alanarzamendi/planetary-gearbox-25-1/Report/Design_Rationale.html

DESIGN NOTEBOOK · TWO-STAGE PLANETARY GEARBOX

# Design rationale of the 25:1 planetary gearbox

The mathematics, standards and decisions behind the design: kinematics, load cases, gear capacity to ISO 6336, materials, bearings, shafts, fits and efficiency. Reasoning only; part dimensions live in the drawings.

Updated: 5 Nov 2026Plan steps covered: 2 to 9 (FEA, DFMA)Reproducible calculation: Calculations/02_design_calculations.py

## 01Kinematics and assembly conditions

Architecture: fixed ring, sun input and carrier output in both stages, three planets per stage. The Willis equation relates the speeds of the three members as seen from the carrier:

\[ \frac{\omega_s-\omega_c}{\omega_r-\omega_c} = -\frac{z_r}{z_s} \quad\xrightarrow{\;\omega_r=0\;}\quad i=\frac{\omega_s}{\omega_c}=1+\frac{z_r}{z_s}=1+\frac{72}{18}=5 \]

\[ i_{tot}=i_1\, i_2 = 5\cdot 5 = 25 \qquad n_2=\frac{3000}{25}=120\ \text{rpm} \]

Planet speed, absolute and relative to the carrier. The relative speed is what the teeth and the planet bearing see:

\[ \omega_p = \omega_c\left(1-\frac{z_r}{z_p}\right)=-\tfrac{5}{3}\,\omega_c \qquad n_{p,rel}=(n_s-n_c)\,\frac{z_s}{z_p} \]

### Geometric conditions (18/27/72, N = 3)

Condition | Equation | Value | Result
Coaxiality | \(z_r = z_s + 2z_p\) | 72 = 18 + 54 | pass
Equal-spacing assembly | \((z_s+z_r)/N \in \mathbb{Z}\) | 90 / 3 = 30 | pass
Adjacency (planets clear each other) | \(2a\sin(\pi/N) > d_{a,p}\) | 58.46 > 43.5 mm | 15 mm clearance
No undercut with x = 0 | \(z_{min}=2/\sin^2\alpha\) | 17.1 < 18 | pass

### Tooth phasing in the CAD assembly

Interference detection on all ten gears was run at the assembled pose and again after turning the input 7.3°, which is not a multiple of any tooth pitch. Every mesh engages. The largest overlap is 0.003 cm³, on the stage 1 ring and planet 1. That is a sliver of about 0.2 mm² across the 15 mm face width, or a few hundredths of a millimetre on the flank. A planet out of phase by half a pitch would overlap by about 0.045 cm³ per tooth. The overlaps come from the nominal profiles, which are modelled with zero backlash. The tooth thinning for backlash set in step 8 must be larger than this, on the stage 1 ring mesh in particular.

Speeds at 3000 rpm | \(n_s\) | \(n_c\) | \(n_s-n_c\) | \(n_{p,rel}\)
Stage 1 | 3000 | 600 | 2400 | 1600
Stage 2 | 600 | 120 | 480 | 320

## 02Torque basis and load cases

The design torque comes from the selected motor, not from an assumed number. Strength checks take \(\eta = 1\): all motor torque reaches every gear, which is the upper bound.

MotorYaskawa SGM7J-08A

Rated torque \(T_N\)2.39 N·m

Peak torque \(T_{max}\)8.36 N·m

Rated / max speed3000 / 6000 rpm

\[ T_{2N}=i\,T_N=25\cdot 2.39=59.8\ \text{N·m} \qquad T_{2B}=i\,T_{max}=25\cdot 8.36=209\ \text{N·m} \]

Case | Input torque | Factors | Cycles | Used for
Fatigue | 2.39 N·m | \(K_A=1.25\) | 10 000 h at 3000 rpm | pitting, bending, L10 life
Static / peak | 8.36 N·m | \(K_A=1.0\) | few cycles (static \(Z_{NT}, Y_{NT}\)) | overload, bearing \(S_0\)

Minimum safety factor | Value | Reason
Tooth bending \(S_{F,min}\) | 1.5 | a broken tooth is catastrophic (R-016)
Contact \(S_{H,min}\) | 1.2 | pitting is progressive and detectable
Bearing static \(S_0\) | 2.0 | starts and stops with shock
Shaft fatigue (simplified method) | 2.0 | margin for a method simpler than DIN 743

D-005 · Torque basis

Sizing uses the SGM7J-08A (2.39 / 8.36 N·m). It replaces the provisional 4 N·m in the requirements sheet and the 120 N·m overload, which had no physical origin. The motor's real peak gives 209 N·m, more demanding than those 120.

D-006 · Application factor

\(K_A = 1.25\): servo motor (uniform driver) with a driven machine of moderate shocks, from the guidance table of ISO 6336-6. The 10 000 h life is taken entirely at rated torque and speed, a harsher profile than a real servo duty cycle.

Confirmed for the 200 V SGM7J-08A: 2.39 N·m rated, 8.36 N·m instantaneous peak, 3000/6000 rpm, 80 mm flange, Ø19 shaft (Yaskawa Σ-7 transition guide and distributor datasheets). The motor's own bearings allow 392 N radial and 147 N axial on its shaft, a limit the coupling must respect (section 12).

## 03Gear geometry

Module \(m = 1.5\) mm, \(\alpha = 20^\circ\), spur teeth without profile shift (\(x=0\)), ISO 53 profile A basic rack (\(h_{aP}=1.0m,\ h_{fP}=1.25m,\ \rho_{fP}=0.38m\)), face width \(b = 15\) mm.

\[ d=m\,z \qquad d_b=d\cos\alpha \qquad d_a=d+2m \qquad d_f=d-2.5m \qquad a=\tfrac{1}{2}(d_s+d_p)=33.75\ \text{mm} \]

Transverse contact ratio (external sun–planet; in the internal mesh the ring tip radius is subtracted):

\[ \varepsilon_\alpha=\frac{\sqrt{r_{a1}^2-r_{b1}^2}+\sqrt{r_{a2}^2-r_{b2}^2}-a\sin\alpha}{\pi m\cos\alpha} \qquad \varepsilon_{\alpha,int}=\frac{\sqrt{r_{a2}^2-r_{b2}^2}-\sqrt{r_{a3}^2-r_{b3}^2}+a\sin\alpha}{\pi m\cos\alpha} \]

Mesh | \(\varepsilon_\alpha\) | Comment
Sun–planet (external) | 1.580 | > 1.4: continuous contact with margin
Planet–ring (internal) | 1.944 | the internal mesh wraps the tooth: more pairs in contact

### Rim thickness

ISO 6336-3 applies no rim penalty when \(s_R/h \ge 1.2\) (\(Y_B = 1\)), with tooth depth \(h = 2.25m = 3.375\) mm.

\[ \text{ring, at a tie-bolt hole: } s_R=\frac{128-6.6-111.75}{2}=4.83\ \text{mm}\ \Rightarrow\ \frac{s_R}{h}=1.43 \qquad \text{planet (}\varnothing18\text{ bore): } s_R=\frac{36.75-18}{2}=9.38\ \text{mm}\ \Rightarrow\ \frac{s_R}{h}=2.78 \]

The ring outside diameter is Ø140 since step 6 (section 17). Between the holes the rim is 14.1 mm; the thinnest section is under a Ø6.6 tie-bolt hole on the Ø128 circle.

## 04Tooth forces

Sun torque is shared by three planets. Tolerances make the sharing uneven, which \(K_\gamma\) accounts for:

\[ F_t=\frac{2000\,T_s}{d_s\,N}\,K_\gamma \qquad K_\gamma=1.16\ \ (\text{3 planets, no floating member; AGMA 6123}) \]

On the planet, the tangential forces from the sun and from the ring act in the same direction and the radial ones cancel, so the planet pin carries:

\[ F_{r,pin}=2F_t \]

Case | \(T_s\) [N·m] | \(F_t\) [N] | \(F_{r,pin}\) [N]
Stage 1, rated | 2.39 | 68 | 137
Stage 2, rated | 11.95 | 342 | 685
Stage 2, peak | 41.8 | 1197 | 2394

## 05Contact stress (ISO 6336-2)

\[ \sigma_H = Z_H Z_E Z_\varepsilon \sqrt{\frac{F_t}{d_1 b}\cdot\frac{u\pm1}{u}}\;\sqrt{K_A K_v K_{H\beta} K_{H\alpha}} \qquad (+\ \text{external},\ -\ \text{internal}) \]

\[ Z_H=\sqrt{\frac{2\cos\alpha}{\cos^2\alpha\,\sin\alpha}}=2.495 \qquad Z_E=189.8\sqrt{\text{MPa}} \qquad Z_\varepsilon=\sqrt{\frac{4-\varepsilon_\alpha}{3}} \]

\[ K_v=1+\left(\frac{K_1}{K_A F_t/b}+K_2\right)\frac{z_1 v}{100}\sqrt{\frac{u^2}{1+u^2}} \qquad K_1=14.9\ (\text{ISO 1328 grade 6}),\ K_2=0.0193 \]

\[ \sigma_{HP}=\frac{\sigma_{H,lim}\,Z_{NT}\,Z_L Z_v Z_R}{S_{H,min}} \]

Factor | Stage 1 | Stage 2 | Source
\(v\) relative to the carrier | 3.39 m/s | 0.68 m/s | \(\pi d_s (n_s-n_c)/60\,000\)
\(K_v\) | 1.086 | 1.017 | method C
\(K_{H\beta}\) | 1.15 | 1.15 | assumed: pins supported in both plates, \(b/d_1=0.56\); rechecked by method C in section 16
\(Z_\varepsilon\) sun–planet / planet–ring | 0.898 / 0.828 | | from \(\varepsilon_\alpha\)
Sun load cycles \(N_L\) | 4.3·10⁹ | 8.6·10⁸ | \(60\,L_h\,(n_s-n_c)\,N\)

Result (fatigue, rated) | \(\sigma_H\) [MPa] | \(S_H\)
Stage 1 · sun–planet | 282 | 4.61 | ≥ 1.2
Stage 1 · planet–ring | 130 | 5.26 | ≥ 1.2
Stage 2 · sun–planet | 610 | 2.18 | critical gear flank
Stage 2 · planet–ring | 281 | 2.42 | ≥ 1.2
Stage 2 · sun–planet, peak (static) | 1021 | 2.28 | ≥ 1.0

The ring is rated with its own material (42CrMo4 quenched and tempered) and its own cycles, \(60\,L_h\,n_c\,N\). Lubrication: grease with ISO VG 220 base oil; ground flanks (\(Z_R \approx 1\)).

## 06Tooth-root stress (ISO 6336-3, method B)

\[ \sigma_F=\frac{F_t}{b\,m}\,Y_F\,Y_S\,Y_\beta\,Y_B\;K_A K_v K_{F\beta} K_{F\alpha} \qquad K_{F\beta}=K_{H\beta}^{\,N_F},\ \ N_F=\frac{(b/h)^2}{1+b/h+(b/h)^2}=0.78 \]

\(Y_F\) is evaluated with the load at the outer point of single-pair contact, on the critical section at the 30° tangent to the root fillet:

\[ Y_F=\frac{6\,\dfrac{h_{Fe}}{m}\cos\alpha_{Fen}}{\left(\dfrac{s_{Fn}}{m}\right)^2\cos\alpha_n} \qquad Y_S=(1.2+0.13L)\,q_s^{\,1/(1.21+2.3/L)},\quad L=\frac{s_{Fn}}{h_{Fe}},\ q_s=\frac{s_{Fn}}{2\rho_F} \]

\[ \sigma_{FP}=\frac{\sigma_{F,lim}\,Y_{ST}\,Y_{NT}\,Y_M}{S_{F,min}} \qquad Y_{ST}=2 \qquad Y_M=0.7\ \text{for the planet} \]

The planet is an idler: each tooth is bent one way when it meshes with the sun and the other way with the ring. Reversed loading cuts fatigue strength to 70 % (\(Y_M = 0.7\)) and doubles the bending cycles.

Gear | \(Y_F\) | \(Y_S\) | \(\sigma_F\) rated S2 [MPa] | \(S_F\) rated S2 | \(S_F\) peak S2
Sun, z = 18 | 1.737 | 1.760 | 66 | 13.5 | 13.5
Planet, z = 27 | 1.554 | 1.858 | 62 | 10.2 | 10.0
Ring, z = −72 (rack, conservative bound) | 0.894 | 2.710 | 52 | 11.0 | 10.7

Bending does not limit the design: module 1.5 has a margin of ten or more. The module is set by space: the planet must hold an Ø18 bearing with a rim of \(s_R/h \ge 1.2\). With \(m = 1\) the planet rim would drop to 3.25 mm (\(s_R/h = 1.44\)) and the sun pitch diameter to 18 mm.

## 07Materials and heat treatment

Limit values to ISO 6336-5, quality MQ. For through-hardened steel the hardness lines apply:

\[ \sigma_{H,lim}=1.313\,HB+373 \qquad \sigma_{F,lim}=0.425\,HB+187 \qquad (HB = 300 \Rightarrow 767\ \text{and}\ 315\ \text{MPa}) \]

Material for the stage 2 sun | \(\sigma_{H,lim}\) | \(\sigma_{F,lim}\) | \(S_H\)
42CrMo4 quenched and tempered, ~300 HB | 767 | 315 | 1.07 | < 1.2, rejected
18CrNiMo7-6 case-hardened, 58–62 HRC | 1500 | 500 | 2.18 | selected

D-007 · Case-hardened suns and planets

18CrNiMo7-6, carburised and hardened to 58–62 HRC, ground after heat treatment. Through-hardened steel gives \(S_H = 1.07\) on the stage 2 sun. The same design is repeated in stage 1, so every external gear shares one material and one process.

D-008 · Through-hardened ring, not nitrided

42CrMo4 quenched and tempered to ~300 HB: \(S_H = 2.42\) in stage 2. The internal contact is concave–convex and its pressure is less than half of the sun's. The teeth are cut after tempering, so there is no heat-treatment distortion; nitriding would add cost for no gain.

D-009 · Planet pin as the raceway

100Cr6 hardened to 60 HRC and ground: a drawn-cup needle bearing has no inner ring, so the pin is the raceway. Its catalogue rating requires at least 58 HRC.

D-019 · Output shaft material

42CrMo4 +QT (EN 10083-3, 16 < d ≤ 40 mm: \(R_m \approx 1000\) MPa, \(R_e \ge 750\) MPa). Same steel family as the ring, tough enough for the keyless clamping hub and the bearing seats.

## 08Planet bearing and planet pin

HK1212 drawn-cup needle roller bearing (12 × 18 × 12 mm). The lowest rating among manufacturers is used: \(C_r = 6.27\) kN and \(C_{0r} = 7.3\) kN. Basic rating life to ISO 281, with the 10/3 exponent for roller bearings:

\[ L_{10}=\left(\frac{C_r}{P}\right)^{10/3}\ [10^6\ \text{rev}] \qquad L_{10h}=\frac{10^6\,L_{10}}{60\,n_{p,rel}} \qquad P=K_A\,F_{r,pin} \qquad S_0=\frac{C_{0r}}{F_{r,pin,max}} \]

Stage | \(P\) [N] | \(n_{p,rel}\) [rpm] | \(L_{10h}\) [h] | \(S_0\) (peak)
1 | 171 | 1600 | 1.7·10⁶ | — | ample
2 | 856 | 320 | 39 800 | 3.05 | ≥ 10 000 h, ≥ 2

### Planet pin, Ø12

Conservative model: simply supported beam between the carrier plates with a point load at mid-span. The span runs between plate mid-planes: the 15 mm gear, a 0.5 mm gap on each side and half of each plate. That gives \(l = 20\) mm in stage 1 (4 mm plates) and \(l = 22\) mm in stage 2 (6 mm plates).

\[ M=\frac{F\,l}{4} \qquad \sigma_b=\frac{32M}{\pi d^3} \qquad \tau=\frac{4}{3}\cdot\frac{F/2}{\pi d^2/4} \qquad \sigma_{vM}=\sqrt{\sigma_b^2+3\tau^2} \qquad \delta=\frac{F\,l^3}{48\,E\,I} \]

\[ F=2394\ \text{N (stage 2 peak)},\ l=22\ \text{mm}:\quad \sigma_{vM}=81\ \text{MPa}\ \Rightarrow\ S=\frac{1650}{81}=20 \qquad \delta=2.5\ \mu\text{m} \]

The pin bends symmetrically, because the planet sits mid-span, so this deflection moves the planet without tilting it. The mesh misalignment comes from the helix tolerance and the pin fit; it is worked out in section 16.

## 09Gearbox torque rating

For each criterion, the rated output torque \(T_{2N}\) that brings it exactly to its minimum is solved for, with \(K_A = 1.25\) and 10 000 h. The lowest value is the gearbox rating.

\[ T_{2N,adm}\big|_{L_{10h}} = T_{2N}\left(\frac{L_{10h}}{10\,000}\right)^{3/10}=59.8\cdot\left(\frac{39\,800}{10\,000}\right)^{0.3}\approx 90\ \text{N·m} \]

The contact bars use the assumed \(K_{H\beta} = 1.15\). With \(K_{H\beta}\) from the misalignment budget instead (section 16: M6 pin fit, flanks without crowning), stage 2 contact allows 113 N·m. That is still above 90, so the bearing still governs.

D-010 · Rating limited by the planet bearing

The gearbox is rated at about 90 N·m for 10 000 h, 1.5 times the motor's rated torque. The teeth would carry twice that; the limit is the bearing that fits inside a 40.5 mm planet. If more life were needed, the right move is a wider bearing (HK1216) or two in parallel, not a larger module.

D-011 · Two identical stages

Stage 1 runs at one fifth of the torque (\(S_H = 4.6\)) and could be narrower, but both stages keep \(m = 1.5\) and \(b = 15\). That gives one design of planet, pin, bearing and ring: half the part numbers, one set of tooling and no mix-ups at assembly.

## 10Output external loads and bearings

Two 32006 X tapered roller bearings (30 × 55 × 17 mm) in O arrangement with a 10 mm spacer. SKF lists \(C_r = 43.9\) kN, \(C_{0r} = 44\) kN, \(e = 0.43\), \(Y = 1.4\), \(Y_0 = 0.8\). The calculation uses \(C_r = 35.8\) kN, the lowest rating found for an interchangeable 32006 X, so any supplier's bearing meets the life. In an O arrangement each pressure centre sits outside the roller centre by:

\[ a_p=\frac{(d+D)\,e}{6}=\frac{85\cdot0.43}{6}=6.09\ \text{mm} \qquad L=27+2a_p=39.2\ \text{mm} \qquad x=20+23.5-a_p=37.4\ \text{mm} \]

\(L\): effective spread between pressure centres (midplanes 27 mm apart). \(x\): overhang from the load point, at mid-length of the 40 mm shaft extension, to the front pressure centre. The 23.5 mm from the shaft shoulder to the front bearing midplane comes from the CAD layout: KM6 locknut and washer (8 mm), Ø28 seal land (7 mm), half the bearing (8.5 mm). Diameters only step down toward the free end, so both cones slide on from the output side.

\[ R_A=F_{2r}\,\frac{L+x}{L} \qquad R_B=F_{2r}\,\frac{x}{L} \qquad F_{i}=\frac{0.5\,F_r}{Y} \]

\[ P=\begin{cases}F_r & F_a/F_r\le e\\ 0.4F_r+Y F_a & F_a/F_r> e\end{cases} \qquad L_{10h}=\left(\frac{C_r}{K_A P}\right)^{10/3}\frac{10^6}{60\,n_2} \qquad P_0=\max(F_r,\ 0.5F_r+Y_0F_a) \]

Each bearing's axial load comes from its induced force plus the external one, checked with \(F_{2a}\) acting in both directions. Allowable radial load per criterion, with \(F_{2a} = 0.5\,F_{2r}\):

Criterion | \(F_{2r,max}\) [kN]
Bearing life \(L_{10h} \ge 10\,000\) h at 120 rpm | 3.86 | governs
Shaft fatigue \(S \ge 2.0\) | 7.18
Bearing static \(S_0 \ge 2\) | 11.3
Shaft static \(S \ge 1.5\) at \(T_{2B}\) | 33.4

Check at the rated loads | Value
Front / rear reaction \(R_A,\ R_B\) | 5.86 / 2.86 kN
Lowest \(L_{10h}\) (rear bearing, axial load toward it) | 23 100 h
Lowest \(S_0\) | 7.5
Tilting moment \(M_{2k}=F_{2r}\,(x+L/2)\) | 171 N·m

D-014 · Rated output loads

\(F_{2r} = 3.0\) kN radial at mid-length of the shaft extension and \(F_{2a} = 1.5\) kN axial. That is 22 % below the governing limit of 3.86 kN, and gives 23 000 h, more than twice the life requirement, at \(K_A = 1.25\). The 2:1 radial-to-axial ratio follows common servo-gearbox catalogue practice. These loads cover a belt pulley, a pinion or a directly mounted arm.

D-015 · Tapered roller bearings in O arrangement

The O arrangement moves the pressure centres outward, adding 12 mm of effective spread and therefore tilting stiffness under overhung loads. It carries axial load in both directions, and a shaft locknut sets a light preload that removes running clearance, which matters for servo positioning. A pair of deep-groove ball bearings was rejected: lower tilting stiffness and no adjustable preload.

## 11Output shaft

Two sections are checked: the shoulder of the Ø25 extension (fillet r = 1) and the Ø30 bearing seat at the front pressure centre. Fatigue uses rotating bending, fully reversed, against a steady mean torque, combined by Goodman. The static check uses the peak torque.

\[ \sigma_N=0.5\,R_m\,K_d\,K_s=0.5\cdot1000\cdot0.85\cdot0.90=382.5\ \text{MPa} \]

\[ \sigma_a=\beta_b\,\frac{32M}{\pi d^3} \qquad \tau_m=\beta_t\,\frac{16\,K_A T_{2N}}{\pi d^3} \qquad \sigma_{m,eq}=\sqrt{\sigma_m^2+3\tau_m^2} \qquad S=\frac{1}{\sigma_a/\sigma_N+\sigma_{m,eq}/R_m} \]

\[ S_{st}=\frac{R_e}{\sqrt{\sigma^2+3\tau^2}},\qquad \tau=\frac{16\,T_{2B}}{\pi d^3} \]

Section | \(M\) [N·m] | \(\beta_b / \beta_t\) | \(\sigma_a\) [MPa] | \(\tau_m\) [MPa] | \(S\) fatigue | \(S\) static
Ø25 shoulder | 60.0 | 1.8 / 1.4 | 70.4 | 34.1 | 4.11 | 5.99
Ø30 bearing seat | 112.2 | 1.6 / 1.3 | 67.7 | 18.3 | 4.79 | 9.20

D-016 · Keyless output shaft, Ø25 h6

A parallel key has side clearance, which shows up as backlash in a servo axis, and its keyway is a notch with \(\beta \approx 2\)–2.3. At peak torque a DIN 6885 key 8 × 7 × 32 would also see a hub pressure of \(p = 2T/(d\,(h-t_1)\,l_{eff}) = 2\cdot209\,000/(25\cdot3\cdot24) = 232\) MPa, too high for an unknown customer hub. A clamping hub or shrink disc transmits the torque by friction, without backlash.

## 12Input side

Input shaft Ø12, integral with the stage 1 sun. The sun root diameter is 1.94 times the shaft diameter, so the sun body is never weakened by the shaft.

\[ \tau_{max}=\frac{16\,T_{max}}{\pi d^3}=\frac{16\cdot8360}{\pi\cdot12^3}=24.6\ \text{MPa} \quad\Rightarrow\quad S=\frac{R_e}{\sqrt3\,\tau}=17.6 \]

Three planets at 120° cancel each other's mesh forces on the sun, \(\sum \vec F = 0\) in the ideal case. The input bearings therefore carry only the coupling's restoring force and the shaft's weight, generously taken as 200 N per bearing:

\[ L_{10h}=\left(\frac{C_r}{K_A F_r}\right)^{3}\frac{10^6}{60\,n_1}=\left(\frac{7280}{250}\right)^3\frac{10^6}{60\cdot3000}=137\,000\ \text{h} \qquad v_{seal}=\frac{\pi\,d\,n_{max}}{60\,000}=3.77\ \text{m/s} \]

D-017 · Input bearings and coupling

Two 6201-2Z deep-groove ball bearings, chosen by shaft size, since load does not size them. Shields rather than contact seals keep friction low at 6000 rpm; a separate lip seal closes the gearbox, at a surface speed well within the usual limit for elastomer seals. The motor connects through a metal bellows coupling, torsionally stiff and free of backlash, rated at \(T_{KN} \ge 1.5\,T_{max} = 12.5\) N·m, with hub bores Ø19 (motor, confirmed) and Ø12 (gearbox).

The coupling also protects the motor: the force it puts on the motor shaft must stay below the motor's allowable radial load. With the 200 N design assumption the margin is \(392/200 = 1.96\), and a bellows coupling's lateral stiffness keeps the real force far lower for the misalignment a machined adapter flange allows.

## 13Fits (ISO 286)

Rule: the ring that rotates relative to the load gets interference, so it cannot creep. The ring under a stationary load gets a transition fit, so the floating bearing can slide axially. Bearing ring tolerances follow ISO 492, normal class. Clearance is positive and interference negative, in µm.

Joint | Nominal | Fit | Range [µm] | Reason
32006 X cone on output shaft | Ø30 | k6 | −25 … −2 | rotating inner-ring load
32006 X cup in housing | Ø55 | J7 | −12 … +31 | stationary outer-ring load
HK1212 cup in planet bore | Ø18 | N6 | press | steel housing; the drawn cup takes its round shape from the bore
Planet pin as raceway | Ø12 | h6 | running | gives normal running clearance with the N6 bore
Planet pin in bridge plate | Ø12 | R7 / h6 | −34 … −5 | press fit: holds the pin axially, pin does not turn
Planet pin in bolted plate | Ø12 | M6 / h6 | −15 … +7 | the pin is the dowel of the bolted plate; small play keeps it parallel
6201 on input shaft | Ø12 | j6 | −16 … +3 | rotating inner ring, light load
6201 in input housing | Ø32 | J7 | −11 … +25 | stationary outer ring, one bearing floats
Output shaft extension | Ø25 | h6 | — | standard for clamping hubs and shrink discs

A drawn cup has a thin pressed shell and no inner ring, so its running clearance depends on the bore and the pin rather than on the bearing. The manufacturer's recommendation for a steel housing is bore N6 (R6 in aluminium) and shaft h6, with the pin as raceway at ≥ 58 HRC, Ra ≈ 0.2 µm and roundness within IT3. The planet rim (9.4 mm) is thicker than the 6 mm below which thin-housing corrections apply.

Housing fits assume a steel or cast-iron housing. If the housing is aluminium (step 6), its bores grow more than the steel bearing rings as the gearbox warms up, by:

\[ \Delta d = d\,(\alpha_{Al}-\alpha_{St})\,\Delta T = 55\cdot(23-11.5)\cdot10^{-6}\cdot60 = 0.038\ \text{mm} \]

D-018 · Fits follow the load direction

Interference on every rotating-load ring and transition on stationary ones, as listed. If an aluminium housing is chosen, the housing fits move one class tighter (J7 → M7) to keep the outer rings seated at 80 °C.

## 14Interstage connection

The stage 1 carrier drives the stage 2 sun. The sun is a separate shaft-gear with an integral spline stub, pressed into a hub on the stage 1 rear carrier plate. The torque it carries is the stage 1 output:

\[ T_{s2}=i_1\,T_{in}: \qquad 5\cdot2.39=11.95\ \text{N·m (rated)} \qquad 5\cdot8.36=41.8\ \text{N·m (peak)} \]

Flank pressure of an involute spline (DIN 5480 W 16 × 1 × 14, engaged length \(L = 8\) mm, load-sharing factor \(\varphi = 0.75\), bearing depth \(h_w \approx 0.9m\)):

\[ p=\frac{2T}{d\,h_w\,L\,z\,\varphi} \qquad p_{rated}=28\ \text{MPa}\ \left(S=\tfrac{100}{28}=3.5\right) \qquad p_{peak}=79\ \text{MPa}\ \left(S=\tfrac{200}{79}=2.5\right) \]

\[ \tau_{peak}=\frac{16\,T}{\pi d_f^3}=\frac{16\cdot41\,800}{\pi\cdot13.8^3}=81\ \text{MPa} \quad\Rightarrow\quad S=\frac{R_e}{\sqrt3\,\tau}=\frac{800}{\sqrt3\cdot81}=5.7 \]

D-020 · Splined interstage, not one integral part

A single part (carrier plate plus sun) would save one joint. But its sun teeth would sit next to a Ø96 flange that blocks the grinding wheel, and the whole carrier would have to be carburised with the sun. As two parts, the sun is ground as a plain shaft-gear and case-hardened on its own, the carrier stays in 42CrMo4 +QT, and each stage can be assembled and run separately. An interference spline fit removes the spline's backlash. A Ø20 shoulder, below the sun root diameter of 23.25 mm, gives the axial stop and the grinding run-out. The intermediate member floats radially on six planets, which also helps load sharing.

## 15Carrier cages

Each carrier is a cage: one plate carries three bridges between the planets, and the opposite plate is screwed to them (3 × M5). The far plate passes half of every pin force back to the output plate through the bridges. They are modelled as guided beams between the plates, with a 16 mm gap and a 10 × 18 mm section:

\[ V=\frac{T_c/2}{r\,N} \qquad M=\frac{V\,l}{2} \qquad \sigma=\frac{M}{h\,t^2/6} \qquad \text{stage 2 peak: } V=1032\ \text{N},\ \sigma=27.5\ \text{MPa} \]

The bridges must clear the spinning planets. A bridge centred mid-way between two planets, at the planet-centre radius, has its nearest planet centre at \(u=a\cos(\pi/N)-a\) radially and \(w=a\sin(\pi/N)\) tangentially:

\[ c=\sqrt{\left(|u|-\tfrac{h}{2}\right)^2+\left(|w|-\tfrac{t}{2}\right)^2}-\frac{d_{a,p}}{2}=\sqrt{7.9^2+24.2^2}-21.75=3.7\ \text{mm} \]

Radially the bridge spans 24.75 to 42.75 mm, outside the sun tip (15 mm) and inside the ring tip (52.5 mm).

D-021 · Bolted cages, low-head screws on stage 2

The stage 2 rear plate sits 1 mm from the stage 1 carrier, which turns five times faster. Its screws are low-head DIN 7984 M5 in Ø10 × 3.5 counterbores inside the 6 mm plate, so nothing protrudes. The plate bore grows from Ø16 to Ø30 to pass the Ø26 spline hub with 2 mm radial clearance.

D-022 · Output shaft integral with the stage 2 carrier

The output plate and the output shaft are one 42CrMo4 +QT part. This removes a torque joint at the highest torque in the gearbox (209 N·m peak), along with its run-out. It also lets the bearing seats be ground in the same set-up as the pin bores.

## 16Planet thrust washers, pin retention and face-load factor

Each planet runs with a gap \(g = 0.5\) mm to each carrier plate. A floating washer of thickness \(t\) in each gap leaves an axial end float of:

\[ s=2\,(g-t)=2\,(0.5-0.4)=0.2\ \text{mm} \]

That is inside the usual 0.1–0.3 mm for planets. The drawn cup is 12 mm wide in a 15 mm planet, so it sits 1.5 mm below each face. The washer therefore bears on the planet face outside the cup and its 0.5 mm bore chamfer, on \(r = 9.5 \ldots 12\) mm:

\[ A=\pi\left(r_o^2-r_i^2\right)=\pi\left(12^2-9.5^2\right)=169\ \text{mm}^2 \qquad F_a=0.1\,F_t \qquad p=\frac{F_a}{A} \qquad v=\omega_{p,rel}\,\frac{r_i+r_o}{2} \]

Peak case (8.36 N·m, 6000 rpm) | \(F_a\) [N] | \(p\) [MPa] | \(v\) [m/s] | \(pv\) [MPa·m/s]
Stage 1 | 24 | 0.14 | 3.6 | 0.51
Stage 2 | 120 | 0.71 | 0.72 | 0.51

Both stages have the same \(pv\). Thrust scales with torque and sliding speed with the relative planet speed, and torque × speed is the power each stage passes. Clearance from the washer edge to the sun tip circle: \(a-r_o-r_{a,s}=33.75-12-15=6.75\) mm.

### Pin press fit (R7/h6 in the bridge plate)

Lamé equations for a solid pin in a ring. For the ring, the thinnest ligament (pin bore to the Ø96 plate edge, 8.25 mm) is taken as a ring of \(D_{eff} = 28.5\) mm, so \(Q = d/D_{eff} = 0.42\). The interference is reduced by surface smoothing, \(0.8\,(R_{z,pin}+R_{z,bore}) = 0.8\,(1+4) = 4\ \mu\)m:

\[ p=\frac{\delta-4\ \mu\text{m}}{d\left[\dfrac{1}{E}\left(\dfrac{1+Q^2}{1-Q^2}+\nu\right)+\dfrac{1-\nu}{E}\right]} \qquad F_{out}=\mu\,p\,\pi\,d\,L \qquad \sigma_{vM,hub}=p\sqrt{k^2+k+1},\ k=\frac{1+Q^2}{1-Q^2} \]

Interference | \(\delta\) [µm] | \(p\) [MPa] | \(F_{out}\) stage 1 / 2 [N] | \(\sigma_{vM,hub}\) [MPa]
minimum | 5 | 7 | 109 / 163 | 15
mean | 19.5 | 112 | 1 680 / 2 520 | 236
maximum | 34 | 216 | 3 260 / 4 880 | 457 \(\ (S=750/457=1.64)\)

With \(\mu = 0.1\) and \(L\) = plate thickness. The pin carries no axial load: planet thrust goes through the washer into the plate face, not into the pin. So even the minimum-interference push-out force only has to hold the pin against vibration.

### Face-load factor from the misalignment budget (ISO 6336-1, method C)

Helix slope tolerance for grade 6 (ISO 1328-1, class 5 base value × √2 per grade), with \(d = 40.5\) and \(b = 15\):

\[ f_{H\beta}=\sqrt2\left(0.07\sqrt d+0.45\sqrt b+3\right)=7.3\ \mu\text{m} \]

The pin is clamped in the bridge plate. At the bolted plate it can shift by half the maximum fit play \(c\), which tilts it across the face width \(b\) over the span \(l\):

\[ f_{pin}=\frac{c_{max}}{2}\cdot\frac{b}{l} \qquad F_{\beta x}=B\sqrt{f_{H\beta}^2+f_{pin}^2} \qquad F_{\beta y}=0.85\,F_{\beta x} \qquad c_{\gamma\beta}=0.85\,c_\gamma=17\ \tfrac{\text{N}}{\text{mm·µm}} \]

\[ K_{H\beta}=1+\frac{c_{\gamma\beta}F_{\beta y}}{2\,F_m/b}\ \ (\le 2) \qquad\text{otherwise}\qquad K_{H\beta}=\sqrt{\frac{2\,c_{\gamma\beta}F_{\beta y}}{F_m/b}} \qquad F_m=F_t K_A K_v \]

The shaft-bending term \(f_{sh}\) is taken as zero: the planet sits at mid-span and the sun floats. \(B = 1\) applies without flank modification and \(B = 0.5\) with helix crowning (ISO 6336-1, table 8). Stage 2 at the rated case, \(F_m/b = 29\) N/mm:

Bolted-plate fit | \(c_{max}\) [µm] | \(f_{pin}\) [µm] | Flanks | \(K_{H\beta}\) | \(S_{H,min}\)
M6 / h6 | 7 | 2.4 | not crowned | 2.77 | 1.41 | ≥ 1.2
M6 / h6 | 7 | 2.4 | helix crowning | 1.96 | 1.67 | selected
K7 / h6 | 17 | 5.8 | not crowned | 3.05 | 1.34 | rejected
K7 / h6 | 17 | 5.8 | helix crowning | 2.16 | 1.59

At these light loads the line load is small next to the mesh stiffness times the misalignment, so \(K_{H\beta}\) lands on its upper branch. There \(\sigma_H \propto T^{1/4}\) instead of \(T^{1/2}\): the factor is large, but the contact stress grows slowly. Stage 1 (\(F_m/b = 6.2\) N/mm) gives \(K_{H\beta} = 6.0\) and still has \(S_H = 2.0\). The lowest root safety in stage 2 is \(S_F = 5.1\).

D-023 · Floating hardened-steel thrust washers, 0.4 mm

Two washers per planet, Ø12.2 × Ø24 × 0.4 mm, in 1.8159 (51CrV4) hardened and tempered to 45–50 HRC. Without them the case-hardened planet face (about 60 HRC) would wear the 42CrMo4 +QT plate (about 30 HRC). The 0.4 mm thickness fits the existing 0.5 mm gaps with 0.2 mm end float, so no plate, bridge or shaft moves. A polymer washer could not be made that thin and still last, and with \(pv \approx 0.5\) MPa·m/s, greased steel is enough. The Ø24 outside diameter bears on the planet face outside the needle cup and stays 6.75 mm clear of the sun.

D-024 · Pins pressed into the bridge plate, M6 in the bolted plate

Assembly order:

1. Bolt the cage together.
2. Finish both pin bores in one set-up, so they are coaxial.
3. Slide the planets and washers in radially between the bridges.
4. Press each pin through the bolted plate and the needle bearing into the bridge plate.

R7 in the bridge plate holds the pin axially and stops it turning. M6 in the bolted plate makes the three pins the dowels of that plate, and its 7 µm maximum play keeps the pin tilt at 2.4 µm across the face. The cage can still be taken apart by pressing the pins out. K7 would assemble more easily, but its 17 µm play costs about 0.07 in \(S_H\).

D-025 · Helix crowning on the planets

The method C check replaces the assumed \(K_{H\beta} = 1.15\). Without crowning the stage 2 sun flank still passes with \(S_H = 1.41 \ge 1.2\). A light helix crowning on the planets, sized in step 8 against \(F_{\beta x}\), brings it to 1.67. It is cheap on a ground gear, and it also covers the tilt from housing and carrier tolerances that this budget leaves out.

## 17Housing, ring retention and mounting

The Ø140 limit (R-014) leaves 6.75 mm per side around a Ø126.5 ring. A housing sleeve around the rings would have no room for screws to join its sections. The rings therefore become the housing wall themselves, grown to Ø140. The stack is input housing | ring 1 | spacer | ring 2 | output housing, clamped by eight tie bolts through the ring rims and located by two dowels on the same Ø128 circle.

Every stationary part reacts torque in the same sense: the motor stator \(T_{in}\), ring 1 \((i-1)\,T_{in}\) and ring 2 \((i-1)\,i\,T_{in}\). The torque crossing each joint therefore grows toward the mounting:

\[ T_{J1}=T_{in} \qquad T_{J2,3}=i\,T_{in} \qquad T_{J4}=i^2\,T_{in}=T_{2B}=209\ \text{N·m (peak)} \]

### Tie bolts (VDI 2230)

8 × ISO 4762 M6 × 70 – 8.8, tightened to \(M_A = 10.1\) N·m (\(\mu_G = 0.12\), 90 % of \(R_{p0.2}\)), thread engaged 10.5 mm in the output flange. The clamped length is \(l_K = 59.5\) mm. Preload after the tightening scatter \(\alpha_A = 1.6\) and embedding \(f_Z\) (3 µm thread, 3 µm head, 2 µm at each of the 4 interfaces):

\[ F_Z=\frac{f_Z}{\delta_S+\delta_P}=\frac{14\ \mu\text{m}}{(13.3+0.46)\cdot10^{-6}\ \text{mm/N}}=1.02\ \text{kN} \qquad F_{V,min}=\frac{F_{M}}{\alpha_A}-F_Z=\frac{10.4}{1.6}-1.02=5.48\ \text{kN} \]

\(\delta_S\): bolt compliance (head, shank, free thread, engaged thread). \(\delta_P\): the clamped rim, taken as one eighth of the annulus between r = 56 and 70 mm, because over a 59.5 mm grip the pressure cone fills the rim. The load factor \(\Phi = \delta_P/(\delta_S+\delta_P) = 0.03\) is negligible, since no axial service load passes through this stack.

\[ T_{slip}=\mu_T\,n\,F_{V,min}\,\frac{d_{PCD}}{2}=0.15\cdot8\cdot5.48\cdot64=421\ \text{N·m} \qquad p=\frac{F_M}{\tfrac{\pi}{4}(d_w^2-d_h^2)}=\frac{10\,400}{34.9}=298\ \text{MPa} \]

Check | Value | Limit | \(S\)
Slip, ring 2 | output housing, at \(T_{2B}\) | 209 N·m | 421 N·m | 2.01 \(\ge 1.8\)
Slip, ring 1 | spacer | ring 2 | 41.8 N·m | 421 N·m | 10.1
Head pressure on EN-GJS-500-7 | 298 MPa | \(p_G = 750\) MPa | 2.5
Ring rim under a hole, \(s_R/h\) | 1.43 | 1.2 (\(Y_B = 1\)) | —

\(S \ge 1.8\) is the VDI 2230 value for transverse loads that reverse, which a servo axis does on every move. The dowels only locate the sections; the torque is carried by friction. The joint faces are sealed with an anaerobic flange sealant, which does not lower the friction.

### Bearing arrangement in the housings

Output: the two 32006 X cups sit on either side of a 10 mm housing collar (bore Ø48, inside the cup abutment range). The cones are clamped by the KM6 nut against the Ø36 shaft shoulder through a 10 mm inner spacer. The bearing setting, light preload or zero clearance, is the difference between the ground spacer and the collar widths, so tightening the nut fixes it rather than adjusts it. Input: the two 6201 are cross-located against a central housing collar (Ø27), and each takes one axial direction. This replaces the "one bearing floats" of D-017; with 20 mm between the bearings and the same material for shaft and housing, thermal expansion is negligible.

Output stack along the shaft, from the carrier:

- Ø36 shoulder.
- 32006 X rear, z −44 … −61.
- Cone spacer Ø30/Ø35 × 10.
- 32006 X front, z −71 … −88.
- MB 6 lock washer, DIN 5406, 1 mm. Its inner tab runs in a 6 mm shaft groove.
- KM 6 nut, Ø45 × 7, ending at z −96.
- A 1 mm running gap.
- The 28 × 42 × 7 seal on the Ø28 land, at z −97 … −104.

The seal cover is 9 mm thick, so the turning nut cannot touch it. The nut, washer and cone spacer turn with the output shaft, so they are mated to the carrier. The cups and the seal are stationary.

Input stack, from the sun:

- Ø15 shoulder.
- 6201-2Z, z 15 … 25.
- Ø27 housing collar.
- 6201-2Z, z 35 … 45.
- DIN 471 circlip, 12 × 1.
- The 12 × 32 × 7 seal at z 47 … 54.
- The bellows coupling, Ø50 envelope, z 55 … 123. Its gearbox hub covers z 55 … 75; its motor hub covers z 85 … 123 and takes the full 40 mm of the Ø19 shaft.

The two clamp screws line up with the Ø12 access holes at z 65 and 103. With all purchased parts modelled, the gearbox weighs 10.1 kg without the motor.

Fasteners in the model:

- Tie bolts: 8 × ISO 4762 M6 × 70 – 8.8, heads on the input flange at z = 25, engaging 10.5 mm in the output flange.
- Dowels: 2 × ISO 8734 Ø6 m6 × 60, through the whole stack from z 16 to −44. The holes are line-reamed with the stack clamped, so one pin locates all five sections.
- Seal cover: 4 × ISO 4762 M4 × 16, engaging 7 mm.
- Carrier cages: 3 × M5 per stage.

An interference check of all 67 non-gear parts finds only the threads engaged in their tap-drill holes, with the expected volumes, and nothing else.

### Carrier cage screws

One M5 – 8.8 per bridge clamps the bolted plate to the bridge: ISO 4762 M5 × 12 in stage 1, and DIN 7984 M5 × 10 sunk in the Ø10 counterbores in stage 2 (D-021), each engaging 7.5–8 mm in 42CrMo4. The bridge shear \(V\) from section 15 has to cross that joint:

\[ F_{V,min}=0.9\,\frac{F_M}{\alpha_A}=0.9\cdot\frac{6.9}{1.6}=3.88\ \text{kN} \qquad F_{R}=\mu_T\,F_{V,min}=0.58\ \text{kN} \]

Bridge shear | rated × \(K_A\) [N] | \(S\) friction | peak [N] | \(S\) friction
Stage 1 | 74 | 7.9 | 206 | 2.8
Stage 2 | 369 | 1.58 | 1 032 | 0.56

D-029 · Cage screws clamp, the planet pins locate

Friction alone holds the stage 2 cage in continuous operation (\(S = 1.58\)) but not at peak acceleration torque. There the bolted plate can shift by at most the 7 µm play of the M6 pin fit, and then the three pins carry the shear as dowels: 9 MPa in one pin even if it took the whole bridge force. This is the role D-024 already gave the M6 fit, so no extra dowels are needed. The screws are tightened to 5.9 N·m and secured with medium-strength thread locker. They see no service tension, because the planet loads close through the pins and bridges.

### Mounting

The gearbox mounts by the flange face at z = −46 mm, with 4 × M8 – 10.9 tapped through the flange. The Ø80 h7 bearing neck is the centring spigot, and it carries the radial load \(F_{2r}\) by form fit, so the bolts carry only torque and tilting moment:

\[ M=F_{2r}\,l=3.0\cdot77=231\ \text{N·m} \qquad F_{A,max}=\frac{2M}{n\,r}+\frac{F_{2a}}{n}=2.18\ \text{kN} \qquad F_t=\frac{T_{2B}}{n\,r}=0.82\ \text{kN} \]

\[ S_{slip}=\frac{\mu_T\,(F_{V,min}-F_{A,max})}{F_t}=\frac{0.15\,(15.75-2.18)}{0.82}=2.49 \qquad \sigma_{b,neck}=\frac{M}{W_b}=5.9\ \text{MPa} \]

The rated external loads (D-014) are combined with the peak torque, which is conservative. \(F_{V,min} = 0.9\,F_M/\alpha_A\) allows 10 % embedding in the customer's plate. The thread engages 1.44 d in the cast iron.

### Overall length (R-015)

Mounting face to motor face, z −46 to +125, gives \(L = 171\) mm. The input chain sets it: input shaft to z = 75, a bellows coupling from z 55 to 123, and an SGM7J-08 shaft 40 mm long that has to sit fully in the motor hub. The output shaft extension and the motor are excluded.

### Heat balance at the rated point

\[ \Delta T=\frac{P_{loss}}{\alpha\,A}=\frac{750\,(1-0.96)+10}{15\cdot0.096}=28\ \text{K} \qquad \text{pessimistic, }0.95\text{ per stage: } \frac{73}{1.44}=51\ \text{K} \]

\(A\) is the outer surface of the housing, rings and motor adapter. \(\alpha = 15\) W/(m²·K) is natural convection plus radiation from a painted surface, and the 10 W covers the input seal, the bearings and grease churning. At 25 °C ambient the housing stays at 53–76 °C, inside the 80 °C behind D-018 and the usual grease limit. Conduction into the machine is ignored, and so is heat from the motor flange; the two partly cancel.

D-026 · Ring gears as housing sections

The rings grow from Ø126.5 to Ø140 and take 8 × Ø6.6 tie-bolt holes and 2 × Ø6 dowel holes on Ø128. This gives the most material inside R-014, and the 42CrMo4 +QT rings become the stiffest part of the wall. The alternative, a sleeve around Ø126.5 rings, was rejected. With only a 6.75 mm wall, the input housing could not be screwed to it. Holding the rings by press fit alone would need an s6-class interference, and that shrinks the ring teeth by up to about 0.05 mm on diameter, which eats into backlash. The exposed ring OD gets black oxide.

D-027 · Housings in EN-GJS-500-7

Input and output housings in ductile iron. Its expansion (11.5 µm/(m·K)) matches the steel rings and bearings, so the dowels and the J7 bearing fits of D-018 stay valid hot. It damps gear noise better than steel and casts close to shape. Aluminium was rejected. It would save about 2 kg, but between the Ø128 dowels it would move 0.044 mm radially against the steel rings for a 60 K rise, and every housing fit would have to move to M7. The spacer and the seal cover are turned from C45. Masses from CAD: input housing 2.58 kg, output housing 1.74 kg, the two rings 0.69 kg each, spacer 0.49 kg and cover 0.24 kg. That is 6.4 kg of structure in a 9.2 kg gearbox as modelled, before the purchased parts.

D-028 · Flange at the ring stack; R-015 revised to 175 mm

The mounting flange sits on the output housing next to ring 2, where the wall is thickest, and the bearing neck forms the spigot. Moving the flange to the output end would add 50 mm. The 160 mm in R-015 was provisional and dated from before the coupling and motor shaft were known; it is revised to 175 mm, mounting face to motor face. The way to shorten the gearbox would be a hollow input shaft that clamps the motor shaft directly, the usual catalogue design. It is not adopted, because D-017 keeps the bellows coupling to protect the motor bearings.

## 18Backlash, gear inspection and tolerancing

### Backlash budget per mesh

ISO 1328-1 grade 6 single pitch deviation, the class 5 base value × √2:

\[ f_{pt}=\sqrt2\left(0.3\,(m+0.4\sqrt d)+4\right): \quad 7.2\ (\text{sun}),\ 7.4\ (\text{planet}),\ 8.1\ (\text{ring})\ \mu\text{m} \qquad f_{H\beta}=7.3\ \mu\text{m} \]

The tooth-thickness allowances must cover four things: a lubricant film, the effect of the gear deviations \(J_n\), the planet-centre position tolerance (Ø0.016, so \(f_a = 8\) µm radially) and a 10 K temperature difference between the gears and the carrier. All of these parts are steel.

\[ J_n=\sqrt{f_{pt,1}^2+f_{pt,2}^2+2\,(f_{H\beta}\sin\alpha)^2} \qquad j_{n,req}=j_{lube}+J_n+2f_a\sin\alpha+2a\,\alpha_{th}\Delta T\sin\alpha \]

\[ j_{n,min}=-(E_{sns,1}+E_{sns,2})\cos\alpha-J_n-2f_a\sin\alpha-\Delta j_{th} \qquad j_{n,max}=-(E_{sni,1}+E_{sni,2})\cos\alpha+2f_a\sin\alpha \]

Mesh | \(J_n\) [µm] | \(j_{n,req}\) [µm] | provided [µm] | \(j_n\) running min…max [µm]
Sun–planet | 10.9 | 29.0 | 32.9 | 13.9 … 75.9
Planet–ring | 11.5 | 29.6 | 32.9 | 13.3 … 75.9

With the input and the ring held, a carrier can turn until both meshes of a planet close. The planet translates by the mean of the two transverse backlashes, so:

\[ \Delta\varphi_c=\frac{j_{t,sp}+j_{t,pr}}{2a} \qquad \varphi_{out}=\Delta\varphi_{c2}+\frac{\Delta\varphi_{c1}}{i_2} \qquad j_t=\frac{j_n}{\cos\alpha} \]

Output backlash | min [arcmin] | max [arcmin]
Worst case, every allowance at its limit | 1.8 | 9.9
Statistical (uniform allowances, ±3σ) | 4.6 | 8.9

D-030 · Backlash class ≤ 10 arcmin, set by tooth thinning

Allowances in µm (upper / lower): sun −15 / −35, planets −20 / −40, rings −15 / −35. Profile shift stays at x = 0 (D-011). Backlash is set by thinning the teeth, which leaves the 18/27/72 centre distance and its assembly conditions untouched. The ≤ 10 arcmin class matches standard-backlash servo gearboxes. A reduced-backlash version (≤ 5 arcmin) would use grade 5 and the lower half of each band. The CAD models keep nominal, zero-backlash profiles, so the 0.003 cm³ flank overlaps of section 01 are expected. The drawings carry the allowances.

### Inspection dimensions (x = 0)

Span over \(k\) teeth for the external gears, and dimension over or between Ø2.5 balls, nominal and at the upper / lower allowance:

\[ W_k=m\cos\alpha\left[\pi(k-0.5)+z\,\mathrm{inv}\,\alpha\right] \qquad \mathrm{inv}\,\alpha_M=\frac{s}{d}+\mathrm{inv}\,\alpha\pm\frac{D_M}{d_b}-\frac{\pi}{z}\ (\text{ext.}) \]

Gear | \(k\) | \(W_k\) [mm] | \(M\) over/between balls Ø2.5 [mm]
Sun, z 18 | 2 | 7.020 → 7.006 / 6.988 | 30.262 → 30.227 / 30.180
Planet, z 27 | 3 | 11.638 → 11.619 / 11.600 | 43.713 → 43.664 / 43.615
Ring, z 72 (between balls) | — | — | 104.637 → 104.681 / 104.740

### Helix crowning (D-025 sized)

\[ F_{\beta x,0}=\sqrt{f_{H\beta}^2+f_{pin}^2}=7.7\ \mu\text{m} \qquad C_\beta\ge\frac{F_{\beta x,0}}{4}=1.9\ \mu\text{m} \qquad \frac{b_{contact}}{b}=\sqrt{\frac{F_m/b}{c_{\gamma\beta}\,C_\beta}} \]

\(C_\beta = 5 \pm 2\) µm, parabolic, on both flanks of the planets. That is enough slope at the face ends to keep the contact central under the full misalignment. The loaded width is 58 % of the face at the rated load (mesh deflection 1.7 µm) and 97 % at peak torque. Method C with \(B = 0.5\) (section 16) already includes this, giving \(S_H = 1.67\).

### Tolerance stacks

Stack | Specification | Result
Planet end float | bridge 16 ± 0.02, planet width 15 h8, washers 0.4 ± 0.02 | 0.14 … 0.29 mm
Input bearing axial play (cross-located) | shaft 30 +0.10/0, collar 10 −0.05/−0.10, 6201 width 0/−0.12 | 0.05 … 0.44 mm
Output bearing setting | cups measured on the collar, cone spacer ground to suit | 0 … 10 µm preload
Ring 2 to stage 2 planets, axial | housing collar 0.03, ring 0.02, carrier 0.05, bearing setting 0.05, planet float 0.15 | ≤ 0.30 (RSS 0.17) → \(b_{eff}\ge 14.7\) mm

### Datum scheme

Part | Datums | Key tolerances
Output carrier (PG25-305) | A: Ø30 k6 bearing seat; B: rear shoulder | runout Ø25 h6 0.010 A, Ø28 0.020 A; ⊥ B 0.008 A; pin bores ⌖ Ø0.012 A B, ∥ 0.005 A; plate face ⊥ 0.010 A
Output housing | A: common axis of the Ø55 J7 seats; B: mounting face | B ⊥ 0.010 A; spigot Ø80 h7 ◎ 0.020 A; dowel holes ⌖ Ø0.020 A B
Rings | A: joint face; B: dowel hole pattern | tooth runout to grade 6 relative to A B; faces ∥ 0.010
Input housing | A: Ø32 seats; B: joint face | motor spigot Ø70 H7 ◎ 0.030 A; motor face ⊥ 0.030 A
Planets, suns, pins | bore or bearing seats | faces ⊥ 0.010; pin Ø12 h6 cylindricity 0.003, Ra 0.2, ≥ 58 HRC

D-031 · Every gear and bearing is located from the bearing axis

Each part's primary datum is the bearing axis that locates it in service: the output bearing seats for the carrier and the output housing, the joint face plus the line-reamed dowels for the rings. The pin bores, the ring teeth and the mounting spigot are then all held to the same axis that the gears turn on. That keeps the planet-centre error \(f_a\) and the ring eccentricity within the 8 µm used in the backlash budget.

## 19Finite-element validation

Three linear-static studies in SOLIDWORKS Simulation check the hand calculations at the parts where the load path is least obvious. Each uses a high-quality (second-order) tetrahedral mesh and material data from the part's library entry. The studies are kept in Simulation/, either in a dedicated assembly or on a copy of the part, so the production parts carry no studies. Each region below is reported two ways. The 99th-percentile nodal stress is the nominal value and is the one compared with the hand calculation. The nodal peak is the local maximum, which includes corners and the edges of fixtures and loads.

Study | Load case | Restraints | Mesh
A · Stage 2 carrier cage: output plate with integral shaft, rear plate, 3 pins; contacts bonded | 209 N·m peak output torque, applied as a torque on the three pin surfaces | Ø25 output journal fixed | 2 mm · 247 k nodes
B · Output housing, EN-GJS-500-7 | F2r 3 kN + F2a 1.5 kN as bearing reactions (radial 5864 / 2864 N, axial 2094 / 3594 N on the cup shoulders); 209 N·m reaction torque on the ring face; tie-bolt preload 8 × 10.4 kN (FM,max = αA FM,min) on the tapped holes, reacted on the joint face | 4 M8 mounting holes fixed, mounting face on rollers | 2.5 mm · 200 k nodes
C · Stage 2 ring rim, defeatured: teeth removed, root Ø111.75 to Ø140, all holes kept | Three meshes, each with Ft = 167.2 N·m · Kγ / (3 r) = 1197 N and Fr = Ft tan α = 436 N, on ±2.5° windows of the root circle; one mesh lies directly over a tie-bolt hole (worst position) | 8 bolt and 2 dowel holes fixed | 1 mm · 812 k nodes

Region | Hand calc σvM [MPa] | FEA nominal [MPa] | FEA peak [MPa] | Sy at peak
Carrier bridge, bending (sec. 15) | 27.5 | 24.8 | 40.9 (sharp bridge root) | 18
Output shaft, Ø30 seat, torsion (sec. 11) | √3 · 39.4 = 68 | 86 (MB6 slot) | 122 (slot corner) | 6.2
Output shaft, Ø25 shoulder (sec. 11) | √3 · 68.1 = 118 | 137 | 154 (step beside the fixture) | 4.9
Carrier plates at the pin bores | — | 36 | 62 (bore edge) | 12
Housing neck, Ø80 tube (sec. 17) | √(5.9² + 3 · 2.68²) = 7.6 | 12.7 | 36.8 (flange–neck corner) | 8.7
Housing flange, away from holes | — | 20 | 39 | 8.2
Housing tie-bolt thread walls | √3 · FM/(π d3 l) = √3 · 57.6 = 100 | 142 | 216 (hole exit at the restrained face) | 1.5
Ring rim behind the teeth | — | 21 | 44 (edge of a load window) | 17
Ring at the tie-bolt hole under a mesh (4.8 mm ligament, sec. 17) | — | 8.8 | 21 | 35

Yield: 42CrMo4 750 MPa, 100Cr6 1650 MPa, EN-GJS-500-7 320 MPa. Where a hand calculation exists for the same nominal section, FEA agrees with it within the expected effect of local geometry: the bridges are within 10 %, and the shaft seat is 26 % higher because of the lock-washer slot. Every peak stays below yield at peak torque.

The planet pins are not compared. Study A spreads the pin load along the whole pin, including the lengths inside the plate bores, which understates pin bending (31 MPa against 81 MPa by hand). The hand calculation in section 08, with the load on the 12 mm needle track, stays the design value.

### Stiffness

\[ \varphi_c=\frac{u_t}{r}=\frac{0.080}{33.75}=2.4\ \text{mrad}=8.2\ \text{arcmin at }209\ \text{N·m} \;\Rightarrow\; k_{c2}\approx 88\ \text{N·m/mrad}\ (25\ \text{N·m/arcmin}) \]

This is the stage 2 carrier from the output journal to the pins, with bonded joints and the gear meshes left out, so it is an upper bound on its share of the drive's torsional compliance. The output-housing bearing seats deflect at most 7 µm (front) and 3 µm (rear) under F2r = 3 kN. That is small next to the bearing setting (0 to 10 µm preload, section 18).

D-032 · FEA checks the design; the hand calculations stay its basis

The acceptance criterion is Sy ≥ 1.5 on the nodal peak at peak load, ignoring singular points at the edges of fixtures and loads. All three studies pass with no geometry change. The lowest value, 1.5, is local: it is at the exit of a tie-bolt tapped hole under the upper-bound preload, where the thread load is modelled as a uniform traction on a smooth hole that meets the restrained face. That joint is governed by the VDI 2230 thread-engagement check (10.5 mm in GJS, section 17). The nominal wall stress there gives Sy = 2.3. The other peaks sit at internal corners that the CAD leaves sharp (MB6 slot, bridge roots, flange–neck corner), so the real filleted parts will be lower.

## 20Design for manufacture and assembly

### Materials and process routes

Family | Material and condition | Route | Basis
Suns and planets | 18CrNiMo7-6, case-carburised 58–62 HRC | turn → hob → carburise → grind seats and bores → profile-grind (planets crowned \(C_\beta = 5\) µm) | D-007, D-025
Ring gears | 42CrMo4 +QT 280–320 HB | forged ring → turn → shape the teeth after tempering → drill → ream dowels with the stack | D-008, D-026
Planet pins | 100Cr6 through-hardened 60 HRC | bar → harden → centreless grind h6 → superfinish Ra 0.2 | D-009
Carriers, output shaft | 42CrMo4 +QT, \(R_e \ge 750\) MPa | bar → turn → mill the bridges → jig-bore the pins → grind the seats in one set-up | D-019, D-022, D-031
Housings | EN-GJS-500-7, as cast | sand cast → machine the seats and spigot in one set-up → paint | D-027
Thrust washers | 51CrV4, 45–50 HRC | fine-blank from hardened strip → lap | D-023
Spacers, cover | C45 normalised | turn → grind the faces (cone spacer to the measured setting) | sec. 18

The gearbox has 73 parts: 37 made (18 part numbers, 9.18 kg) and 36 purchased (1.15 kg, coupling included), 10.3 kg in all. The two GJS castings make up 4.3 kg of that.

### Manual assembly analysis (Boothroyd–Dewhurst)

A part must exist on its own only if it moves relative to the parts already assembled, must be of a different material, or must be separate for assembly or service. The design efficiency compares the actual assembly time with an ideal 3 s for each necessary part:

\[ E_d=\frac{3\,N_{min}}{\sum N_i\,(t_{h,i}+t_{i,i})} \]

Design | Parts | \(N_{min}\) | Assembly time [s] | \(E_d\)
Prototype, as drawn | 73 | 34 | 607 | 16.8 %
Series variant (C1, C2, C3, C7) | 51 | 32 | 480 | 20.0 %

Fasteners, bearings and seals hold the efficiency down; a value around 20 % is typical for a bolted, serviceable gearbox. Seven candidate changes were evaluated:

Id | Change | Parts | Verdict
C1 | One-piece carrier cages. The planets go in radially between the bridges: the 16 mm gap is wider than the 15 mm face, and the ~48 mm opening is wider than the 43.5 mm tip diameter. The pin bores are line-bored through both walls. | −8 | series
C2 | Gas-nitrided cage thrust faces instead of 12 washers | −12 | series, after a wear test
C3 | Interstage spacer made integral with ring 1. It removes one joint: \(f_Z\) 14 → 12 µm. | −1 | accepted
C4 | Seal cover made integral with the housing | −5 | rejected: the Ø45 KM 6 nut cannot be reached through the Ø42 seal bore
C5 | Ring 2 made integral with the output housing | −1 | rejected: D-026 / D-027
C6 | 6 tie bolts instead of 8 | −2 | rejected: \(S_{slip}\) 2.01 → 1.51 < 1.8
C7 | Self-locking KMK 6 nut instead of KM 6 + MB 6 | −1 | accepted

D-033 · The prototype stays as drawn; the DFMA changes go to the series variant

C1, C2, C3 and C7 cut the part count by 30 % (73 → 51) and the manual assembly time by 21 % (607 → 480 s). Of these, C1 and C2 change the heat treatment and the machining strategy, and C2 needs a wear test. The prototype therefore keeps the bolted cages and floating washers (D-021, D-023), which are easier to make and inspect as single parts. The changes are recorded for a series release. Workbook: Report/PG25_DFMA_Materials_Processes.xlsx, generated by Calculations/03_dfma_materials.py.

## 21Efficiency

Mesh friction losses with Ohlendorf's loss factor, \(\mu = 0.05\), and the approach/recess split assumed equal:

\[ H_v=\frac{\pi(u\pm1)}{z_1\,u}\left(1-\varepsilon_\alpha+\varepsilon_1^2+\varepsilon_2^2\right) \qquad \eta_z = 1-\mu H_v \]

With the carrier held (basic efficiency \(\eta_0 = \eta_{sp}\,\eta_{pr}\), basic ratio \(i_0 = -z_r/z_s = -4\)) and the ring fixed in operation:

\[ \eta_{stage}=\frac{1-i_0\,\eta_0}{1-i_0}=\frac{1+4\,(0.9903\cdot0.9966)}{5}=0.9895 \]

\[ \eta_{tot}\approx(0.9895\cdot0.99)^2=0.96 \qquad T_{2N}\,\eta_{tot}=57.3\ \text{N·m} \qquad P_{loss}\approx 0.04\cdot 750=30\ \text{W} \]

The 0.99 per stage covers bearings and seals. No-load grease churning at 3000 rpm is not modelled, so the requirements sheet's estimate of 0.95 per stage stays as the pessimistic bound for the thermal check.

## 22Standards and tolerancing system

D-012 · GD&T to ISO GPS

ISO 1101 (geometrical tolerances), ISO 5459 (datums) and ISO 8015 (independency principle). This matches the rest of the project, which is already ISO: metric module ISO 54, fits ISO 286, gear accuracy ISO 1328 and screws ISO 4762. It is not mixed with ASME Y14.5.

D-013 · Gear accuracy ISO 1328 grade 6

The grade that matches ground flanks in a servo gearbox; it sets \(K_1 = 14.9\) in \(K_v\). Backlash and profile shift will be set with the tolerance analysis in step 8.

## 23Assumptions and limits of the calculation

- Sections 05, 06 and 09 use an assumed \(K_{H\beta} = 1.15\). Section 16 replaces it with ISO 6336-1 method C. For these lightly loaded, uncrowned flanks that gives \(K_{H\beta} = 2.77\) and a lowest \(S_H\) of 1.41 instead of 2.18. The 1.15 holds only together with the helix crowning set in D-025. Mesh stiffness \(c_\gamma = 20\) N/(mm·µm) is the ISO typical value for solid steel gears.
- Planet thrust is taken as 10 % of the tangential force. Straight spur teeth make none in theory, so this covers misalignment and friction.
- \(K_\gamma = 1.16\) comes from AGMA 6123, because ISO 6336 gives no tabulated value.
- Ring bending is bounded with a rack; a real internal tooth has a thicker root.
- Bearing ratings are the lowest found across manufacturers, so any supplier qualifies: HK1212 \(C_r = 6.27\) kN (INA lists 6.5), 32006 X \(C_r = 35.8\) kN (SKF lists 43.9, with the same \(e, Y, Y_0\)), 6201 \(C_r = 7.28\) kN.
- Shaft fatigue uses estimated notch factors \(\beta\) and a Goodman line, not a full DIN 743 calculation; the 2.0 minimum covers that.
- The 200 N input bearing load is an assumption for the coupling's restoring force.
- FEA (section 19) is linear-elastic. The carrier joints are bonded and the ring is modelled without teeth. The SOLIDWORKS library gives EN-GJS-500-7 an elastic modulus of 120 GPa, against 169 GPa in EN 1563, so the housing deflections are overstated by about 40 %; the stresses in its statically determinate load path are not affected.
- Housing joints: VDI 2230 table values for M6 / M8 preload (\(\mu_G = 0.12\)), \(\alpha_A = 1.6\), \(\mu_T = 0.15\) for dry machined steel and cast-iron faces, and \(p_G = 750\) MPa for EN-GJS-500-7. The SolidWorks library lists \(E = 120\) GPa for this grade; the calculation uses 169 GPa (EN 1563).
- Catalogue parts are modelled as envelopes with the catalogue boundary dimensions: 32006 X 30 × 55 × 17 with a 13 mm cup, KM 6 Ø45 × 7 with 4 slots 5 × 2, and MB 6 Ø30 / Ø49 × 1. The 32006 X housing abutment (Da 47–49 mm) comes from a distributor listing of an equivalent bearing. The MB 6 groove bottom (M = 27.5 mm, groove 6 mm wide) must be checked against the supplier's drawing.
- Motor interface, confirmed in the Yaskawa Sigma-7 200 V catalogue (SGM7J-08A): shaft S = Ø19 h6 × LR 40, spigot LB = Ø70 h7 × LE 3, flange LC 80 × LG 8, 4 × Ø7 on LA = Ø90, LL 97 mm, 2.2 kg without brake. With the 8 mm extra of a batteryless encoder or a holding brake, only the motor's own length changes; the interface does not.
- The spline is modelled in CAD by its major diameter; the DIN 5480 callout goes on the drawing. 100Cr6 is not in the SolidWorks library, so the pins use a project material, 1.3505 (100Cr6) hardened 60 HRC: \(E = 210\) GPa, \(\nu = 0.30\), \(\rho = 7810\) kg/m³, \(R_{p0.2} = 1650\) MPa (the value used in the pin check), \(R_m = 2200\) MPa. Thermal properties are typical handbook values for bearing steel.

Next: remaining part drawings (step 8), FEA and validation (step 9). Sources: ISO 6336-1/2/3/5/6, ISO 281, ISO 286, ISO 492, ISO 53, ISO 1328, EN 10083-3, EN 1563, VDI 2230, AGMA 6123; Yaskawa SGM7J catalogue; HK1212, 32006 X and 6201 datasheets from INA, SKF, NTN, FAG and Koyo.
