alanarzamendi/planetary-gearbox-25-1/Renders/PG25_SW_exploded_front.png

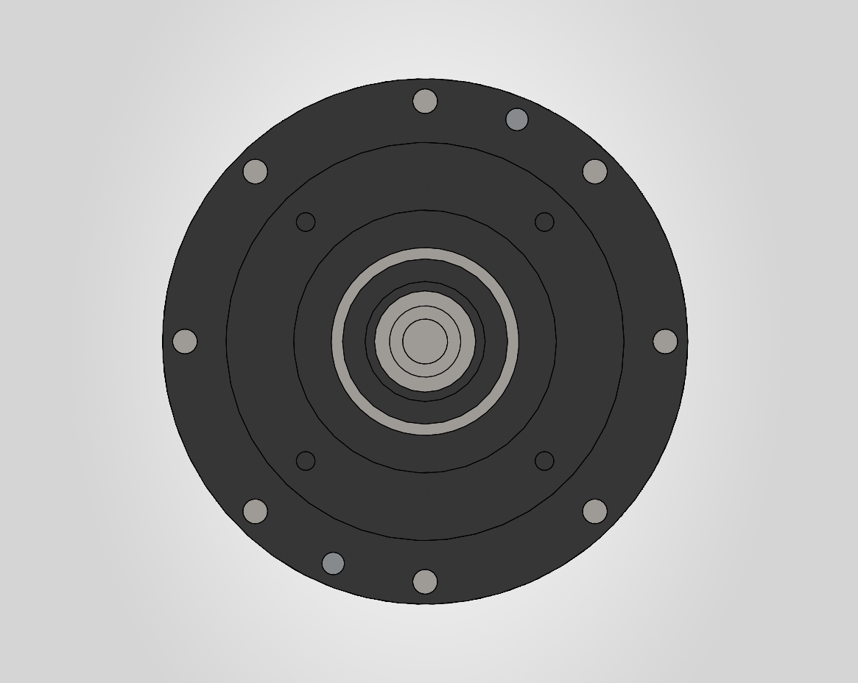
Renders/PG25_SW_exploded_front.png
