alanarzamendi/planetary-gearbox-25-1/Renders/PG25_SW_exploded_isometric.png

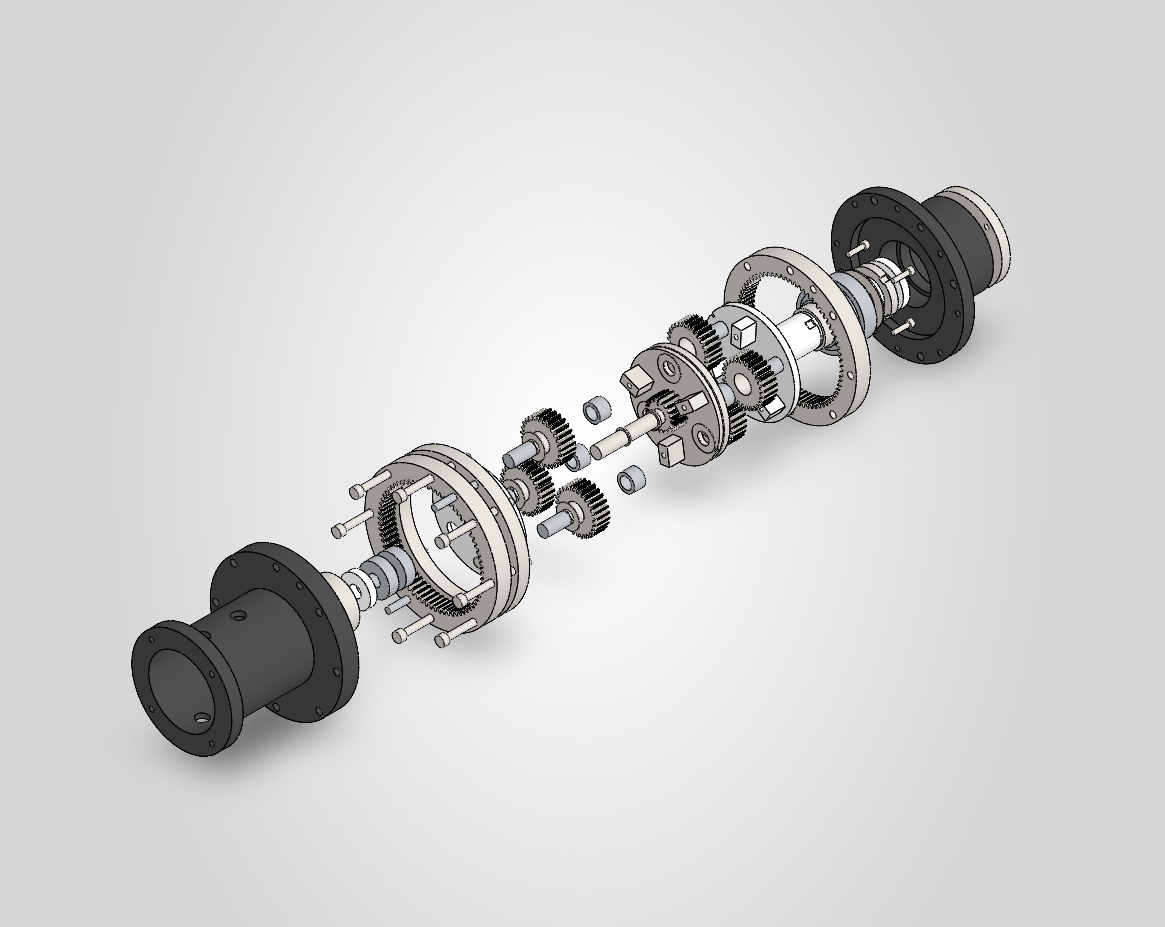
Renders/PG25_SW_exploded_isometric.png
