alanarzamendi/planetary-gearbox-25-1/Simulation/FEA_Output_Housing_vonMises_iso.png

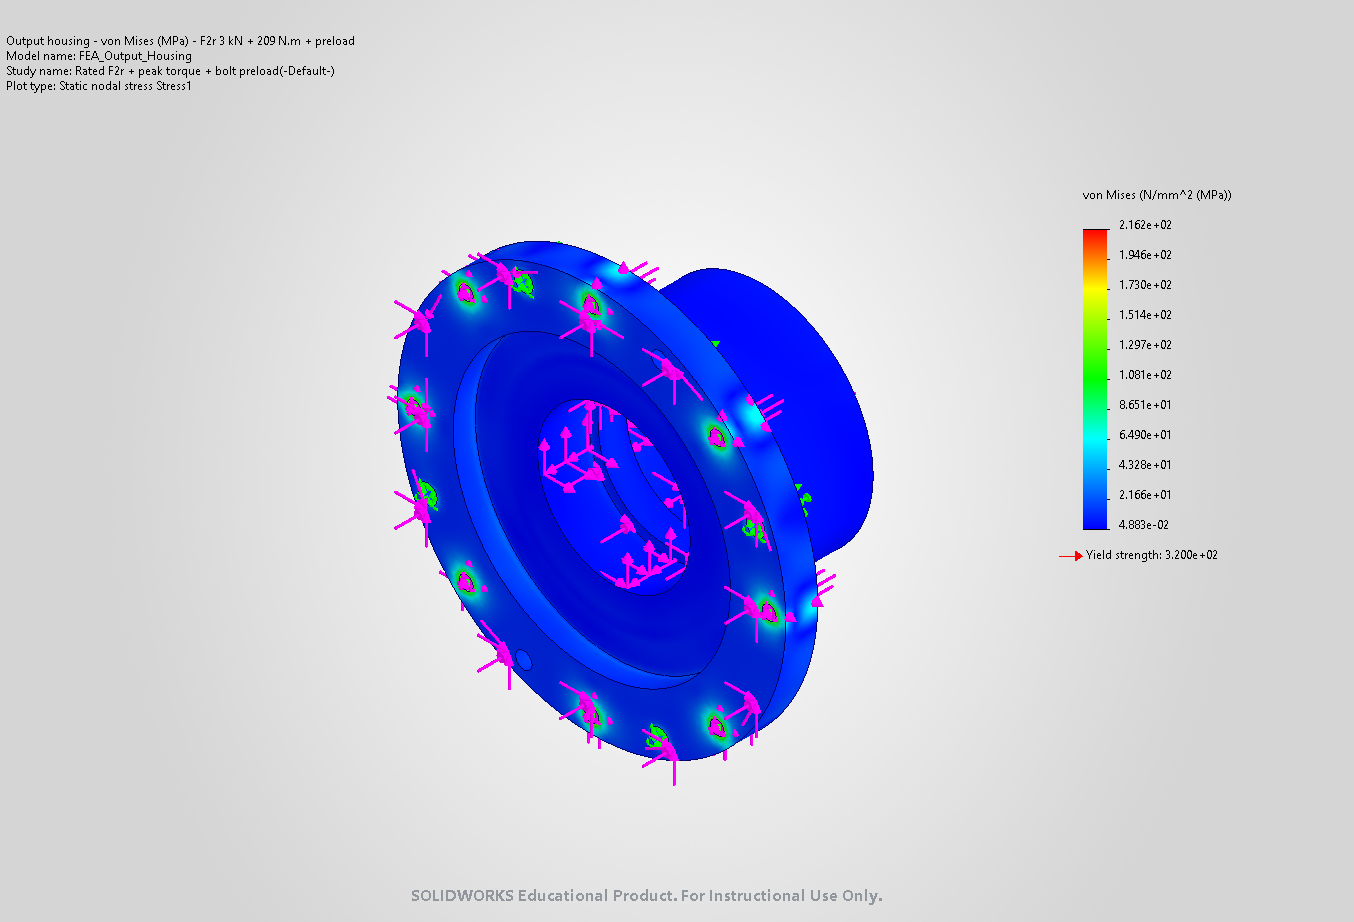
Simulation/FEA_Output_Housing_vonMises_iso.png
