alanarzamendi/planetary-gearbox-25-1/Simulation/FEA_Stage2_Carrier_vonMises_trimetric.png

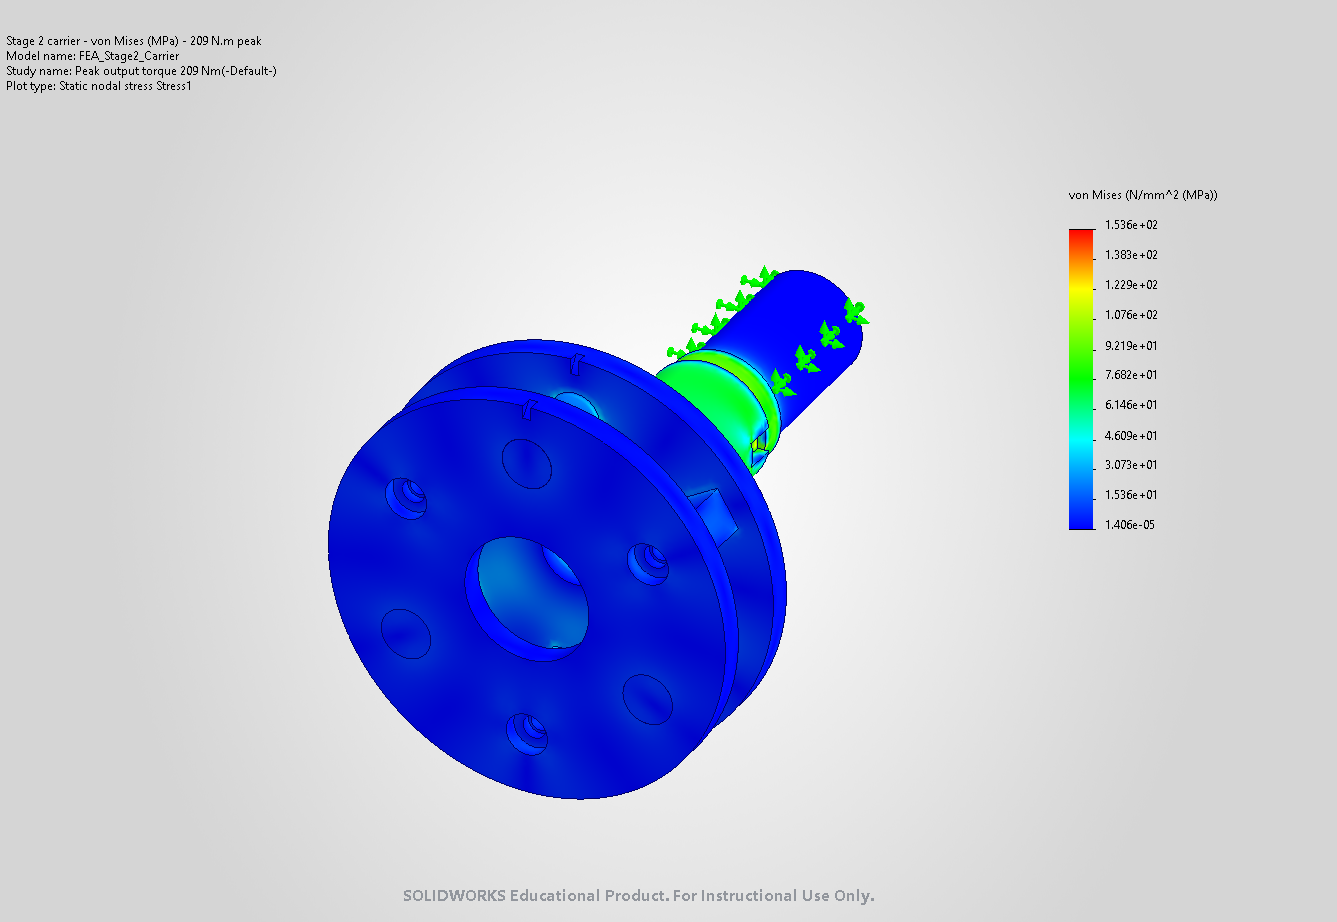
Simulation/FEA_Stage2_Carrier_vonMises_trimetric.png
