alanarzamendi/planetary-gearbox-25-1/Simulation/FEA_Stage2_Ring_Rim_vonMises.png

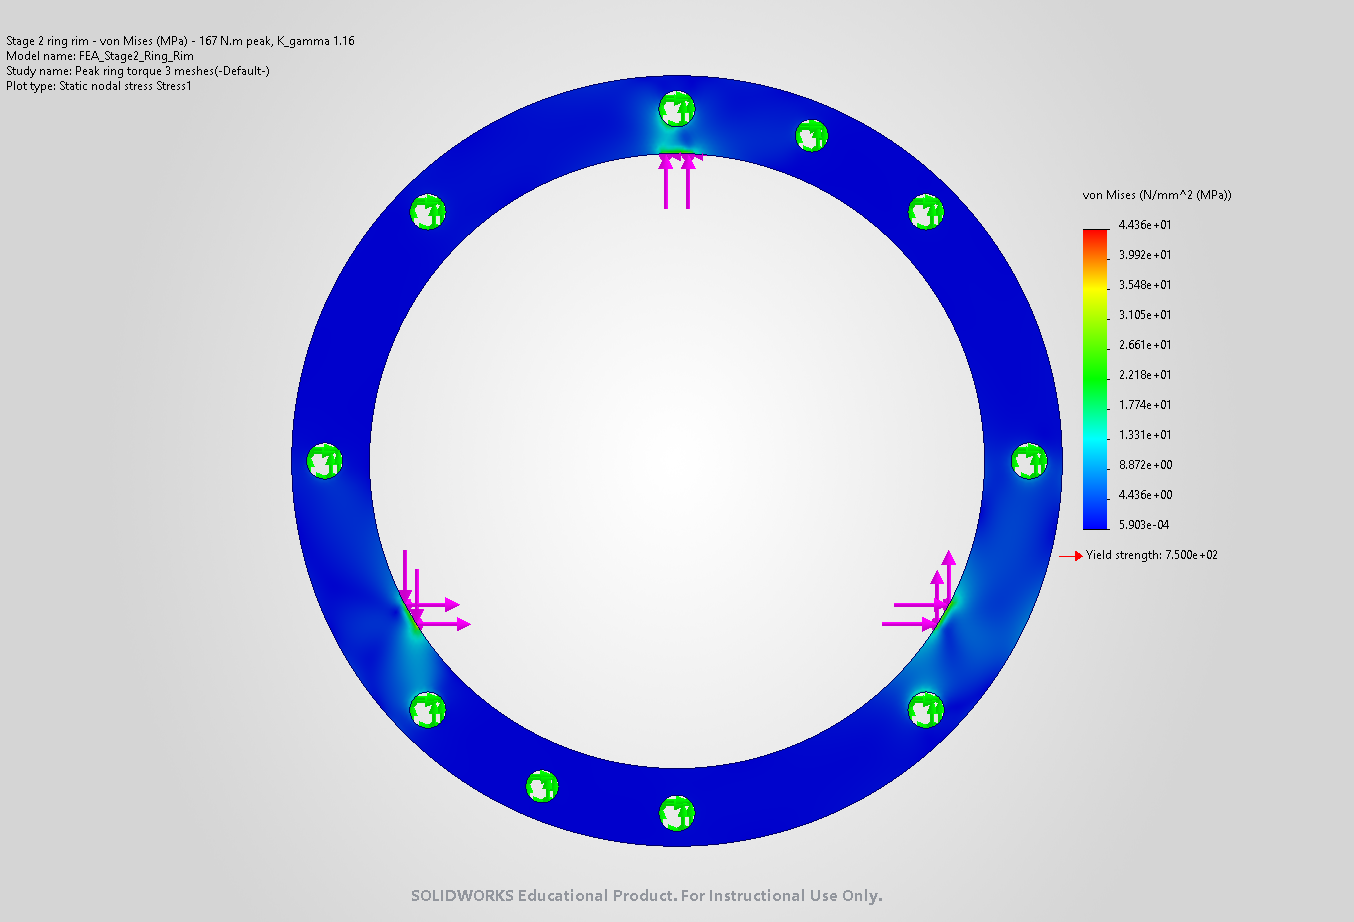
Simulation/FEA_Stage2_Ring_Rim_vonMises.png
