alanarzamendi/planetary-gearbox-25-1/Report/PG25_DFMA_Materials_Processes.xlsx

Sheet: Read me
PG25 - 25:1 two-stage planetary gearbox: DFMA analysis and materials & processes matrix
Step 9 of COMPLETION_PLAN.md. Generated by Calculations/03_dfma_materials.py (re-run the script to rebuild).
Sheets
Materials & Processes - every made part (material, heat treatment, semi-finished form, process route, critical features, why, alternative) and every purchased part, with masses.
B-D times - Boothroyd-Dewhurst manual handling and insertion times used by the DFMA sheets (looked up by code).
DFMA Current - manual assembly analysis of the design as modelled and drawn (73 parts).
DFMA Variant - the same sequence with the accepted DFMA changes for series production.
Comparison - part count, assembly time, theoretical minimum part count and design efficiency of both, plus every candidate change with its verdict.
Legend
Blue text = input (quantity, code, criteria answer, CAD mass). Black text = formula. Green text = link to another sheet. Yellow fill = key result.
Edit only blue cells. The DFMA sheets look up handling and insertion times from the codes in 'B-D times'.
Method
Boothroyd-Dewhurst DFA: for each part, three questions decide whether it must exist as a separate part:
(1) does it move relative to the parts already assembled? (2) must it be of a different material, or isolated? (3) must it be separate for assembly or service?
A part that answers 'no' to all three is a candidate for elimination or combination. N_min = sum of the parts that must exist.
Design efficiency E = 3 s x N_min / total manual assembly time (3 s = ideal time per part).
Sources and assumptions
Handling and insertion times: Boothroyd, Dewhurst & Knight, Product Design for Manufacture and Assembly, 3rd ed., CRC Press 2011, manual handling and insertion charts (rounded values).
Times marked 'assumed' in 'B-D times' (heavy part, press fits, torque-wrench screws, bearing setting, sealant) are estimates for this product; they are not from the charts.
Quantities and masses: SOLIDWORKS top assembly Planetary_Gearbox_2_stage.SLDASM, read through the API on 2026-11-05 (master layout excluded).
Materials, heat treatments and decisions D-xxx: Report/Design_Rationale.html.

Sheet: Materials & Processes
Materials and processes matrix - made parts
Part no. | Part | Qty | Material | Condition / heat treatment | Semi-finished form | Process route | Finish and critical features | Why this material and process | Alternative considered | Mass each [kg] | Mass total [kg]
PG25-101 | Input shaft with sun 1, z18 | 1 | 18CrNiMo7-6 (1.6587) | Case-carburised 58-62 HRC, CHD 0.3-0.5 mm, core ~1100 MPa | Bar Ø32 | Turn → hob teeth → carburise, harden, temper → grind bearing seats and journal → profile-grind teeth | Seats j6, coupling journal h6, radial run-out to the seats; teeth ISO 1328 grade 6 | D-007: through-hardened steel gives S_H 1.07; one material for all external gears | 20MnCr5 (cheaper, lower core strength); separate sun on a spline (rejected: extra joint at the input) | 0.126 | 0.126
PG25-301 | Sun 2 with DIN 5480 stub, z18 | 1 | 18CrNiMo7-6 (1.6587) | Case-carburised 58-62 HRC | Bar Ø28 | Turn → hob teeth, hob or shape the W16x1x14 spline → carburise → grind teeth and shoulder face | Shoulder face ⟂ to the axis; spline 8f; teeth grade 6 | D-007, D-020 (spline, not integral) | Integral with the stage 1 carrier (rejected, D-020: heat treatment and assembly) | 0.086 | 0.086
PG25-202 / 303 | Planet gear z27, crowned | 6 | 18CrNiMo7-6 (1.6587) | Case-carburised 58-62 HRC | Bar Ø48 or forged blank | Turn → hob → carburise → grind bore and faces → profile-grind with Cβ = 5 µm crowning | Bore Ø18 N6 for HK1212; faces ⟂ 0.010; crowning 5 ± 2 µm (D-025) | D-007; crowning per D-025 | Shaving before heat treatment (cheaper, grade 7-8: rejected for D-013 grade 6) | 0.119 | 0.713
PG25-201 / 302 | Ring gear z72, housing section | 2 | 42CrMo4 (1.7225) | +QT 280-320 HB, teeth cut after tempering | Ring forging or thick tube | Turn → shape internal teeth → finish-shape/grind → drill 8 x Ø6.6 → ream dowels with the stack → black oxide | Joint faces ∥ 0.010, Ra 0.8; tooth run-out to datum A and the dowels; Mdi 104.681/104.740 | D-008: S_H 2.42 without nitriding; D-026: ring is a housing section | Nitrided 31CrMoV9 (rejected, D-008: cost, no gain); GJS housing with an inserted ring (rejected, D-026) | 0.691 | 1.381
PG25-203 / 304 | Planet pin d12 | 6 | 100Cr6 (1.3505) | Through-hardened 60 HRC (min 58) | Ground bar Ø12.5 | Saw → turn chamfers → harden and temper → centreless grind → superfinish | Ø12 h6, cylindricity 0.003, Ra 0.2 (needle raceway) | D-009: the pin is the needle raceway | Standard hardened shaft from a bearing maker (cost option; fit must stay h6) | 0.021 | 0.127
PG25-204 | Carrier plate 1, input side | 1 | 42CrMo4 (1.7225) | +QT | Plate / bar Ø100 | Turn → drill and jig-bore pin bores → counterbore screw holes | Pin bores ⌖ Ø0.012 to A B | D-019 family; D-021 bolted cage | One-piece cage (DFMA C1) | 0.207 | 0.207
PG25-205 | Carrier plate 1, bridges + spline hub | 1 | 42CrMo4 (1.7225) | +QT | Bar Ø100 | Turn → mill bridges → broach or shape the internal spline → drill/tap M5 → jig-bore pin bores | Pin bores R7 press fit (D-024); spline 9H | D-021, D-024 | One-piece cage (DFMA C1) | 0.283 | 0.283
PG25-305 | Output carrier with integral shaft | 1 | 42CrMo4 (1.7225) | +QT, Re >= 750 MPa (16 < d <= 40 mm) | Bar Ø100 | Turn → mill bridges and MB6 slot → thread M30x1.5 → jig-bore pin bores → grind bearing seats and output journal in one set-up | Ø30 k6 seats (datum A), Ø25 h6 run-out 0.010, shoulder ⟂ 0.008, pin bores ⌖ Ø0.012 | D-019, D-022: no torque joint at 209 N.m | Bolted shaft + plate (rejected, D-022) | 0.875 | 0.875
PG25-306 | Carrier plate 2, input side | 1 | 42CrMo4 (1.7225) | +QT | Plate / bar Ø100 | Turn → jig-bore pin bores → counterbore for DIN 7984 heads | Pin bores M6; counterbores Ø10 x 3.5 | D-021, D-024 | One-piece cage (DFMA C1) | 0.282 | 0.282
PG25-206 | Planet thrust washer 12.2x24x0.4 | 12 | 51CrV4 (1.8159) | Hardened and tempered 45-50 HRC | Hardened strip 0.4 mm | Fine-blank → deburr → lap | Thickness 0.4 ± 0.02 | D-023: floating hard washer against soft carrier faces | CuSn8 bronze or PTFE-faced (lower wear resistance); eliminate with nitrided cage (DFMA C2) | 0.001 | 0.012
PG25-401 | Cone spacer | 1 | C45 (1.0503) | Normalised | Tube / bar Ø40 | Turn → grind faces to the measured setting (selective fit) | Width ground to suit, faces ∥ 0.003 | Sets the TRB preload (sec. 18) | Spring preload (rejected: lower stiffness) | 0.020 | 0.020
PG25-501 | Output housing | 1 | EN-GJS-500-7 (0.7050) | As cast, ferritic-pearlitic | Sand casting | Cast → rough-turn → finish-turn Ø55 J7 seats and Ø80 h7 spigot in one set-up → drill/tap M8, M6 → ream dowels with the stack → paint | Seats J7 (datum A), mounting face ⟂ 0.010 A, spigot ◎ 0.020 A | D-027: damping, castability, machinability, cost | Steel weldment (no damping); 6082-T6 aluminium (rejected: expansion vs. bearing preload) | 1.737 | 1.737
PG25-503 | Input housing / motor adapter | 1 | EN-GJS-500-7 (0.7050) | As cast | Sand casting | Cast → turn Ø32 J7 seats and Ø70 H7 motor spigot → drill/tap → paint | Motor spigot ◎ 0.030 A, motor face ⟂ 0.030 A | D-027 | Aluminium 6082-T6 (lighter, acceptable: low loads on 6201 bearings); option for a lighter variant | 2.581 | 2.581
PG25-502 | Interstage spacer ring | 1 | C45 (1.0503) | Normalised | Thick tube | Turn → grind both faces → ream dowels with the stack | Faces ∥ 0.010, Ra 0.8 | Spaces the two ring gears (D-026) | Merge with ring 1 (DFMA C3) | 0.488 | 0.488
PG25-504 | Output seal cover | 1 | C45 (1.0503) | Normalised | Bar Ø100 | Turn → drill 4 x M4 clearance | Seal bore Ø42 H8 | Seal seat and nut access | Integral with the housing (DFMA C4, rejected) | 0.266 | 0.266
 | Made parts total | 37 |  |  |  |  |  |  |  |  | 9.184
Purchased parts
Item | Description | Qty | Material | Standard / rating | Supplier class |  |  |  |  | Mass each [kg] | Mass total [kg]
32006 X | Tapered roller bearing | 2 | 100Cr6 | ISO 355; C_r 35.8 kN (lowest catalogue) | Bearing maker |  |  |  |  | 0.193 | 0.386
HK1212 | Drawn-cup needle bearing | 6 | 100Cr6 | ISO 3245; C_r 6.27 kN | Bearing maker |  |  |  |  | 0.013 | 0.079
6201-2Z | Deep-groove ball bearing | 2 | 100Cr6 | ISO 15; C_r 7.28 kN | Bearing maker |  |  |  |  | 0.054 | 0.108
KM 6 / MB 6 | Lock nut and lock washer | 2 | C45 / S235JR | DIN 981 / DIN 5406 | Bearing maker |  |  |  |  | 0.028 | 0.055
DIN 3760 A | Radial shaft seals 12x32x7 and 28x42x7 | 2 | NBR | DIN 3760 | Seal maker |  |  |  |  | 0.006 | 0.012
DIN 471 | Retaining ring 12x1 | 1 | 51CrV4 | DIN 471 | Standard parts |  |  |  |  | 0.001 | 0.001
ISO 4762 M6x70 | Tie bolts 8.8 | 8 | Steel 8.8 | ISO 4762, 10.1 N.m | Standard parts |  |  |  |  | 0.019 | 0.153
ISO 4762 M5x12 | Cage screws stage 1, 8.8 | 3 | Steel 8.8 | ISO 4762 | Standard parts |  |  |  |  | 0.004 | 0.012
DIN 7984 M5x10 | Low-head cage screws stage 2, 8.8 | 3 | Steel 8.8 | DIN 7984 | Standard parts |  |  |  |  | 0.003 | 0.009
ISO 4762 M4x16 | Seal-cover screws, 8.8 | 4 | Steel 8.8 | ISO 4762 | Standard parts |  |  |  |  | 0.003 | 0.011
ISO 8734 6x60 | Dowel pins, hardened | 2 | 100Cr6 | ISO 8734 m6 | Standard parts |  |  |  |  | 0.013 | 0.026
Bellows coupling | Metal bellows coupling D50x68, 12/19 H7 | 1 | EN-AW 2024 / stainless bellows | T_KN >= 12.5 N.m | Coupling maker |  |  |  |  | 0.300 | 0.300
 | Purchased parts total | 36 |  |  |  |  |  |  |  |  | 1.153
 | Gearbox total (coupling included) | 73 |  |  |  |  |  |  |  |  | 10.34
 | of which EN-GJS castings |  |  |  |  |  |  |  |  |  | 4.318
Masses: SOLIDWORKS mass properties from the part material densities (bellows coupling: catalogue estimate).

Sheet: B-D times
Code | Time [s] | Description | Source
00 | 1.13 | Handling: alpha+beta < 360 deg, size > 15 mm, thickness > 2 mm | B-D chart
01 | 1.43 | Handling: alpha+beta < 360 deg, size 6-15 mm | B-D chart
02 | 1.88 | Handling: alpha+beta < 360 deg, size < 6 mm | B-D chart
03 | 1.69 | Handling: alpha+beta < 360 deg, thickness <= 2 mm, size > 6 mm (thin washer) | B-D chart
10 | 1.50 | Handling: 360 <= alpha+beta < 540 deg, size > 15 mm | B-D chart
11 | 1.80 | Handling: 360 <= alpha+beta < 540 deg, size 6-15 mm | B-D chart
30 | 1.95 | Handling: alpha+beta = 720 deg, size > 15 mm | B-D chart
H2 | 2.50 | Handling: heavy part (> 2 kg), two hands | assumed
-- | 0.00 | No handling (separate operation) | -
i00 | 1.50 | Insertion: added, not secured, easy to align | B-D chart
i01 | 2.50 | Insertion: not secured, alignment needed | B-D chart
i03 | 3.50 | Insertion: not secured, alignment and resistance | B-D chart
iP | 6.50 | Insertion: press fit with arbor press, aligned | assumed
iP2 | 9.00 | Insertion: tapered bearing, cone pressed on shaft and cup pressed into housing | assumed
iS | 6.00 | Insertion: screw, tightened immediately | B-D chart (38)
iST | 8.00 | Insertion: screw or nut tightened to a specified torque (torque wrench / hook spanner) | assumed
iC | 6.00 | Insertion: retaining ring with pliers | assumed
iM | 5.00 | Insertion: ring gear fitted over three planets, teeth phased by turning the input | assumed
sTab | 4.00 | Separate operation: bend a lock-washer tab into the nut slot | assumed
sSeal | 8.00 | Separate operation: apply anaerobic sealant to one joint face | assumed
sSet | 90.00 | Separate operation: measure bearing stand-off, grind the cone spacer, re-assemble (selective fit) | assumed

Sheet: DFMA Current
DFMA - current design (prototype, as modelled and drawn)
# | Group | Item / operation | Part no. / standard | Qty N | Row type | Handling code | t_h per item [s] | Insertion code | t_i per item [s] | Operation time [s] | Q1 moves? | Q2 different material? | Q3 separate for assembly / service? | N_min | Note
1 | Input subassembly | Input shaft with sun 1 (base part) | PG25-101 | 1 | Part | 10 | 1.50 | i00 | 1.50 | 3.0 | Y |  |  | 1 | Rotates.
2 | Input subassembly | Deep-groove ball bearing 6201-2Z | 6201-2Z | 2 | Part | 00 | 1.13 | iP | 6.50 | 15.3 | Y |  |  | 2 | Rolling elements move.
3 | Input subassembly | Retaining ring DIN 471 12x1 | DIN 471 | 1 | Part | 02 | 1.88 | iC | 6.00 | 7.9 | N | N | N | 0 | Fastener.
4 | Input subassembly | Input housing / motor adapter | PG25-503 | 1 | Part | H2 | 2.50 | iP | 6.50 | 9.0 | N | Y | Y | 1 | Motor interface; varies with the motor frame.
5 | Input subassembly | Radial shaft seal 12x32x7 | DIN 3760 | 1 | Part | 01 | 1.43 | iP | 6.50 | 7.9 | N | Y |  | 1 | NBR.
6 | Input subassembly | Bellows coupling, clamped | TKN 12.5 | 1 | Part | 10 | 1.50 | iST | 8.00 | 9.5 | Y | Y |  | 1 | Accommodates motor misalignment.
7 | Stage 1 cage | Carrier plate 1, bridges + spline hub (base) | PG25-205 | 1 | Part | 10 | 1.50 | i00 | 1.50 | 3.0 | Y |  |  | 1 | Rotates.
8 | Stage 1 cage | Planet thrust washer | PG25-206 | 6 | Part | 03 | 1.69 | i01 | 2.50 | 25.1 | N | Y | N | 0 | Candidate: hard thrust faces on the cage instead (C2).
9 | Stage 1 cage | Drawn-cup needle bearing HK1212 into planet | HK1212 | 3 | Part | 00 | 1.13 | iP | 6.50 | 22.9 | Y |  |  | 3 | Rolling elements move.
10 | Stage 1 cage | Planet gear z27 | PG25-202 | 3 | Part | 00 | 1.13 | i01 | 2.50 | 10.9 | Y |  |  | 3 | Rotates.
11 | Stage 1 cage | Planet pin d12 | PG25-203 | 3 | Part | 01 | 1.43 | iP | 6.50 | 23.8 | N | Y |  | 3 | 100Cr6 60 HRC raceway (D-009).
12 | Stage 1 cage | Carrier plate 1, input side | PG25-204 | 1 | Part | 10 | 1.50 | i03 | 3.50 | 5.0 | N | N | Y | 1 | Closes the cage after the planets; candidate one-piece cage (C1).
13 | Stage 1 cage | Cage screw ISO 4762 M5x12 | ISO 4762 | 3 | Part | 11 | 1.80 | iS | 6.00 | 23.4 | N | N | N | 0 | Fastener.
14 | Stage 1 cage | Sun 2 into the spline hub | PG25-301 | 1 | Part | 01 | 1.43 | i01 | 2.50 | 3.9 | Y |  |  | 1 | Rotates relative to stage 2 carrier.
15 | Stage 2 cage | Output carrier, plate + bridges + shaft (base) | PG25-305 | 1 | Part | 10 | 1.50 | i00 | 1.50 | 3.0 | Y |  |  | 1 | Rotates.
16 | Stage 2 cage | Planet thrust washer | PG25-206 | 6 | Part | 03 | 1.69 | i01 | 2.50 | 25.1 | N | Y | N | 0 | Candidate (C2).
17 | Stage 2 cage | Drawn-cup needle bearing HK1212 into planet | HK1212 | 3 | Part | 00 | 1.13 | iP | 6.50 | 22.9 | Y |  |  | 3
18 | Stage 2 cage | Planet gear z27 | PG25-303 | 3 | Part | 00 | 1.13 | i01 | 2.50 | 10.9 | Y |  |  | 3
19 | Stage 2 cage | Planet pin d12 | PG25-304 | 3 | Part | 01 | 1.43 | iP | 6.50 | 23.8 | N | Y |  | 3
20 | Stage 2 cage | Carrier plate 2, input side | PG25-306 | 1 | Part | 10 | 1.50 | i03 | 3.50 | 5.0 | N | N | Y | 1 | Candidate one-piece cage (C1).
21 | Stage 2 cage | Low-head screw DIN 7984 M5x10 | DIN 7984 | 3 | Part | 11 | 1.80 | iS | 6.00 | 23.4 | N | N | N | 0 | Fastener.
22 | Output | Tapered roller bearing 32006 X (cone + cup) | 32006 X | 2 | Part | 00 | 1.13 | iP2 | 9.00 | 20.3 | Y |  |  | 2
23 | Output | Output housing | PG25-501 | 1 | Part | 30 | 1.95 | i03 | 3.50 | 5.5 | N | N | N | 0 | Theoretical candidate: merge with ring 2 (C5, rejected).
24 | Output | Cone spacer, ground to setting | PG25-401 | 1 | Part | 01 | 1.43 | i00 | 1.50 | 2.9 | N | N | N | 0 | Sets preload; no part-count alternative without a spring preload.
25 | Output | Lock washer MB 6 | DIN 5406 | 1 | Part | 03 | 1.69 | i01 | 2.50 | 4.2 | N | N | N | 0 | Candidate: self-locking nut (C7).
26 | Output | Lock nut KM 6, tightened | KM 6 | 1 | Part | 01 | 1.43 | iST | 8.00 | 9.4 | N | N | N | 0 | Fastener.
27 | Output | Bend lock-washer tab | - | 1 | Operation | -- | 0.00 | sTab | 4.00 | 4.0 |  |  |  | 0 | Separate operation.
28 | Output | Bearing setting: measure, grind spacer, re-assemble | - | 1 | Operation | -- | 0.00 | sSet | 90.00 | 90.0 |  |  |  | 0 | Separate operation (selective fit, sec. 18).
29 | Output | Radial shaft seal 28x42x7 | DIN 3760 | 1 | Part | 01 | 1.43 | iP | 6.50 | 7.9 | N | Y |  | 1 | NBR.
30 | Output | Output seal cover | PG25-504 | 1 | Part | 10 | 1.50 | i01 | 2.50 | 4.0 | N | N | Y | 0 | Needed for KM 6 access (C4 rejected); theoretical 0.
31 | Output | Screw ISO 4762 M4x16 | ISO 4762 | 4 | Part | 11 | 1.80 | iS | 6.00 | 31.2 | N | N | N | 0 | Fastener.
32 | Housing stack | Ring gear 1 over stage 1 planets | PG25-201 | 1 | Part | 10 | 1.50 | iM | 5.00 | 6.5 | N | Y | Y | 1 | Toothed housing section (D-026).
33 | Housing stack | Interstage spacer ring | PG25-502 | 1 | Part | 10 | 1.50 | i01 | 2.50 | 4.0 | N | N | N | 0 | Candidate: merge with ring 1 (C3).
34 | Housing stack | Ring gear 2 over stage 2 planets | PG25-302 | 1 | Part | 10 | 1.50 | iM | 5.00 | 6.5 | N | Y | Y | 1
35 | Housing stack | Anaerobic sealant on joint faces | - | 4 | Operation | -- | 0.00 | sSeal | 8.00 | 32.0 |  |  |  | 0 | Separate operation, one per joint.
36 | Housing stack | Dowel pin ISO 8734 6x60 | ISO 8734 | 2 | Part | 01 | 1.43 | iP | 6.50 | 15.9 | N | N | N | 0 | Locator.
37 | Housing stack | Tie bolt ISO 4762 M6x70, 10.1 N.m | ISO 4762 | 8 | Part | 11 | 1.80 | iST | 8.00 | 78.4 | N | N | N | 0 | Fastener (C6: 6 bolts rejected).
 |  | Total parts |  | 73
 |  | Part line items (rows with qty > 0) |  | 34
 |  | Separate operations (count) |  | 6
 |  | Total manual assembly time [s] |  | 607.4
 |  | Theoretical minimum part count N_min |  | 34
 |  | Design efficiency E = 3 N_min / time |  | 16.8%
 |  | Candidates for elimination (parts - N_min) |  | 39

Sheet: DFMA Variant
DFMA - variant with the accepted changes C1, C2, C3, C7 (series production)
# | Group | Item / operation | Part no. / standard | Qty N | Row type | Handling code | t_h per item [s] | Insertion code | t_i per item [s] | Operation time [s] | Q1 moves? | Q2 different material? | Q3 separate for assembly / service? | N_min | Note
1 | Input subassembly | Input shaft with sun 1 (base part) | PG25-101 | 1 | Part | 10 | 1.50 | i00 | 1.50 | 3.0 | Y |  |  | 1 | Rotates.
2 | Input subassembly | Deep-groove ball bearing 6201-2Z | 6201-2Z | 2 | Part | 00 | 1.13 | iP | 6.50 | 15.3 | Y |  |  | 2 | Rolling elements move.
3 | Input subassembly | Retaining ring DIN 471 12x1 | DIN 471 | 1 | Part | 02 | 1.88 | iC | 6.00 | 7.9 | N | N | N | 0 | Fastener.
4 | Input subassembly | Input housing / motor adapter | PG25-503 | 1 | Part | H2 | 2.50 | iP | 6.50 | 9.0 | N | Y | Y | 1 | Motor interface; varies with the motor frame.
5 | Input subassembly | Radial shaft seal 12x32x7 | DIN 3760 | 1 | Part | 01 | 1.43 | iP | 6.50 | 7.9 | N | Y |  | 1 | NBR.
6 | Input subassembly | Bellows coupling, clamped | TKN 12.5 | 1 | Part | 10 | 1.50 | iST | 8.00 | 9.5 | Y | Y |  | 1 | Accommodates motor misalignment.
7 | Stage 1 cage | One-piece cage 1, windows milled, spline hub (base) | PG25-205 | 1 | Part | 10 | 1.50 | i00 | 1.50 | 3.0 | Y |  |  | 1 | C1: pin bores line-bored through both walls in one set-up.
8 | Stage 1 cage | Planet thrust washer | PG25-206 | 0 | Part | 03 | 1.69 | i01 | 2.50 | 0.0 | N | Y | N | 0 | Eliminated (C2): gas-nitrided cage thrust faces.
9 | Stage 1 cage | Drawn-cup needle bearing HK1212 into planet | HK1212 | 3 | Part | 00 | 1.13 | iP | 6.50 | 22.9 | Y |  |  | 3 | Rolling elements move.
10 | Stage 1 cage | Planet gear z27 | PG25-202 | 3 | Part | 00 | 1.13 | i01 | 2.50 | 10.9 | Y |  |  | 3 | Rotates.
11 | Stage 1 cage | Planet pin d12 | PG25-203 | 3 | Part | 01 | 1.43 | iP | 6.50 | 23.8 | N | Y |  | 3 | 100Cr6 60 HRC raceway (D-009).
12 | Stage 1 cage | Carrier plate 1, input side | PG25-204 | 0 | Part | 10 | 1.50 | i03 | 3.50 | 0.0 | N | N | Y | 0 | Eliminated (C1): one-piece cage, planets inserted radially between the bridges.
13 | Stage 1 cage | Cage screw ISO 4762 M5x12 | ISO 4762 | 0 | Part | 11 | 1.80 | iS | 6.00 | 0.0 | N | N | N | 0 | Eliminated with the bolted plate (C1).
14 | Stage 1 cage | Sun 2 into the spline hub | PG25-301 | 1 | Part | 01 | 1.43 | i01 | 2.50 | 3.9 | Y |  |  | 1 | Rotates relative to stage 2 carrier.
15 | Stage 2 cage | One-piece output cage with integral shaft (base) | PG25-305 | 1 | Part | 10 | 1.50 | i00 | 1.50 | 3.0 | Y |  |  | 1 | C1.
16 | Stage 2 cage | Planet thrust washer | PG25-206 | 0 | Part | 03 | 1.69 | i01 | 2.50 | 0.0 | N | Y | N | 0 | Eliminated (C2): gas-nitrided cage thrust faces.
17 | Stage 2 cage | Drawn-cup needle bearing HK1212 into planet | HK1212 | 3 | Part | 00 | 1.13 | iP | 6.50 | 22.9 | Y |  |  | 3
18 | Stage 2 cage | Planet gear z27 | PG25-303 | 3 | Part | 00 | 1.13 | i01 | 2.50 | 10.9 | Y |  |  | 3
19 | Stage 2 cage | Planet pin d12 | PG25-304 | 3 | Part | 01 | 1.43 | iP | 6.50 | 23.8 | N | Y |  | 3
20 | Stage 2 cage | Carrier plate 2, input side | PG25-306 | 0 | Part | 10 | 1.50 | i03 | 3.50 | 0.0 | N | N | Y | 0 | Eliminated (C1): one-piece cage, planets inserted radially between the bridges.
21 | Stage 2 cage | Low-head screw DIN 7984 M5x10 | DIN 7984 | 0 | Part | 11 | 1.80 | iS | 6.00 | 0.0 | N | N | N | 0 | Eliminated with the bolted plate (C1).
22 | Output | Tapered roller bearing 32006 X (cone + cup) | 32006 X | 2 | Part | 00 | 1.13 | iP2 | 9.00 | 20.3 | Y |  |  | 2
23 | Output | Output housing | PG25-501 | 1 | Part | 30 | 1.95 | i03 | 3.50 | 5.5 | N | N | N | 0 | Theoretical candidate: merge with ring 2 (C5, rejected).
24 | Output | Cone spacer, ground to setting | PG25-401 | 1 | Part | 01 | 1.43 | i00 | 1.50 | 2.9 | N | N | N | 0 | Sets preload; no part-count alternative without a spring preload.
25 | Output | Lock washer MB 6 | DIN 5406 | 0 | Part | 03 | 1.69 | i01 | 2.50 | 0.0 | N | N | N | 0 | Eliminated (C7): self-locking nut.
26 | Output | Self-locking nut KMK 6, tightened | KMK 6 | 1 | Part | 01 | 1.43 | iST | 8.00 | 9.4 | N | N | N | 0 | C7: integral locking screw.
27 | Output | Bend lock-washer tab | - | 0 | Operation | -- | 0.00 | sTab | 4.00 | 0.0 |  |  |  | 0 | Eliminated with the lock washer (C7).
28 | Output | Bearing setting: measure, grind spacer, re-assemble | - | 1 | Operation | -- | 0.00 | sSet | 90.00 | 90.0 |  |  |  | 0 | Separate operation (selective fit, sec. 18).
29 | Output | Radial shaft seal 28x42x7 | DIN 3760 | 1 | Part | 01 | 1.43 | iP | 6.50 | 7.9 | N | Y |  | 1 | NBR.
30 | Output | Output seal cover | PG25-504 | 1 | Part | 10 | 1.50 | i01 | 2.50 | 4.0 | N | N | Y | 0 | Needed for KM 6 access (C4 rejected); theoretical 0.
31 | Output | Screw ISO 4762 M4x16 | ISO 4762 | 4 | Part | 11 | 1.80 | iS | 6.00 | 31.2 | N | N | N | 0 | Fastener.
32 | Housing stack | Ring gear 1 with integral spacer, over stage 1 planets | PG25-201 | 1 | Part | 10 | 1.50 | iM | 5.00 | 6.5 | N | Y | Y | 1 | Toothed housing section (D-026).
33 | Housing stack | Interstage spacer ring | PG25-502 | 0 | Part | 10 | 1.50 | i01 | 2.50 | 0.0 | N | N | N | 0 | Eliminated (C3): ring 1 lengthened by 12 mm.
34 | Housing stack | Ring gear 2 over stage 2 planets | PG25-302 | 1 | Part | 10 | 1.50 | iM | 5.00 | 6.5 | N | Y | Y | 1
35 | Housing stack | Anaerobic sealant on joint faces | - | 3 | Operation | -- | 0.00 | sSeal | 8.00 | 24.0 |  |  |  | 0 | One joint fewer (C3).
36 | Housing stack | Dowel pin ISO 8734 6x60 | ISO 8734 | 2 | Part | 01 | 1.43 | iP | 6.50 | 15.9 | N | N | N | 0 | Locator.
37 | Housing stack | Tie bolt ISO 4762 M6x70, 10.1 N.m | ISO 4762 | 8 | Part | 11 | 1.80 | iST | 8.00 | 78.4 | N | N | N | 0 | Fastener (C6: 6 bolts rejected).
 |  | Total parts |  | 51
 |  | Part line items (rows with qty > 0) |  | 26
 |  | Separate operations (count) |  | 4
 |  | Total manual assembly time [s] |  | 480.1
 |  | Theoretical minimum part count N_min |  | 32
 |  | Design efficiency E = 3 N_min / time |  | 20.0%
 |  | Candidates for elimination (parts - N_min) |  | 19

Sheet: Comparison
Current design vs DFMA variant
Metric | Current | Variant | Change | Change [%]
Total parts | 73 | 51 | -22 | -30.1%
Part line items | 34 | 26 | -8 | -23.5%
Separate operations | 6 | 4 | -2 | -33.3%
Manual assembly time [s] | 607.4 | 480.1 | -127.3 | -21.0%
Theoretical minimum N_min | 34 | 32 | -2 | -5.9%
Design efficiency | 16.8% | 20.0% | 3.2% | 19.1%
Candidate changes evaluated
Id | Change | Parts saved | Verdict | Reason / consequence
C1 | One-piece carrier cages, both stages (merge PG25-204/205 and PG25-305/306) | 8 | Accepted for series | Removes 2 plates and 6 screws. Planets go in radially between the bridges (gap 16 mm > 15 mm face; ~48 mm opening > 43.5 mm tip diameter). The pin bores are line-bored through both walls in one set-up, which helps the Ø0.012 position tolerance. The prototype keeps bolted cages (D-021) because they are quicker to machine and inspect as single parts.
C2 | Delete the 12 thrust washers; gas-nitride the cage thrust faces (~600 HV, 0.3 mm) | 12 | Accepted for series, test first | Planet thrust is small (10 % of F_t, sec. 16) but the 42CrMo4 QT faces need nitriding to resist wear. End float then comes from the 16 ± 0.02 cage gap and the 15 h8 planet. Validate by a wear test before release.
C3 | Merge the interstage spacer ring into ring 1 (ring 1 + 12 mm) | 1 | Accepted | One part and one sealed joint fewer. The tie-bolt embedding f_Z drops from 14 to 12 µm (sec. 17). Ring 1 needs a run-out groove for the shaping cutter.
C4 | Merge the output seal cover into the output housing | 5 | Rejected | The KM 6 nut (45 mm) must be tightened through the cover opening, and the seal bore (42 mm) is too small to pass a hook spanner.
C5 | Merge ring 2 with the output housing (steel housing with internal teeth) | 1 | Rejected | Conflicts with D-026/D-027: a heavier steel housing, internal teeth shaped next to the bearing bore, and the GJS damping lost.
C6 | Reduce the tie bolts from 8 to 6 | 2 | Rejected | Slip safety at the ring 2 | output housing joint falls from 2.01 to 1.51, below the 1.8 minimum (VDI 2230, sec. 17).
C7 | Replace KM 6 + MB 6 with a self-locking KMK 6 nut | 1 | Accepted | One part and the tab-bending operation fewer; the nut is re-usable for bearing re-setting.
 | Parts saved by the accepted changes | 22
 | Check: current parts - variant parts | 22
