alanarzamendi/planetary-gearbox-25-1/Calculations/01_Preliminary_Requirements_Planetary_Gearbox.xlsx

Sheet: Requirements
Two-Stage Planetary Gearbox — Preliminary Requirements
Project purpose: define the engineering inputs before creating the SolidWorks master layout. Yellow cells are editable inputs; green cells are calculated or linked.
ID | Category | Requirement | Value | Unit | Status | Rationale / Notes
R-001 | Architecture | Gearbox type | Two-stage planetary |  | Fixed | Selected to balance portfolio depth and six-week scope.
R-002 | Architecture | Ring gear condition | Fixed |  | Fixed | Sun input and carrier output in both stages.
R-003 | Architecture | Input member | Stage 1 sun gear |  | Fixed | High-speed, low-torque input.
R-004 | Architecture | Output member | Stage 2 carrier |  | Fixed | Low-speed, high-torque output.
R-005 | Architecture | Number of stages | 2 | stages | Fixed | Two reductions in series.
R-006 | Architecture | Planets per stage | 3 | planets | Provisional | Three planets simplify spacing and assembly.
R-007 | Performance | Target total ratio | 25 | :1 | Provisional | Initial target; verified on Gear Design sheet.
R-008 | Gear geometry | Pressure angle | 20 | deg | Provisional | Common standard involute pressure angle.
R-009 | Gear geometry | Metric module | 1.5 | mm | Provisional | Must be verified by strength calculations.
R-010 | Performance | Input speed | 3000 | rpm | Provisional | Representative servo motor speed.
R-011 | Performance | Input torque | 4 | N·m | Provisional | Representative starting point; replace with selected motor data.
R-012 | Performance | Efficiency per stage | 0.95 |  | Provisional | Initial estimate for early calculations.
R-013 | Reliability | Design life | 10000 | h | TBD | Required for bearing selection.
R-014 | Packaging | Maximum outside diameter | 140 | mm | Provisional | Desktop-scale industrial portfolio target.
R-015 | Packaging | Maximum overall length | 175 | mm | Revised (step 6) | Mounting face to motor face; output shaft and motor excluded. Layout gives 171 mm (D-028).
R-016 | Strength | Minimum design safety factor | 1.5 |  | Provisional | May increase after duty cycle and material selection.
R-017 | Documentation | GD&T system | ASME Y14.5 or ISO GPS |  | TBD | Choose one system and apply it consistently.
Project summary
Metric | Value | Source
Target ratio |  | Gear Design
Input speed |  | Requirements
Calculated output speed |  | Performance
Calculated output torque |  | Performance

Sheet: Gear Design
Planetary Gear Set — Ratio and Geometry
KPI | Value | Unit | Status
Total ratio |  | :1
Stage 1 geometry
Stage 1 planet spacing
Stage 2 geometry
Stage 2 planet spacing
Stage 1 — Input stage |  |  |  | Stage 2 — Output stage
Parameter | Value | Unit |  | Parameter | Value | Unit
Sun teeth, Zs | 18 | teeth |  | Sun teeth, Zs | 18 | teeth
Planet teeth, Zp | 27 | teeth |  | Planet teeth, Zp | 27 | teeth
Module, m | 1.5 | mm |  | Module, m | 1.5 | mm
Ring teeth, Zr | 72 | teeth |  | Ring teeth, Zr | 72 | teeth
Number of planets | 3 |  |  | Number of planets | 3
Pressure angle | 20 | deg |  | Pressure angle | 20 | deg
Sun pitch diameter |  | mm |  | Sun pitch diameter |  | mm
Planet pitch diameter |  | mm |  | Planet pitch diameter |  | mm
Ring pitch diameter |  | mm |  | Ring pitch diameter |  | mm
Stage ratio |  | :1 |  | Stage ratio |  | :1
Planet-center radius |  | mm |  | Planet-center radius |  | mm
Planet-center PCD |  | mm |  | Planet-center PCD |  | mm
Design checks: ring gear relation Zr = Zs + 2·Zp, and equal-spacing condition MOD(Zs + Zr, number of planets) = 0.
Ratio summary
Item | Calculated value
Stage 1 ratio
Stage 2 ratio
Total ratio
Ratio error vs. target

Sheet: Performance
Preliminary Speed, Torque, Efficiency and Power
Input / Assumption | Value | Unit | Design check | Result
Input speed |  | rpm | Total ratio matches target
Input torque |  | N·m | Output torque ≥ 80 N·m
Stage 1 efficiency |  |  | Output speed within 100–150 rpm
Stage 2 efficiency |  |  | Estimated power consistency
Design life |  | h
Calculated result | Value | Unit
Stage 1 ratio |  | :1
Stage 1 output speed |  | rpm
Stage 1 output torque |  | N·m
Final output speed |  | rpm
Final output torque |  | N·m
Total efficiency
Input mechanical power |  | W
Output mechanical power |  | W

Sheet: Master Layout
SolidWorks Master Layout — Global Variables
SolidWorks variable | Value | Unit | Source / Formula | Status
"Z_Sun" |  | teeth | Gear Design!B12 | Calculated
"Z_Planet" |  | teeth | Gear Design!B13 | Calculated
"Z_Ring" |  | teeth | Gear Design!B15 | Calculated
"Number_of_Planets" |  |  | Gear Design!B16 | Calculated
"Pressure_Angle" |  | deg | Gear Design!B17 | Provisional
"Module" |  | mm | Gear Design!B14 | Provisional
"Sun_PD" |  | mm | Module × Z_Sun | Calculated
"Planet_PD" |  | mm | Module × Z_Planet | Calculated
"Ring_PD" |  | mm | Module × Z_Ring | Calculated
"Planet_Center_Radius" |  | mm | (Sun_PD + Planet_PD) / 2 | Calculated
"Planet_Center_PCD" |  | mm | 2 × Planet_Center_Radius | Calculated
"Stage_1_Ratio" |  | :1 | 1 + Z_Ring / Z_Sun | Calculated
"Stage_2_Ratio" |  | :1 | 1 + Z_Ring / Z_Sun | Calculated
"Total_Ratio" |  | :1 | Stage_1_Ratio × Stage_2_Ratio | Calculated
"Stage_1_Face_Width" |  | mm | To be determined by gear strength | TBD
"Stage_2_Face_Width" |  | mm | To be determined by gear strength | TBD
"Interstage_Clearance" |  | mm | To be determined during packaging | TBD
"Input_Bearing_Zone" |  | mm | After bearing selection | TBD
"Output_Bearing_Zone" |  | mm | After bearing selection | TBD
Important: the master layout is a non-manufactured skeleton part. Do not model gear teeth, bearings, shafts, or housing until the design inputs are accepted.

Sheet: Standards & Components
Candidate Standards and Component Design Basis
Component / Topic | Design basis | Candidate reference | Custom or standard | Action | Notes
Gear module | Preferred metric modules | ISO 54 | Standard-based | Use module from preferred series | Edition/year to be confirmed before final report.
Gear strength | Tooth bending and contact capacity | ISO 6336 or AGMA rating method | Calculation-based | Select one method | Use simplified checks first, then refine.
Gear accuracy | Flank tolerance/quality grade | ISO 1328 | Standard-based | Select quality grade | Depends on speed, backlash and manufacturing process.
Fits | Hole/shaft tolerance system | ISO 286 | Standard-based | Define bearing, shaft and insert fits | Do not choose fits by intuition.
Bearings | Catalog dimensions and life | ISO boundary dimensions + manufacturer catalog | Purchased standard | Select after loads are known | Never invent bearing dimensions.
Socket head screws | Metric fastener geometry | ISO 4762 | Purchased standard | Select size and length | Insert one file multiple times.
Parallel keys | Key and keyway proportions | DIN 6885 / applicable ISO | Purchased or standard-based | Select from shaft diameter | Verify exact standard used by supplier.
Retaining rings | Ring and groove dimensions | DIN/ISO + supplier catalog | Purchased standard | Select after shaft/housing diameters | Grooves must match catalog data.
Oil seals | Shaft and housing interface | Supplier catalog / applicable ISO | Purchased standard | Select after shaft speed and diameter | Surface finish and hardness matter.
O-rings | Seal cross-section and groove | ISO 3601 / supplier handbook | Purchased standard | Calculate groove geometry | Static or dynamic duty must be specified.
GD&T | Datum system and geometric tolerancing | ASME Y14.5 or ISO GPS | Documentation standard | Choose one system | Do not mix rule systems on the same drawing set.
Carriers | Torque, planet-pin locations, stiffness and manufacturability | Engineering calculations | Custom | Design after gear forces | Shape is flexible; interfaces are constrained.
Shafts | Combined torque/bending, bearings, keys and seals | Engineering calculations | Custom | Size after loads | Bearing and seal seats follow purchased components.
Housing and covers | Alignment, stiffness, bearing/ring seats and assembly | Engineering calculations + DFMA | Custom | Design after internals | External styling is flexible; critical bores are not.

Sheet: Decision Log
Engineering Decision Log
Date | Decision ID | Decision | Alternatives considered | Rationale | Status | Next validation
2026-07-10 | D-001 | Use a two-stage planetary architecture | Five-stage downloaded model; single-stage reducer | Two stages provide adequate complexity and a manageable six-week scope. | Accepted | Confirm performance requirements.
2026-07-10 | D-002 | Fixed ring, sun input, carrier output for both stages | Other planetary member combinations | Common reduction arrangement with clear torque progression. | Accepted | Verify total ratio and loads.
2026-07-10 | D-003 | Initial 18/27/72 tooth set with three planets | Other tooth combinations | Produces 5:1 per stage, satisfies geometry and equal-spacing checks. | Provisional | Strength and interference checks.
2026-07-10 | D-004 | Use ISO metric module system | Diametral pitch / ANSI-only geometry | Better fit for metric SolidWorks project and standard metric hardware. | Accepted | Select final module after strength calculation.
