alanarzamendi/planetary-gearbox-25-1/Assemblies/04_Output_Subassembly.SLDASM

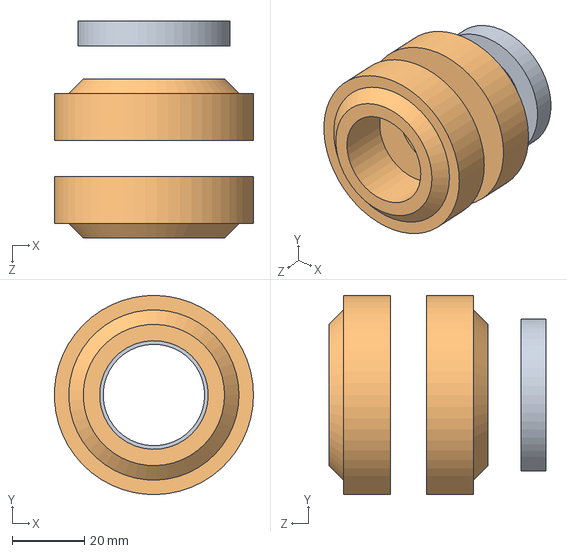
[picture p11: CAD file, 2026-11-06]
Assemblies/04_Output_Subassembly.SLDASM
55.0 x 55.0 x 60.0 mm
TRB_32006X x 2
Radial_Seal_28x42x7
