alanarzamendi/planetary-gearbox-25-1/Simulation/FEA_Stage2_Carrier.SLDASM

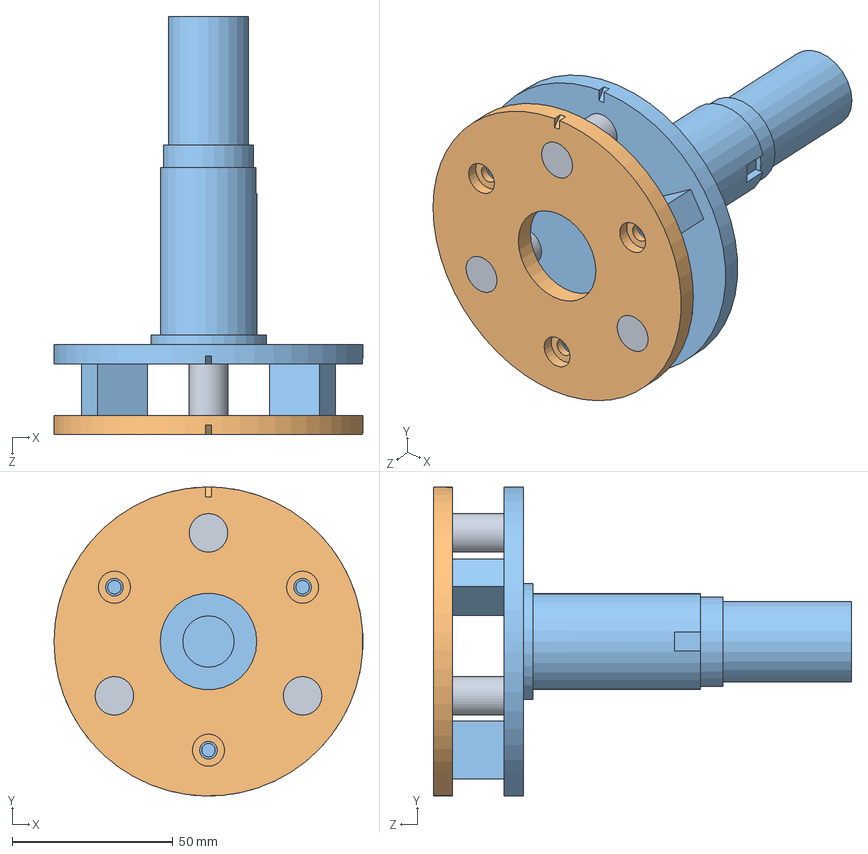
[picture p12: CAD file, 2026-11-06]
Simulation/FEA_Stage2_Carrier.SLDASM
96.0 x 96.0 x 130.0 mm
Stage_2_Carrier_Front_Plate
Stage_2_Carrier_Rear_Plate
Stage_2_Planet_Shaft x 3
