alanarzamendi/planetary-gearbox-25-1/Assemblies/01_Input_Subassembly.SLDASM

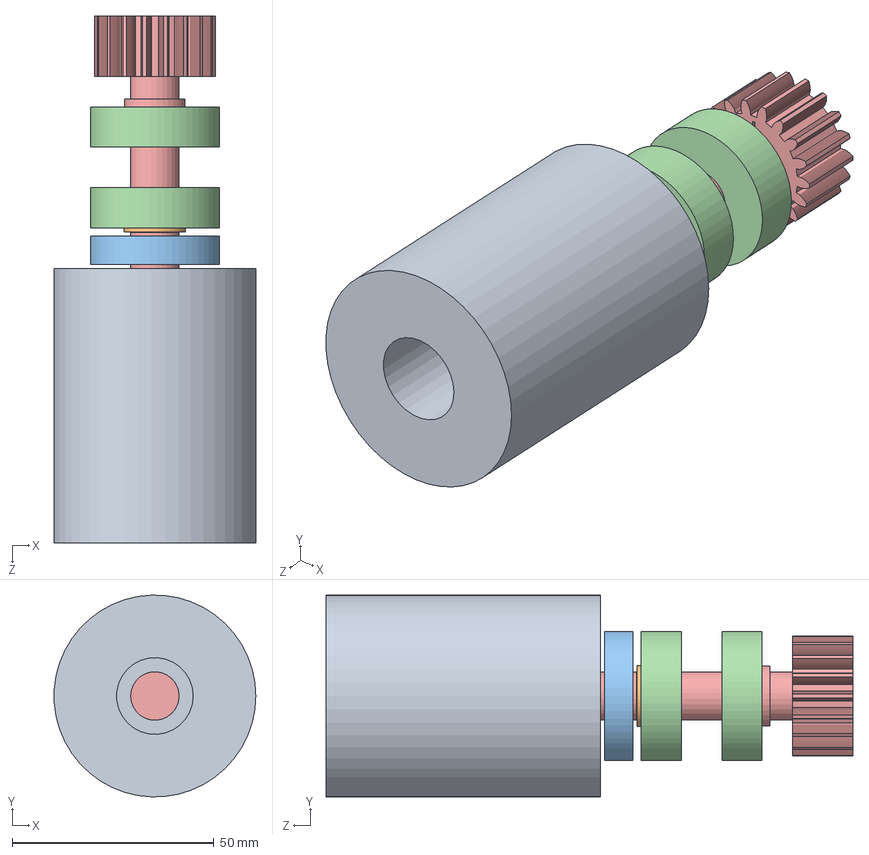
[picture p13: CAD file, 2026-11-06]
Assemblies/01_Input_Subassembly.SLDASM
49.9 x 50.0 x 130.5 mm
Input_Shaft_Sun_Gear
DGBB_6201_2Z x 2
Radial_Seal_12x32x7
Circlip_DIN471_12x1
Bellows_Coupling_D50x68
