alanarzamendi/planetary-gearbox-25-1/Simulation/FEA_Stage2_Ring_Rim.SLDPRT

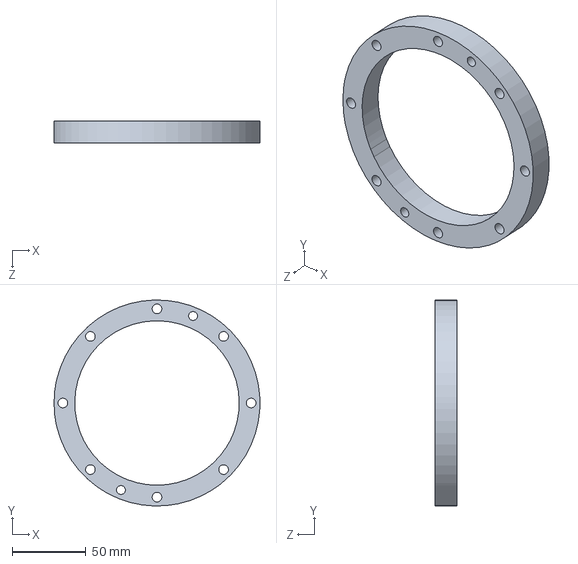
[picture p14: CAD file, 2026-11-06]
Simulation/FEA_Stage2_Ring_Rim.SLDPRT
140.0 x 139.9 x 15.0 mm
