alanarzamendi/planetary-gearbox-25-1/Assemblies/Parts/Stage_2_Ring_Gear.SLDPRT

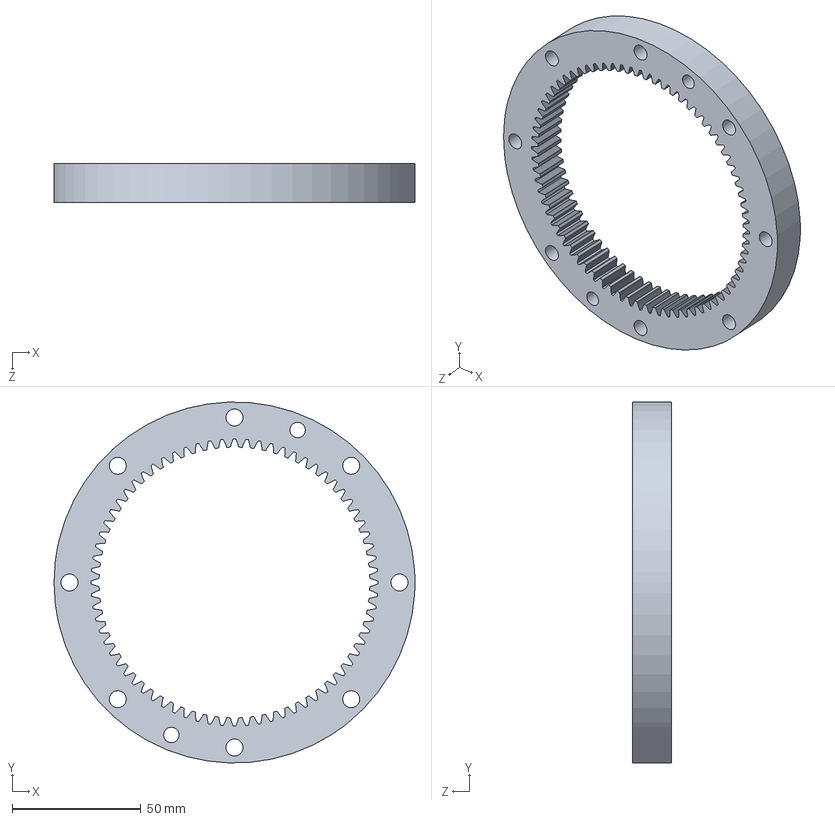
[picture p15: CAD file, 2026-11-06]
Assemblies/Parts/Stage_2_Ring_Gear.SLDPRT
140.0 x 139.9 x 15.0 mm
