alanarzamendi/planetary-gearbox-25-1/Simulation/FEA_Output_Housing.SLDPRT

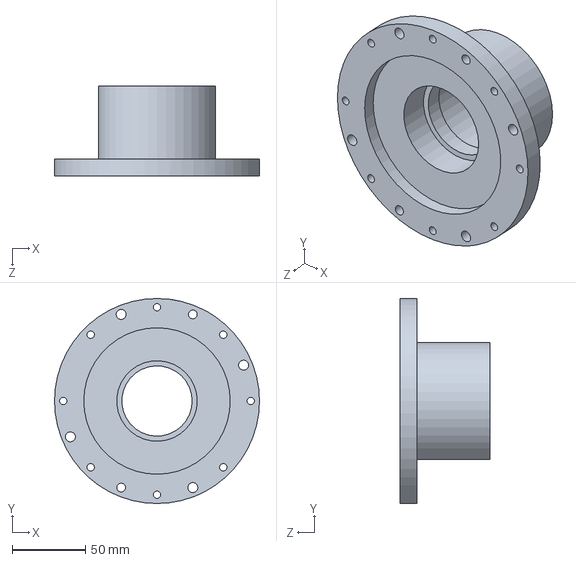
[picture p16: CAD file, 2026-11-06]
Simulation/FEA_Output_Housing.SLDPRT
140.0 x 140.0 x 61.5 mm
