alanarzamendi/planetary-gearbox-25-1/Assemblies/Parts/Bellows_Coupling_D50x68.SLDPRT

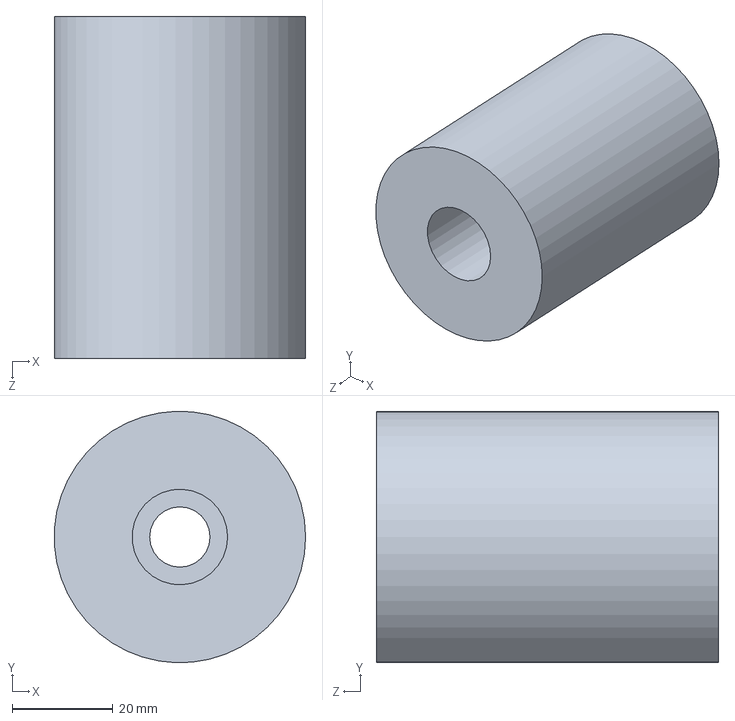
[picture p17: CAD file, 2026-11-06]
Assemblies/Parts/Bellows_Coupling_D50x68.SLDPRT
49.9 x 50.0 x 68.0 mm
