alanarzamendi/planetary-gearbox-25-1/Assemblies/Parts/Stage_1_Carrier_Front_Plate.SLDPRT

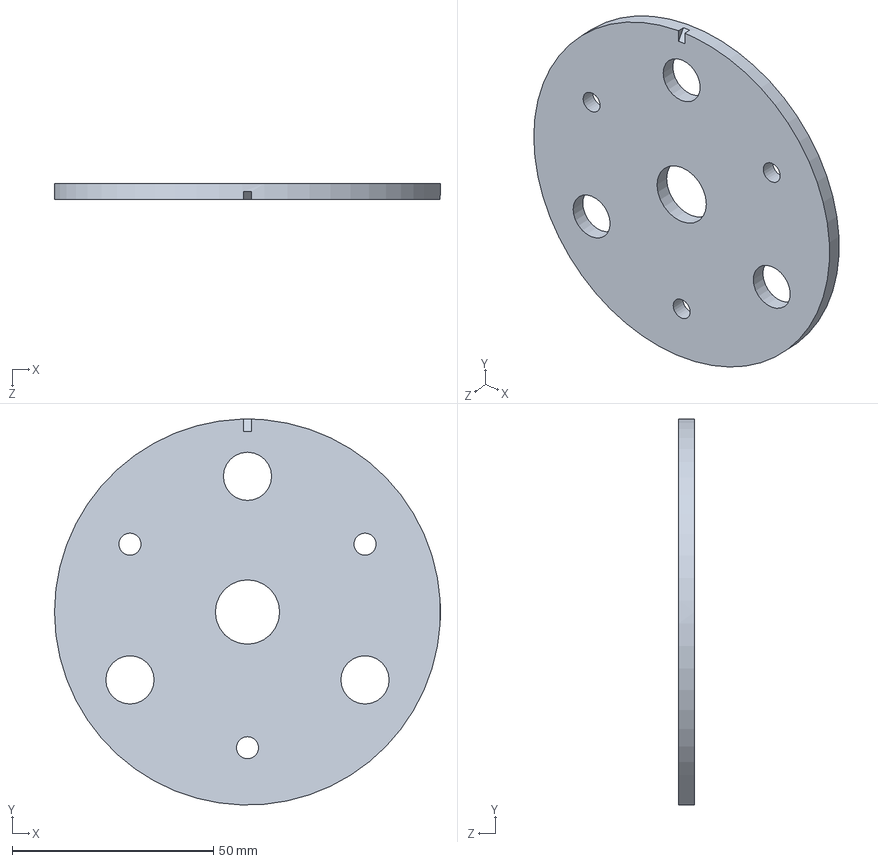
[picture p18: CAD file, 2026-11-06]
Assemblies/Parts/Stage_1_Carrier_Front_Plate.SLDPRT
96.0 x 96.0 x 4.00 mm
