alanarzamendi/planetary-gearbox-25-1/Assemblies/Parts/Stage_2_Carrier_Front_Plate.SLDPRT

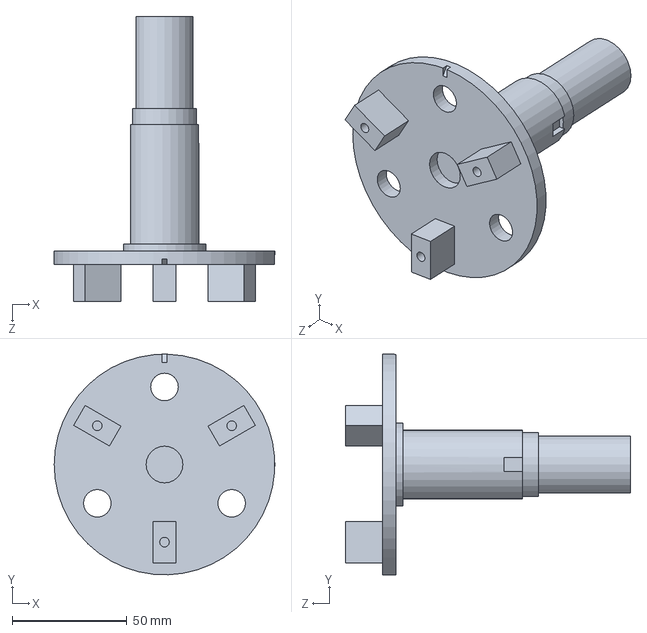
[picture p19: CAD file, 2026-11-06]
Assemblies/Parts/Stage_2_Carrier_Front_Plate.SLDPRT
96.0 x 96.0 x 124.0 mm
