alanarzamendi/planetary-gearbox-25-1/Assemblies/Parts/Input_Shaft_Sun_Gear.SLDPRT

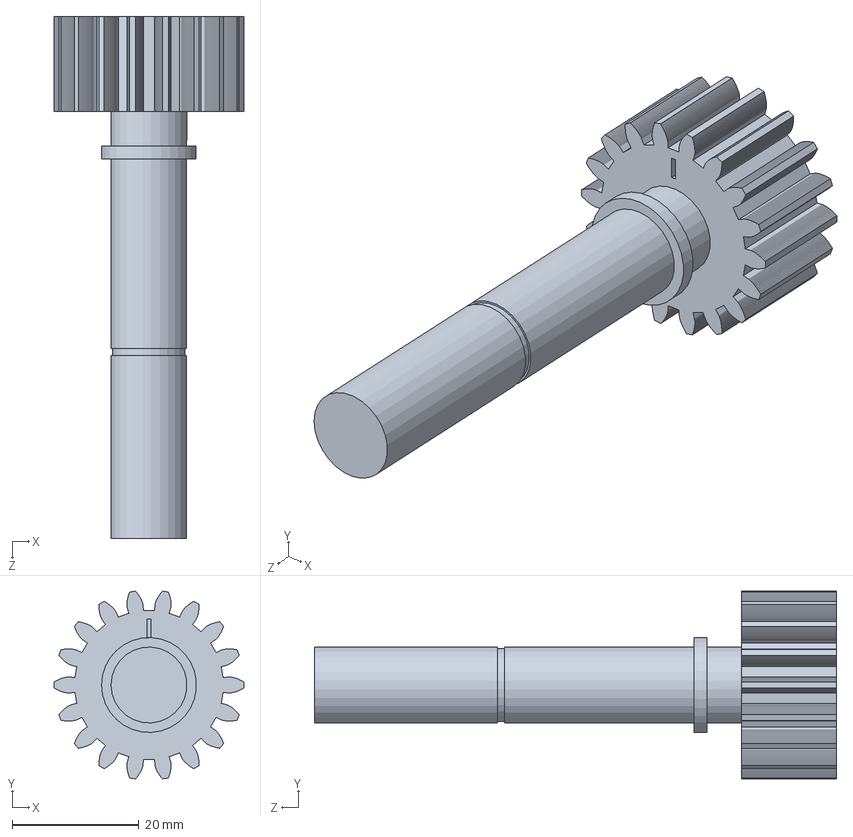
[picture p20: CAD file, 2026-11-06]
Assemblies/Parts/Input_Shaft_Sun_Gear.SLDPRT
30.0 x 29.7 x 82.5 mm
