alanarzamendi/planetary-gearbox-25-1/Assemblies/Parts/Interstage_Spacer_Ring.SLDPRT

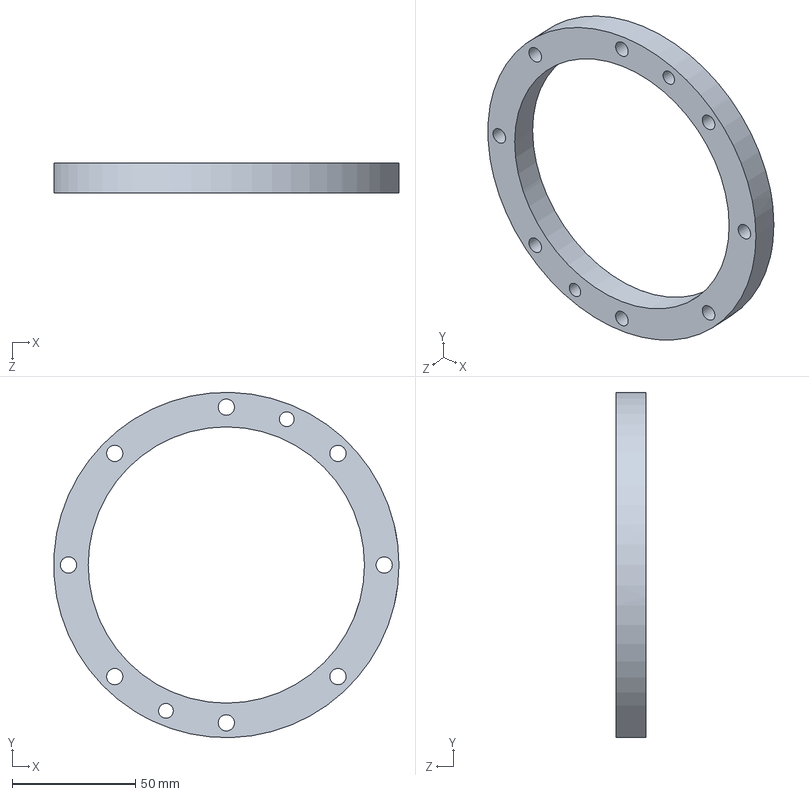
[picture p21: CAD file, 2026-11-06]
Assemblies/Parts/Interstage_Spacer_Ring.SLDPRT
139.9 x 139.9 x 12.0 mm
