alanarzamendi/planetary-gearbox-25-1/Assemblies/Parts/Output_Seal_Cover.SLDPRT

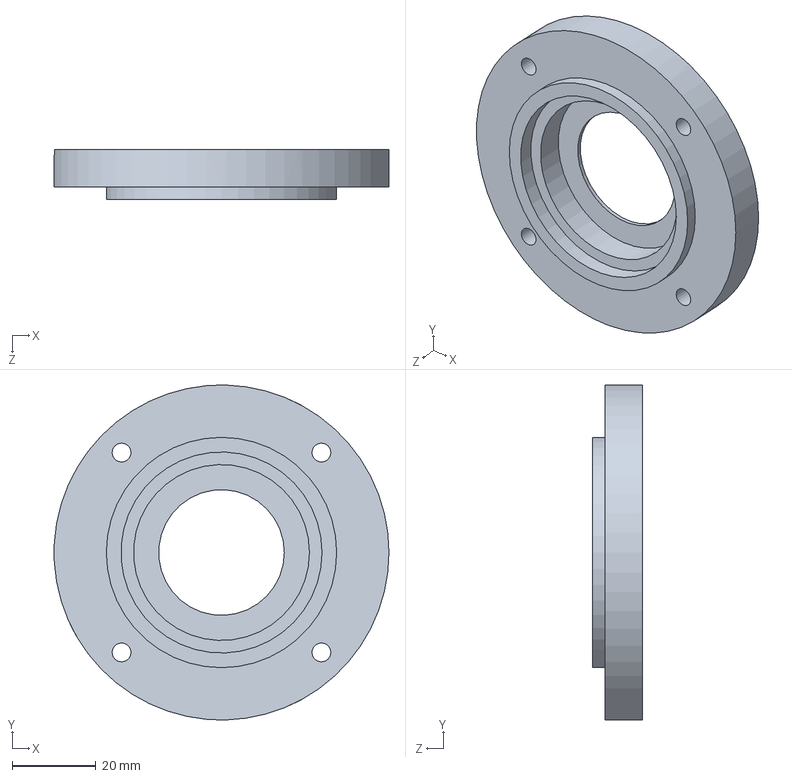
[picture p22: CAD file, 2026-11-06]
Assemblies/Parts/Output_Seal_Cover.SLDPRT
80.0 x 80.0 x 12.0 mm
