alanarzamendi/planetary-gearbox-25-1/Assemblies/Parts/Stage_1_Planet_Shaft.SLDPRT

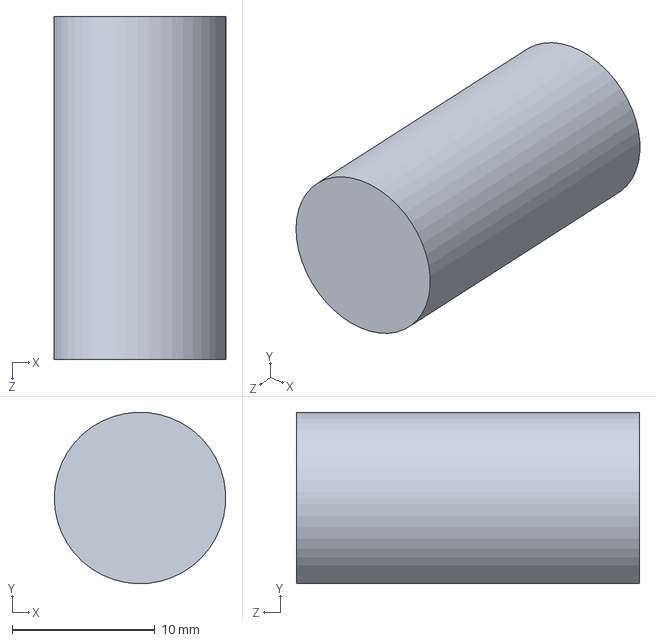
[picture p23: CAD file, 2026-11-06]
Assemblies/Parts/Stage_1_Planet_Shaft.SLDPRT
12.0 x 12.0 x 24.0 mm
