alanarzamendi/planetary-gearbox-25-1/Assemblies/Parts/Stage_2_Planet_Bearing.SLDPRT

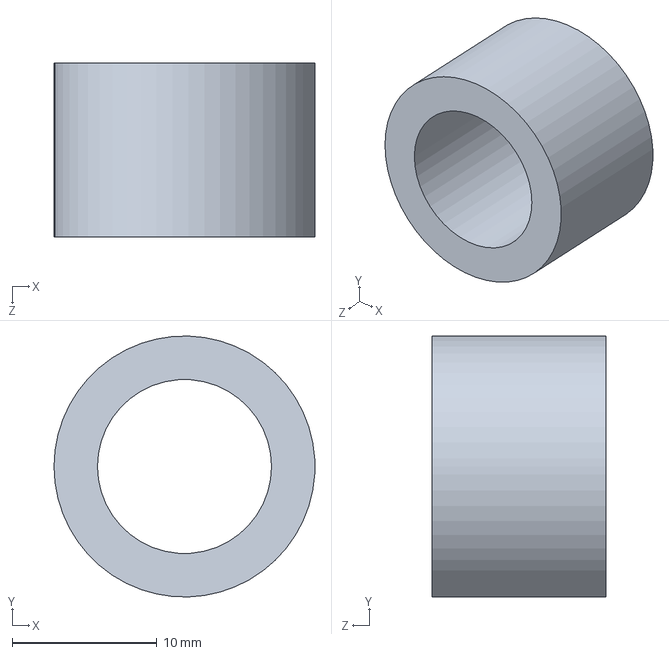
[picture p24: CAD file, 2026-11-06]
Assemblies/Parts/Stage_2_Planet_Bearing.SLDPRT
18.0 x 18.0 x 12.0 mm
