alanarzamendi/planetary-gearbox-25-1/Assemblies/Parts/Stage_2_Sun_Gear.SLDPRT

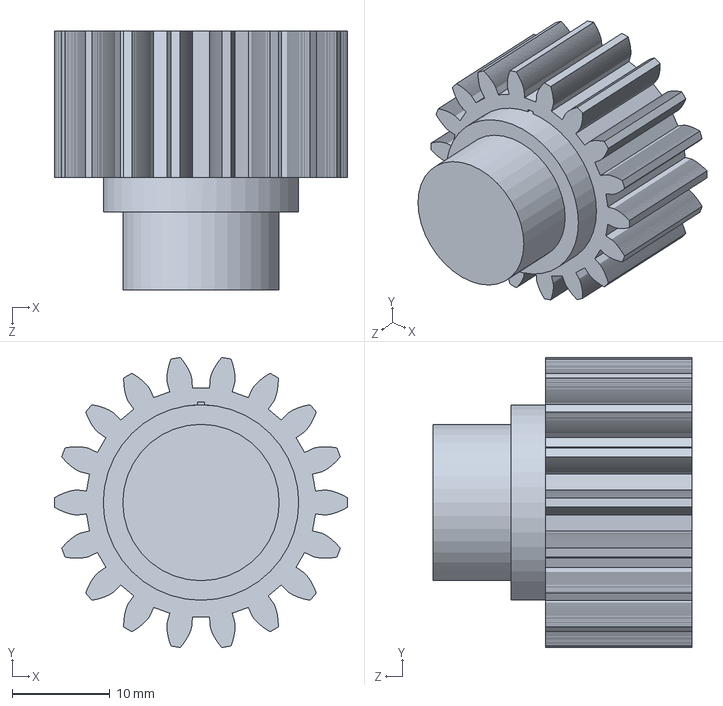
[picture p25: CAD file, 2026-11-06]
Assemblies/Parts/Stage_2_Sun_Gear.SLDPRT
30.0 x 29.7 x 26.5 mm
