alanarzamendi/planetary-gearbox-25-1/Assemblies/Parts/Input_Housing.SLDPRT

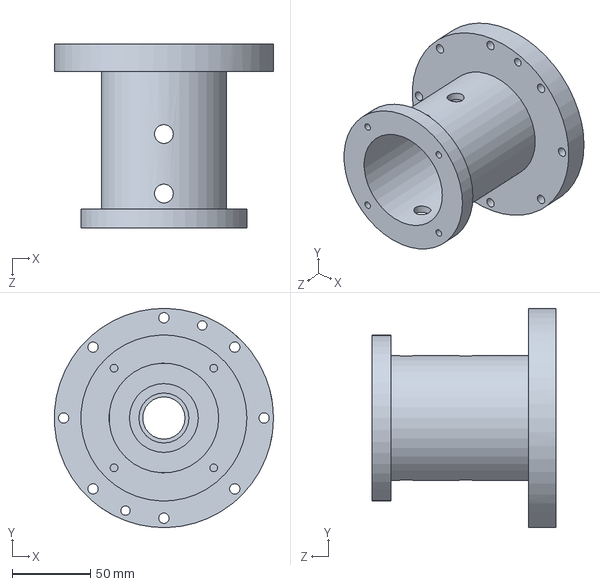
[picture p26: CAD file, 2026-11-06]
Assemblies/Parts/Input_Housing.SLDPRT
139.9 x 139.9 x 117.5 mm
