alanarzamendi/planetary-gearbox-25-1/Assemblies/Parts/TRB_32006X.SLDPRT

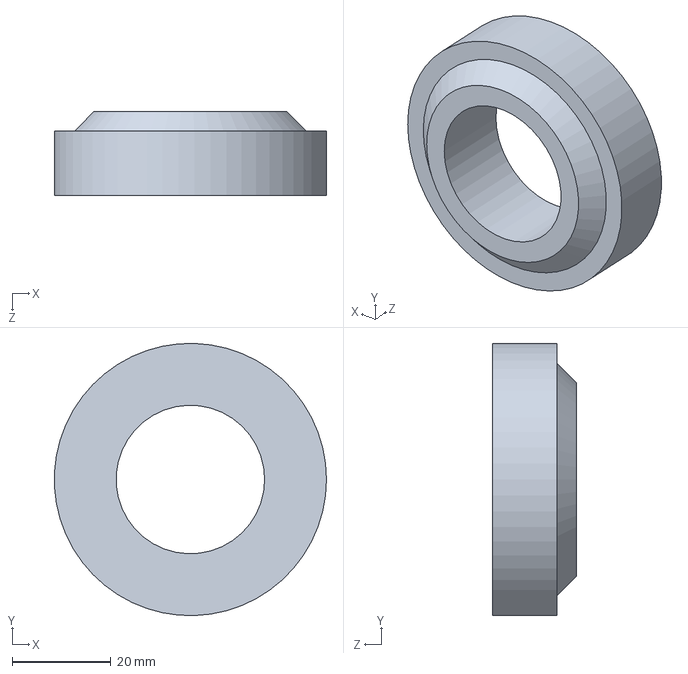
[picture p27: CAD file, 2026-11-06]
Assemblies/Parts/TRB_32006X.SLDPRT
55.0 x 55.0 x 17.0 mm
