alanarzamendi/planetary-gearbox-25-1/Assemblies/Parts/Radial_Seal_12x32x7.SLDPRT

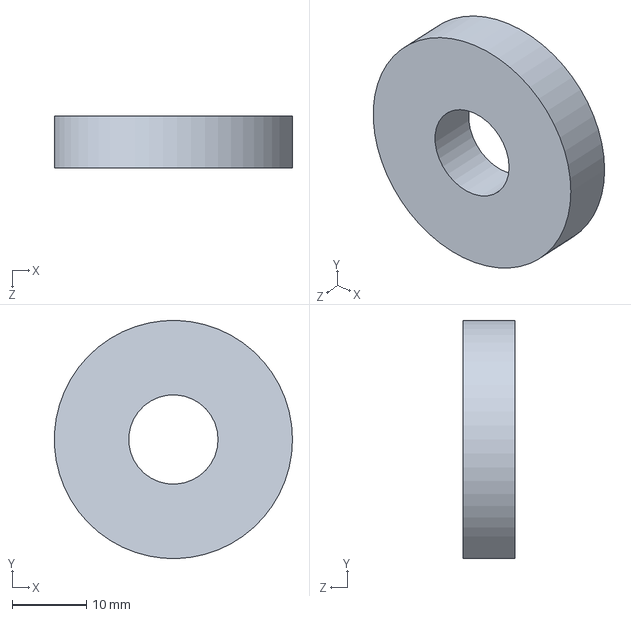
[picture p28: CAD file, 2026-11-06]
Assemblies/Parts/Radial_Seal_12x32x7.SLDPRT
32.0 x 32.0 x 7.00 mm
