alanarzamendi/planetary-gearbox-25-1/Assemblies/Parts/Circlip_DIN471_12x1.SLDPRT

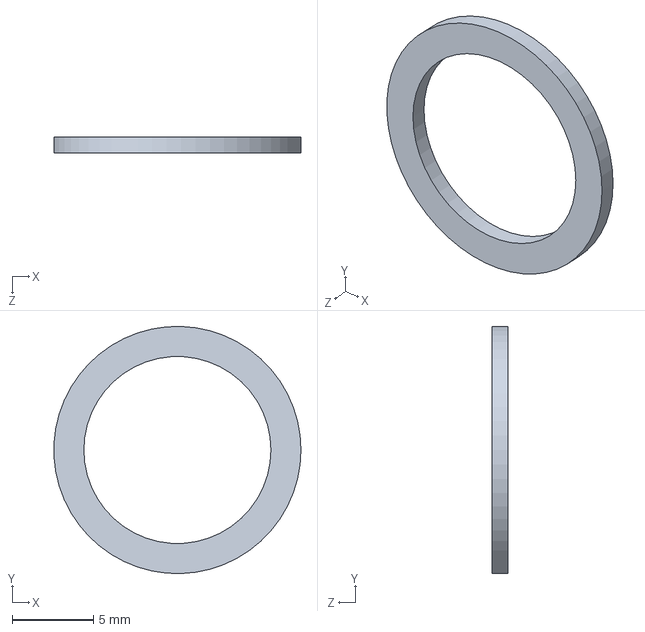
[picture p29: CAD file, 2026-11-06]
Assemblies/Parts/Circlip_DIN471_12x1.SLDPRT
15.2 x 15.2 x 1 mm
