alanarzamendi/planetary-gearbox-25-1/Assemblies/Parts/Stage_2_Planet_Shaft.SLDPRT

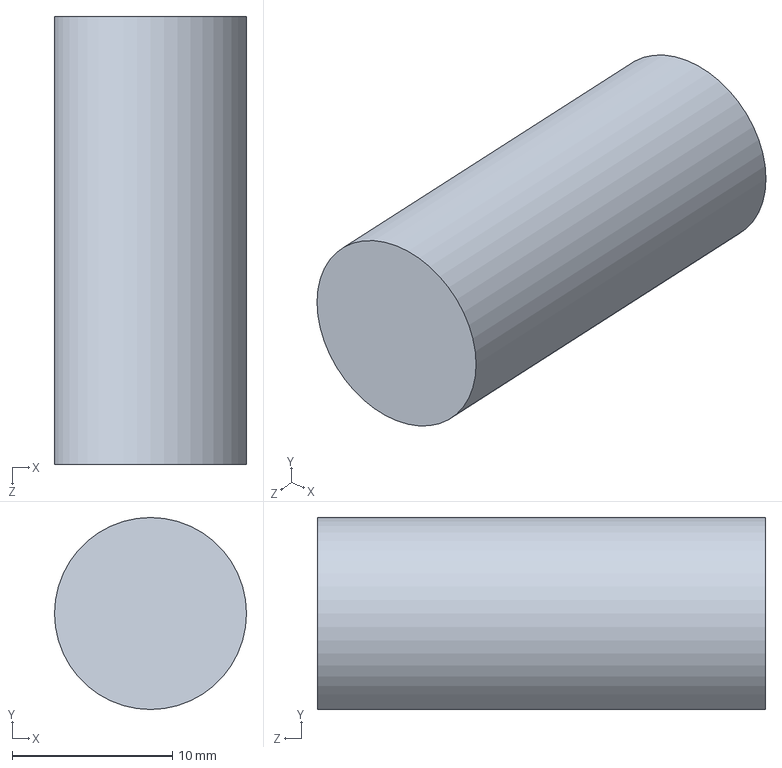
[picture p30: CAD file, 2026-11-06]
Assemblies/Parts/Stage_2_Planet_Shaft.SLDPRT
12.0 x 12.0 x 28.0 mm
