alanarzamendi/planetary-gearbox-25-1/Assemblies/Parts/Radial_Seal_28x42x7.SLDPRT

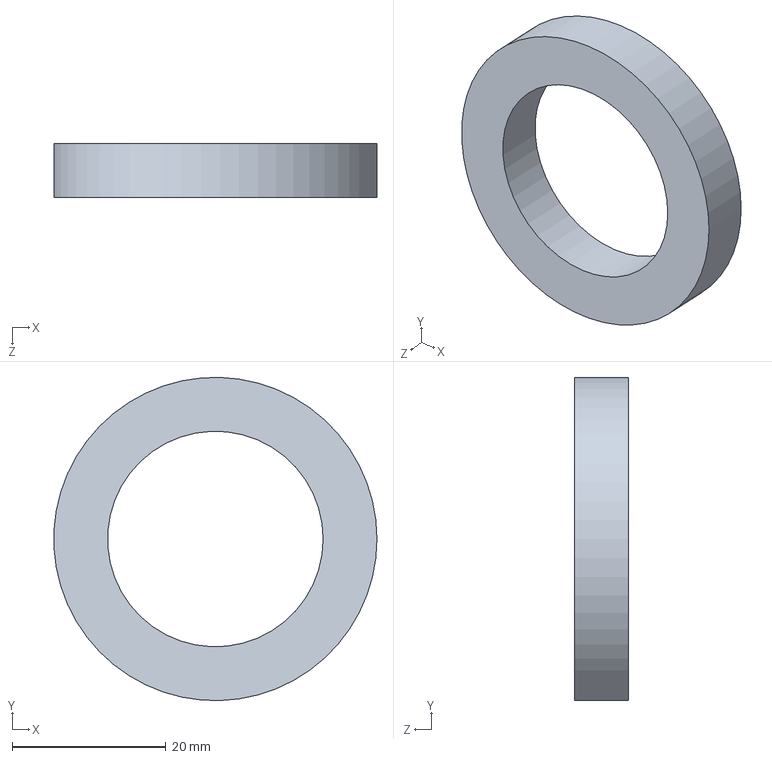
[picture p31: CAD file, 2026-11-06]
Assemblies/Parts/Radial_Seal_28x42x7.SLDPRT
42.0 x 42.0 x 7.00 mm
