alanarzamendi/planetary-gearbox-25-1/Assemblies/Parts/Stage_1_Planet_Gear.SLDPRT

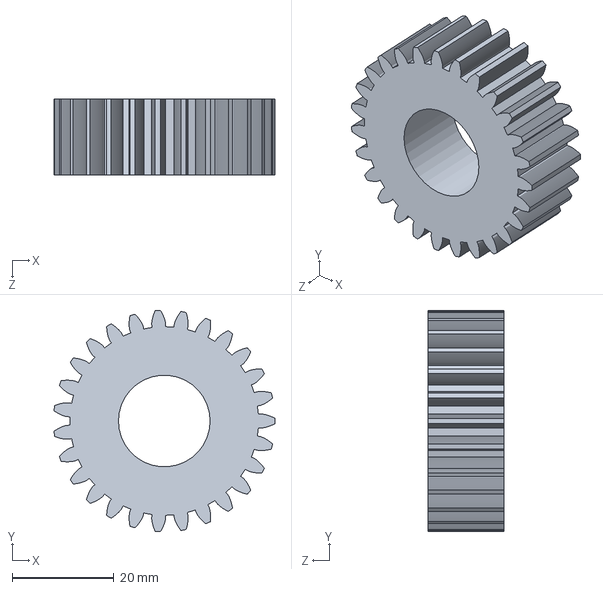
[picture p32: CAD file, 2026-11-06]
Assemblies/Parts/Stage_1_Planet_Gear.SLDPRT
43.4 x 43.5 x 15.0 mm
