alanarzamendi/planetary-gearbox-25-1/Assemblies/Parts/Stage_1_Carrier_Rear_Plate.SLDPRT

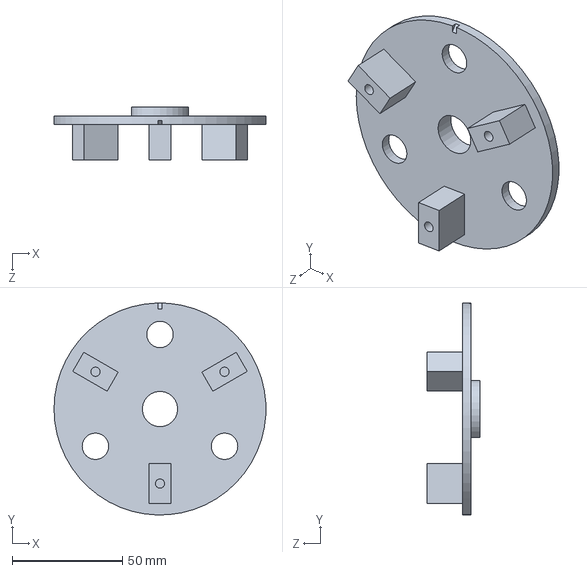
[picture p33: CAD file, 2026-11-06]
Assemblies/Parts/Stage_1_Carrier_Rear_Plate.SLDPRT
96.0 x 96.0 x 24.0 mm
