alanarzamendi/planetary-gearbox-25-1/Assemblies/Parts/Output_Bearing_Spacer.SLDPRT

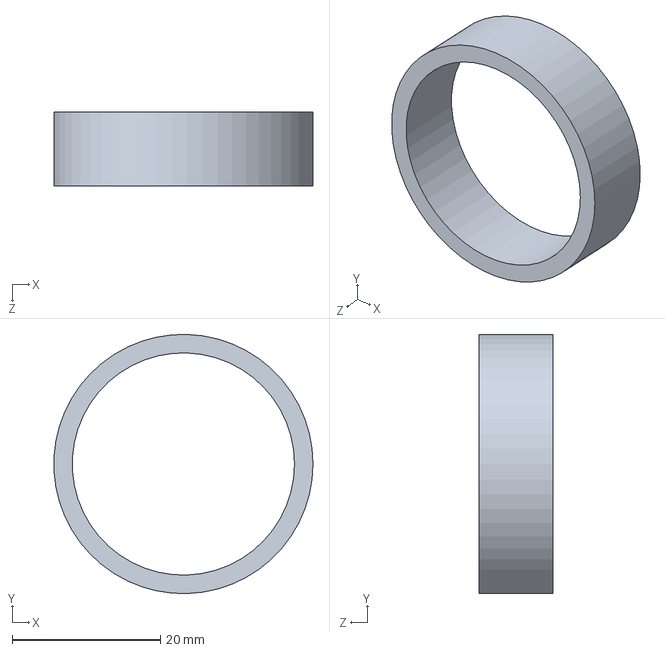
[picture p34: CAD file, 2026-11-06]
Assemblies/Parts/Output_Bearing_Spacer.SLDPRT
35.0 x 35.0 x 10.0 mm
