alanarzamendi/planetary-gearbox-25-1/Assemblies/Parts/DGBB_6201_2Z.SLDPRT

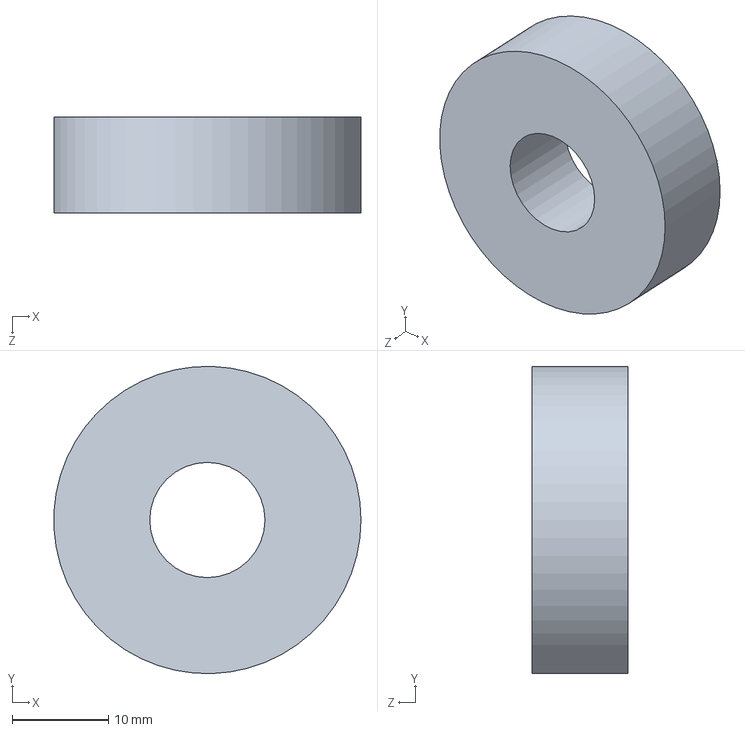
[picture p35: CAD file, 2026-11-06]
Assemblies/Parts/DGBB_6201_2Z.SLDPRT
32.0 x 32.0 x 10.0 mm
