alanarzamendi/planetary-gearbox-25-1/Assemblies/Parts/Stage_2_Carrier_Rear_Plate.SLDPRT

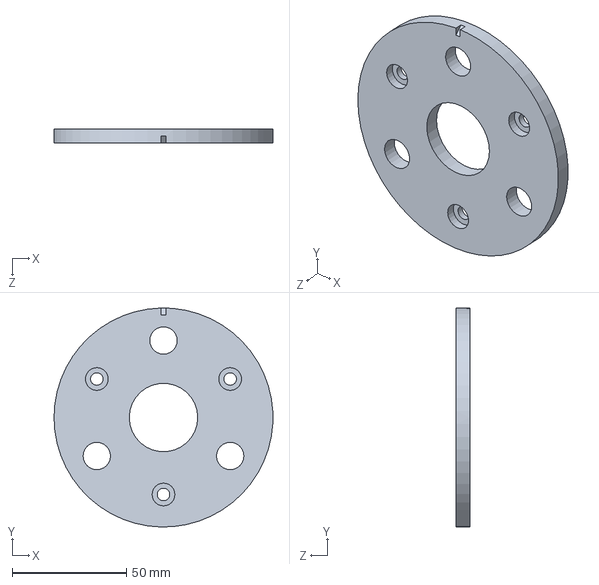
[picture p36: CAD file, 2026-11-06]
Assemblies/Parts/Stage_2_Carrier_Rear_Plate.SLDPRT
96.0 x 96.0 x 6.00 mm
