alanarzamendi/planetary-gearbox-25-1/Assemblies/03_Stage_2_Subassembly.SLDASM

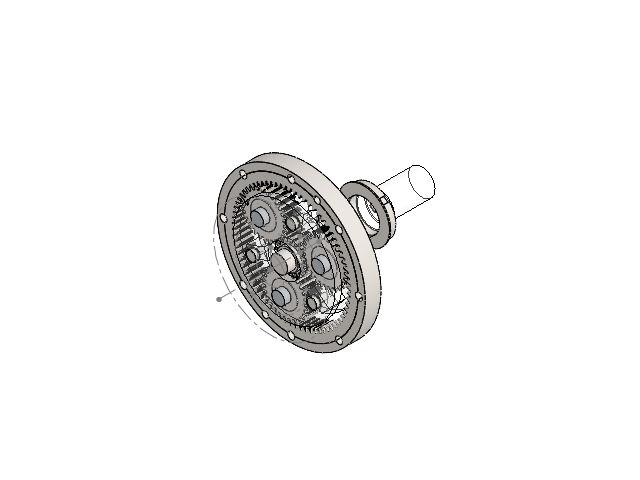
[picture p37: CAD file, 2026-11-06]
Assemblies/03_Stage_2_Subassembly.SLDASM
00_Gearbox_Master_Layout
Stage_2_Sun_Gear
Stage_2_Ring_Gear
Stage_2_Planet_Gear x 3
Stage_2_Planet_Shaft x 3
Stage_2_Carrier_Front_Plate
Stage_2_Carrier_Rear_Plate
Planet_Thrust_Washer x 6
Output_Bearing_Spacer
Lock_Washer_MB6
Lock_Nut_KM6
DIN7984_M5x10 x 3
