alanarzamendi/planetary-gearbox-25-1/Assemblies/Planetary_Gearbox_2_stage.SLDASM

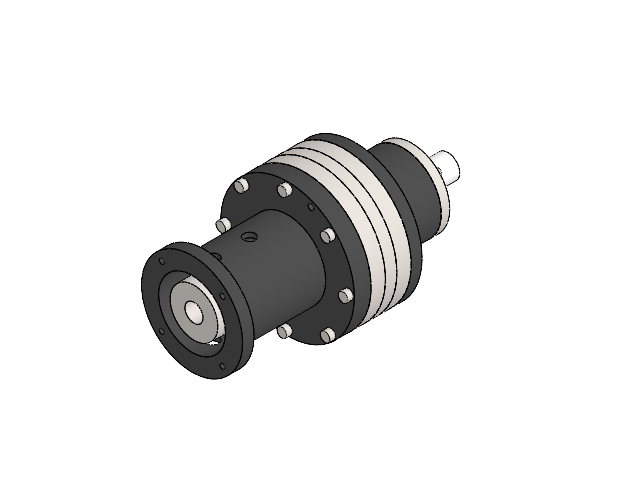
[picture p38: CAD file, 2026-11-06]
Assemblies/Planetary_Gearbox_2_stage.SLDASM
00_Gearbox_Master_Layout x 6
Input_Shaft_Sun_Gear
DGBB_6201_2Z x 2
Radial_Seal_12x32x7
Circlip_DIN471_12x1
Bellows_Coupling_D50x68
Stage_1_Ring_Gear
Stage_1_Planet_Gear x 3
Stage_1_Planet_Bearing x 3
Stage_1_Planet_Shaft x 3
Stage_1_Carrier_Front_Plate
Stage_1_Carrier_Rear_Plate
Planet_Thrust_Washer x 12
ISO4762_M5x12 x 3
Stage_2_Sun_Gear
Stage_2_Ring_Gear
Stage_2_Planet_Gear x 3
Stage_2_Planet_Shaft x 3
Stage_2_Carrier_Front_Plate
Stage_2_Carrier_Rear_Plate
Output_Bearing_Spacer
Lock_Washer_MB6
Lock_Nut_KM6
DIN7984_M5x10 x 3
TRB_32006X x 2
Radial_Seal_28x42x7
Output_Housing
Interstage_Spacer_Ring
Input_Housing
Output_Seal_Cover
ISO4762_M6x70 x 8
ISO8734_6x60 x 2
ISO4762_M4x16 x 4
