alanarzamendi/planetary-gearbox-25-1/Assemblies/02_Stage_1_Subassembly.SLDASM

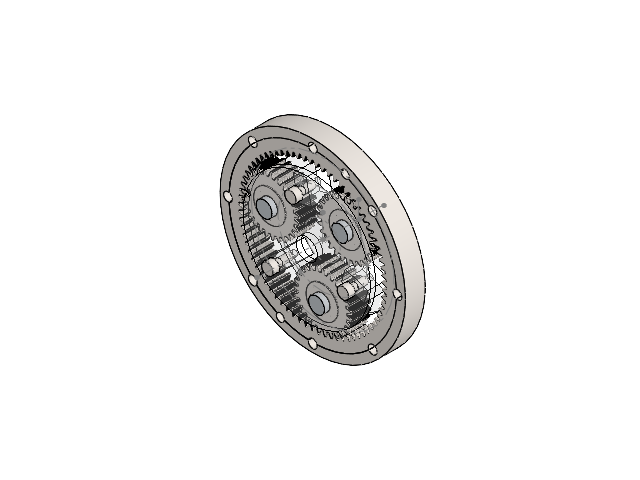
[picture p39: CAD file, 2026-11-06]
Assemblies/02_Stage_1_Subassembly.SLDASM
00_Gearbox_Master_Layout
Stage_1_Ring_Gear
Stage_1_Planet_Gear x 3
Stage_1_Planet_Bearing x 3
Stage_1_Planet_Shaft x 3
Stage_1_Carrier_Front_Plate
Stage_1_Carrier_Rear_Plate
Planet_Thrust_Washer x 6
ISO4762_M5x12 x 3
