alanarzamendi/planetary-gearbox-25-1/Assemblies/05_Housing_Subassembly.SLDASM

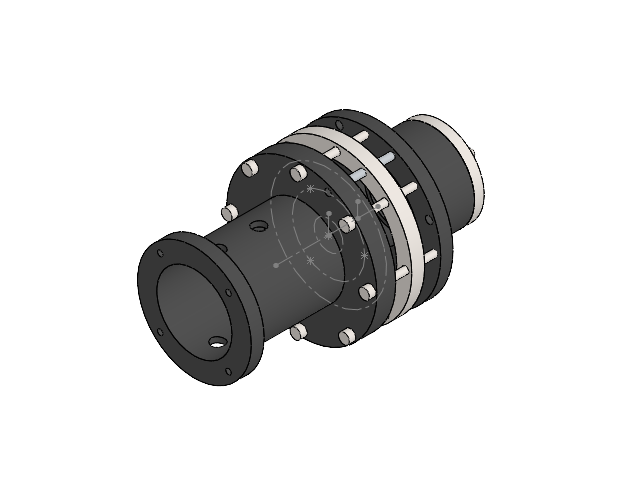
[picture p40: CAD file, 2026-11-06]
Assemblies/05_Housing_Subassembly.SLDASM
00_Gearbox_Master_Layout
Output_Housing
Interstage_Spacer_Ring
Input_Housing
Output_Seal_Cover
ISO4762_M6x70 x 8
ISO8734_6x60 x 2
ISO4762_M4x16 x 4
