alanarzamendi/planetary-gearbox-25-1/(list of files, cad)

Other CAD files:
Master_Layout/00_Gearbox_Master_Layout.SLDPRT
Assemblies/Parts/Stage_1_Planet_Bearing.SLDPRT
Assemblies/Parts/Output_Housing.SLDPRT
Assemblies/Parts/Stage_2_Planet_Gear.SLDPRT
Assemblies/Parts/Stage_1_Ring_Gear.SLDPRT
Assemblies/Parts/DIN7984_M5x10.SLDPRT
Assemblies/Parts/ISO4762_M4x16.SLDPRT
Assemblies/Parts/ISO4762_M5x12.SLDPRT
Assemblies/Parts/ISO4762_M6x70.SLDPRT
Assemblies/Parts/ISO8734_6x60.SLDPRT
Assemblies/Parts/Lock_Nut_KM6.SLDPRT
Assemblies/Parts/Lock_Washer_MB6.SLDPRT
Assemblies/Parts/Planet_Thrust_Washer.SLDPRT
Drawings/PG25-000.SLDDRW
Drawings/PG25-101.SLDDRW
Drawings/PG25-201_302.SLDDRW
Drawings/PG25-202_303.SLDDRW
Drawings/PG25-203.SLDDRW
Drawings/PG25-204.SLDDRW
Drawings/PG25-205.SLDDRW
Drawings/PG25-206.SLDDRW
Drawings/PG25-301.SLDDRW
Drawings/PG25-304.SLDDRW
Drawings/PG25-305.SLDDRW
Drawings/PG25-306.SLDDRW
Drawings/PG25-401.SLDDRW
Drawings/PG25-501.SLDDRW
Drawings/PG25-502.SLDDRW
Drawings/PG25-503.SLDDRW
Drawings/PG25-504.SLDDRW
