alanarzamendi/planetary-gearbox-25-1/Renders/PG25_SW_assembled_trimetric.png

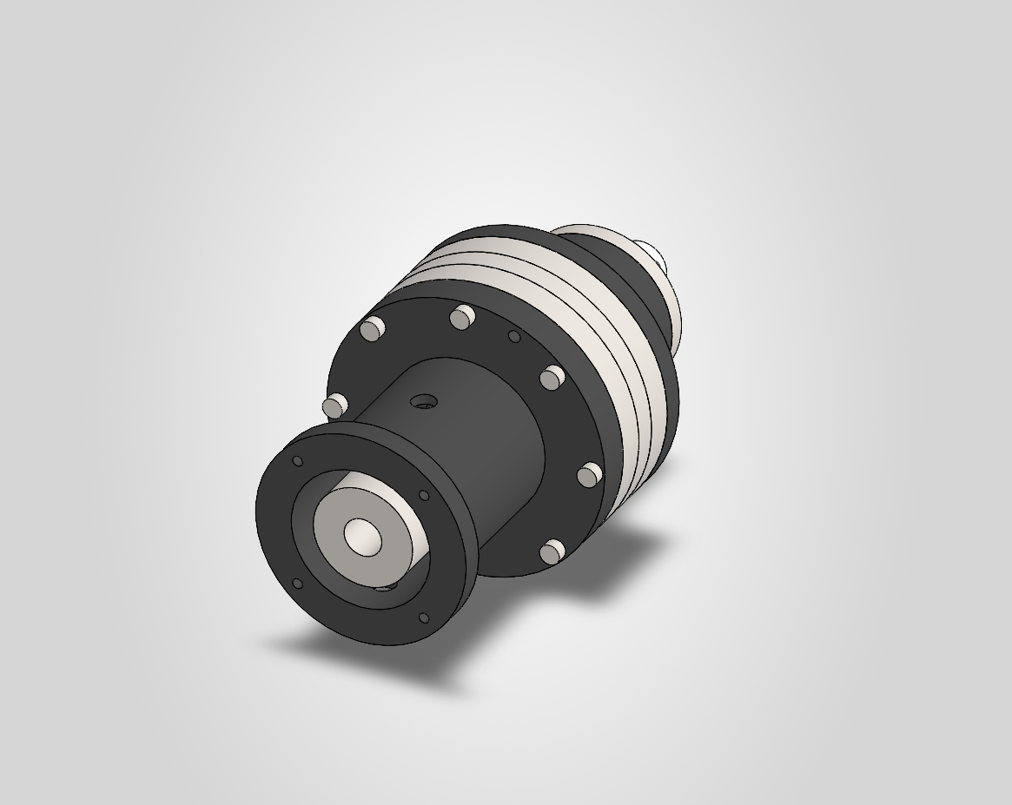
Renders/PG25_SW_assembled_trimetric.png
