alanarzamendi/planetary-gearbox-25-1/Report/Design_Rationale.pdf

## DESIGN NOTEBOOK · TWO-STAGE PLANETARY GEARBOX

# Design rationale of the 25:1 planetary gearbox

The mathematics, standards and decisions behind the design: kinematics, load cases, gear capacity to ISO 6336, materials, bearings, shafts, fits and efficiency. Reasoning only; part dimensions live in the drawings.

## Updated: 5 Nov 2026 Plan steps covered: 2 to 9 (FEA, DFMA)

## Reproducible calculation: Calculations/02_design_calculations.py

01 Kinematics | 02 Torque basis | 03 Gear geometry 04 Tooth forces | 05 Contact | 06 Bending 07 Materials
08 Planet bearing 09 Rating 10 Output bearings | 11 Output shaft | 12 Input | 13 Fits | 14 Interstage | 15 Carriers
16 Planet support | 17 Housing 18 Backlash and tolerancing 19 FEA | 20 DFMA | 21 Efficiency 22 Standards

23 Assumptions

# 01 Kinematics and assembly conditions

Architecture: fixed ring, sun input and carrier output in both stages, three planets per stage. The Willis equation relates the speeds of the three members as seen from the carrier:

Planet speed, absolute and relative to the carrier. The relative speed is what the teeth and the planet bearing see:

## Geometric conditions (18/27/72, N = 3)

Condition | Equation | Value Result
Coaxiality | 72 = 18 + 54 | pass
Equal-spacing assembly | 90 / 3 = 30 | pass
Adjacency (planets clear each other) | 58.46 > 43.5 mm | 15 mm clearance
No undercut with x = 0 | 17.1 < 18 | pass

## Tooth phasing in the CAD assembly

Interference detection on all ten gears was run at the assembled pose and again after turning the input 7.3°, which is not a multiple of any tooth pitch. Every mesh engages. The largest overlap is 0.003 cm³, on the stage 1 ring and planet 1. That is a sliver of about 0.2 mm² across the 15 mm face width, or a few hundredths of a millimetre on the flank. A planet out of phase by half a pitch would overlap by about 0.045 cm³ per tooth. The

## Speeds at 3000 rpm

Stage 1 | 3000 | 600 | 2400 | 1600

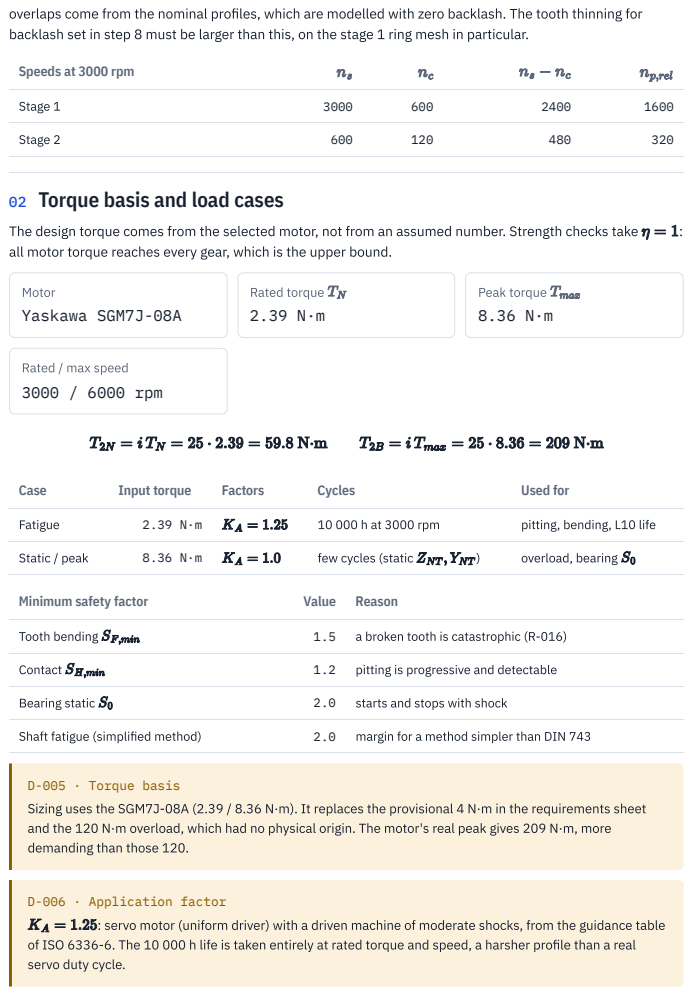
[picture p42: page 2]
Stage 2; The design torque comes from the selected motor, not from an assumed number. Strength checks take; Motor Yaskawa SGM7J-08A; Rated torque 2.39 N·m; Peak torque 8.36 N·m; Case; Input torque; Factors; Cycles; Used for; Fatigue; 10 000 h at 3000 rpm; pitting, bending, L10 life; Static / peak; few cycles (static; overload, bearing; Minimum safety factor; Value Reason; Tooth bending; a broken tooth is catastrophic (R-016); Contact; pitting is progressive and detectable; Bearing static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

overlaps come from the nominal profiles, which are modelled with zero backlash. The tooth thinning for
backlash set in step 8 must be larger than this, on the stage 1 ring mesh in particular.

02 Torque basis and load cases

all motor torque reaches every gear, which is the upper bound.

Rated / max speed
3000 / 6000 rpm

Sizing uses the SGM7J-08A (2.39 / 8.36 N·m). It replaces the provisional 4 N·m in the requirements sheet
and the 120 N·m overload, which had no physical origin. The motor's real peak gives 209 N·m, more
demanding than those 120.

: servo motor (uniform driver) with a driven machine of moderate shocks, from the guidance table

of ISO 6336-6. The 10 000 h life is taken entirely at rated torque and speed, a harsher profile than a real
servo duty cycle.

# 03 Gear geometry

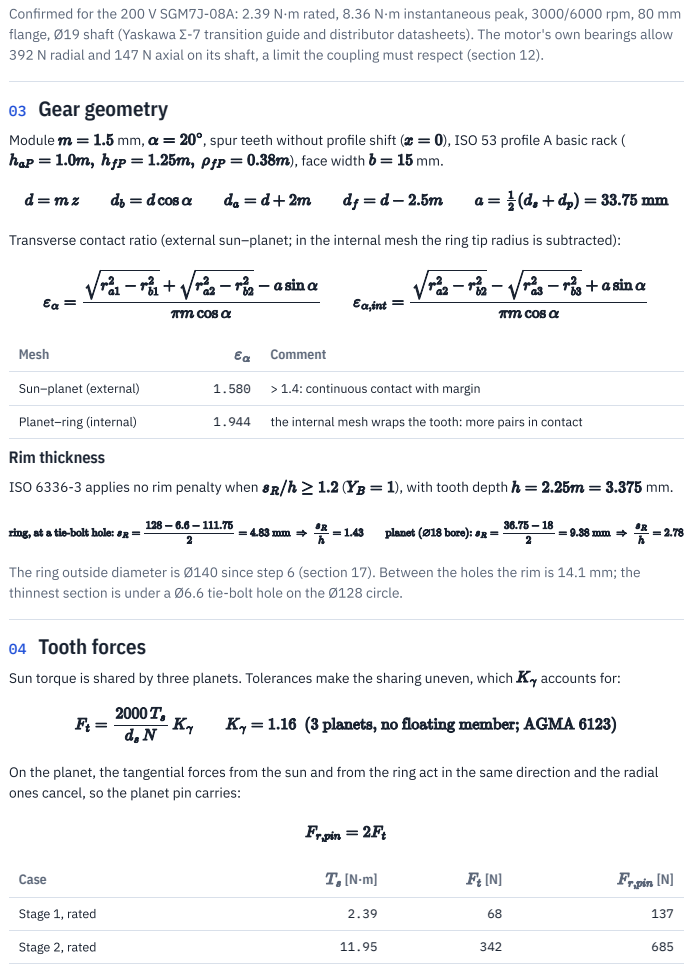
[picture p43: page 3]
Module; , spur teeth without profile shift (; ), ISO 53 profile A basic rack (; ), face width; Mesh; Comment; Sun–planet (external); > 1.4: continuous contact with margin; Planet–ring (internal); the internal mesh wraps the tooth: more pairs in contact; Rim thickness; ISO 6336-3 applies no rim penalty when; ), with tooth depth; Sun torque is shared by three planets. Tolerances make the sharing uneven, which; accounts for:; Case; Stage 1, rated; Stage 2, rated

Confirmed for the 200 V SGM7J-08A: 2.39 N·m rated, 8.36 N·m instantaneous peak, 3000/6000 rpm, 80 mm
flange, Ø19 shaft (Yaskawa Σ-7 transition guide and distributor datasheets). The motor's own bearings allow
392 N radial and 147 N axial on its shaft, a limit the coupling must respect (section 12).

Transverse contact ratio (external sun–planet; in the internal mesh the ring tip radius is subtracted):

The ring outside diameter is Ø140 since step 6 (section 17). Between the holes the rim is 14.1 mm; the
thinnest section is under a Ø6.6 tie-bolt hole on the Ø128 circle.
04 Tooth forces

On the planet, the tangential forces from the sun and from the ring act in the same direction and the radial
ones cancel, so the planet pin carries:

Stage 2, peak | 41.8 | 1197 | 2394

# 05 Contact stress (ISO 6336-2)

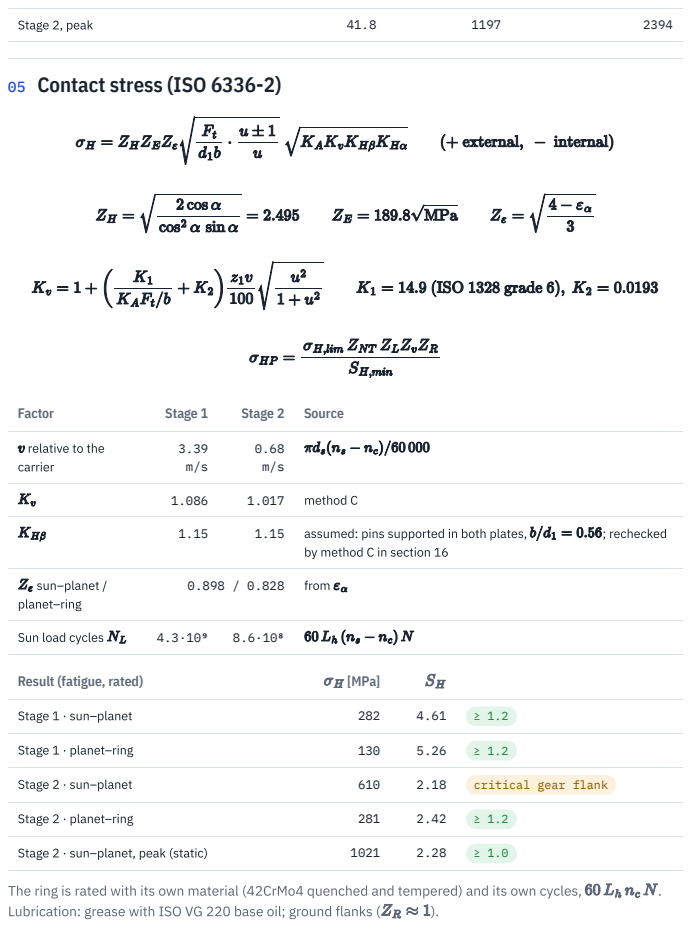
[picture p44: page 4]
Factor; Stage 1; Stage 2 Source; method C; assumed: pins supported in both plates,; ; rechecked; sun–planet /; planet–ring; from; Sun load cycles; Result (fatigue, rated); [MPa]; Stage 1 · sun–planet; Stage 1 · planet–ring; Stage 2 · sun–planet; critical gear flank; Stage 2 · planet–ring; Stage 2 · sun–planet, peak (static); The ring is rated with its own material (42CrMo4 quenched and tempered) and its own cycles,; Lubrication: grease with ISO VG 220 base oil; ground flanks (

relative to the
carrier

by method C in section 16

# 06 Tooth-root stress (ISO 6336-3, method B)

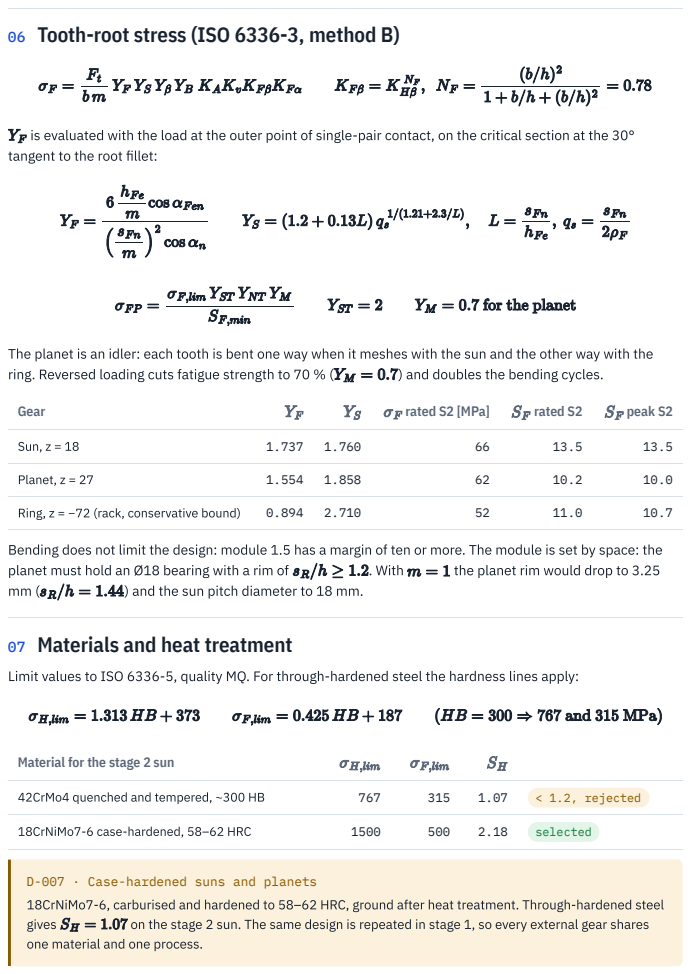
[picture p45: page 5]
ring. Reversed loading cuts fatigue strength to 70 % (; ) and doubles the bending cycles.; Gear; rated S2 [MPa]; rated S2; peak S2; Sun, z = 18; Planet, z = 27; Ring, z = −72 (rack, conservative bound); planet must hold an Ø18 bearing with a rim of; . With; the planet rim would drop to 3.25; ) and the sun pitch diameter to 18 mm.; 42CrMo4 quenched and tempered, ~300 HB; < 1.2, rejected; 18CrNiMo7-6 case-hardened, 58–62 HRC; selected; gives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

is evaluated with the load at the outer point of single-pair contact, on the critical section at the 30°
tangent to the root fillet:

The planet is an idler: each tooth is bent one way when it meshes with the sun and the other way with the

Bending does not limit the design: module 1.5 has a margin of ten or more. The module is set by space: the
07 Materials and heat treatment

Limit values to ISO 6336-5, quality MQ. For through-hardened steel the hardness lines apply:

Material for the stage 2 sun

D-007 · Case-hardened suns and planets

18CrNiMo7-6, carburised and hardened to 58–62 HRC, ground after heat treatment. Through-hardened steel
one material and one process.

## D-008 · Through-hardened ring, not nitrided

## D-009 · Planet pin as the raceway

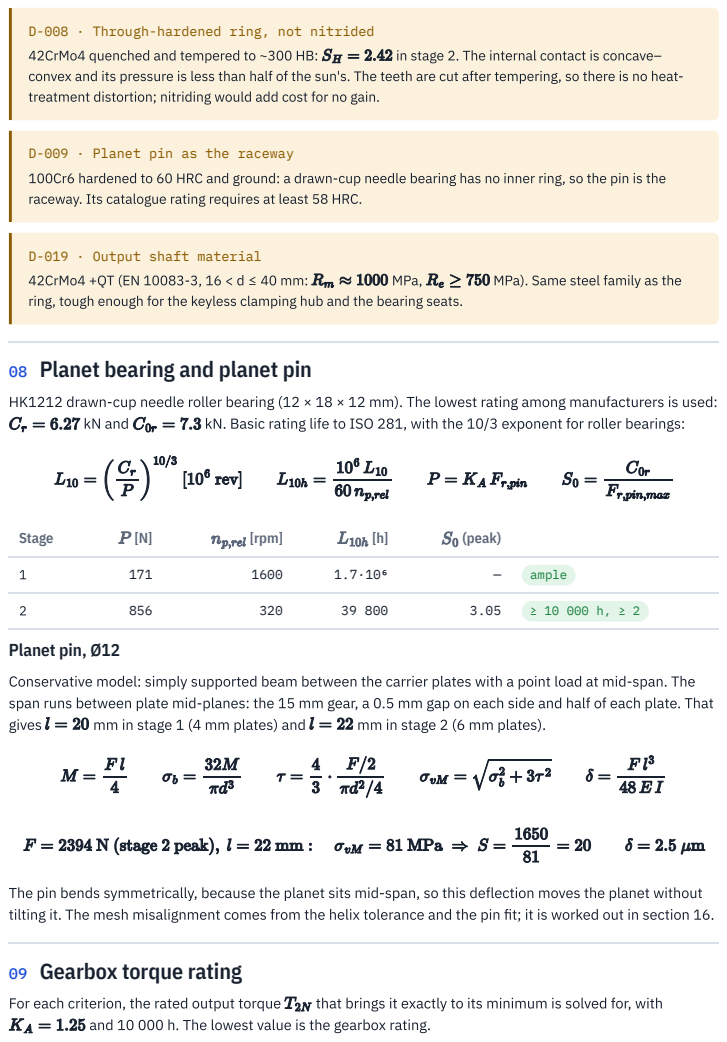
[picture p46: page 6]
42CrMo4 quenched and tempered to ~300 HB:; in stage 2. The internal contact is concave–; 42CrMo4 +QT (EN 10083-3, 16 < d ≤ 40 mm:; MPa,; MPa). Same steel family as the; kN and; kN. Basic rating life to ISO 281, with the 10/3 exponent for roller bearings:; Stage; [rpm]; (peak); ample; Planet pin, Ø12; gives; mm in stage 1 (4 mm plates) and; mm in stage 2 (6 mm plates).; For each criterion, the rated output torque; that brings it exactly to its minimum is solved for, with

convex and its pressure is less than half of the sun's. The teeth are cut after tempering, so there is no heat-
treatment distortion; nitriding would add cost for no gain.

100Cr6 hardened to 60 HRC and ground: a drawn-cup needle bearing has no inner ring, so the pin is the
raceway. Its catalogue rating requires at least 58 HRC.

D-019 · Output shaft material

ring, tough enough for the keyless clamping hub and the bearing seats.

08 Planet bearing and planet pin

HK1212 drawn-cup needle roller bearing (12 × 18 × 12 mm). The lowest rating among manufacturers is used:

Conservative model: simply supported beam between the carrier plates with a point load at mid-span. The
span runs between plate mid-planes: the 15 mm gear, a 0.5 mm gap on each side and half of each plate. That

The pin bends symmetrically, because the planet sits mid-span, so this deflection moves the planet without
tilting it. The mesh misalignment comes from the helix tolerance and the pin fit; it is worked out in section 16.
09 Gearbox torque rating

and 10 000 h. The lowest value is the gearbox rating.

0 | 100 | 200 | 300 | 400 N·m
Planet bearing S2 | 90 · governs
Sun–planet contact S2 | 198
Planet–ring contact S2 | 243
Planet bending S2 | 409

motor: 60

The contact bars use the assumed | . With | from the misalignment budget instead (section
16: M6 pin fit, flanks without crowning), stage 2 contact allows 113 N·m. That is still above 90, so the bearing still governs.

## D-010 · Rating limited by the planet bearing

The gearbox is rated at about 90 N·m for 10 000 h, 1.5 times the motor's rated torque. The teeth would carry

twice that; the limit is the bearing that fits inside a 40.5 mm planet. If more life were needed, the right move

is a wider bearing (HK1216) or two in parallel, not a larger module.

## D-011 · Two identical stages

Stage 1 runs at one fifth of the torque ( | ) and could be narrower, but both stages keep | and

. That gives one design of planet, pin, bearing and ring: half the part numbers, one set of tooling and

no mix-ups at assembly.

# 10 Output external loads and bearings

Two 32006 X tapered roller bearings (30 × 55 × 17 mm) in O arrangement with a 10 mm spacer. SKF lists
kN, | kN, | , | , | . The calculation uses | kN, the lowest
rating found for an interchangeable 32006 X, so any supplier's bearing meets the life. In an O arrangement each pressure centre sits outside the roller centre by:

: effective spread between pressure centres (midplanes 27 mm apart). : overhang from the load point, at mid-length of the 40 mm shaft extension, to the front pressure centre. The 23.5 mm from the shaft shoulder to the front bearing midplane comes from the CAD layout: KM6 locknut and washer (8 mm), Ø28 seal land (7 mm), half the bearing (8.5 mm). Diameters only step down toward the free end, so both cones slide on from the output side.

Criterion | [kN]

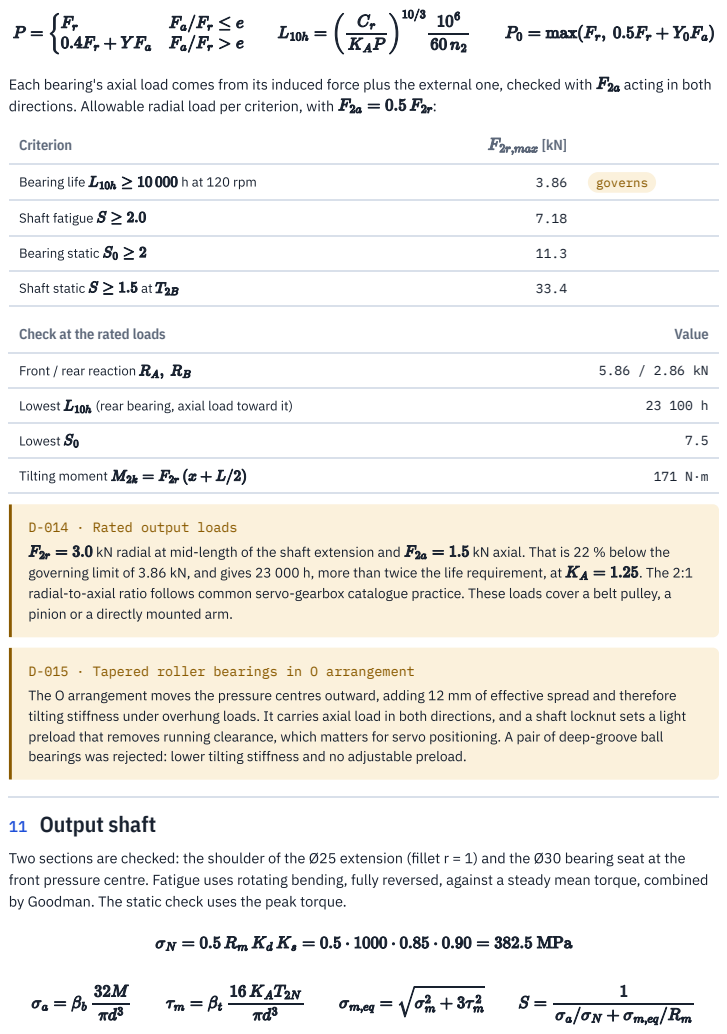
[picture p47: page 8]
Each bearing's axial load comes from its induced force plus the external one, checked with; acting in both; directions. Allowable radial load per criterion, with; Bearing life; h at 120 rpm; governs; Shaft fatigue; Bearing static; Shaft static; Check at the rated loads; Value; Front / rear reaction; Lowest; (rear bearing, axial load toward it); Tilting moment; kN radial at mid-length of the shaft extension and; kN axial. That is 22 % below the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

D-014 · Rated output loads

radial-to-axial ratio follows common servo-gearbox catalogue practice. These loads cover a belt pulley, a
pinion or a directly mounted arm.

D-015 · Tapered roller bearings in O arrangement

The O arrangement moves the pressure centres outward, adding 12 mm of effective spread and therefore
tilting stiffness under overhung loads. It carries axial load in both directions, and a shaft locknut sets a light
preload that removes running clearance, which matters for servo positioning. A pair of deep-groove ball
bearings was rejected: lower tilting stiffness and no adjustable preload.

Two sections are checked: the shoulder of the Ø25 extension (fillet r = 1) and the Ø30 bearing seat at the
front pressure centre. Fatigue uses rotating bending, fully reversed, against a steady mean torque, combined
by Goodman. The static check uses the peak torque.

Section | [N·m] | | [MPa] | [MPa] | fatigue | static
Ø25 shoulder | 60.0 | 1.8 / 1.4 | 70.4 | 34.1 | 4.11 | 5.99
Ø30 bearing seat | 112.2 | 1.6 / 1.3 | 67.7 | 18.3 | 4.79 | 9.20

## D-016 · Keyless output shaft, Ø25 h6

A parallel key has side clearance, which shows up as backlash in a servo axis, and its keyway is a notch with

–2.3. At peak torque a DIN 6885 key 8 × 7 × 32 would also see a hub pressure of

MPa, too high for an unknown customer hub. A

clamping hub or shrink disc transmits the torque by friction, without backlash.

# 12 Input side

Input shaft Ø12, integral with the stage 1 sun. The sun root diameter is 1.94 times the shaft diameter, so the sun body is never weakened by the shaft.

Three planets at 120° cancel each other's mesh forces on the sun, | in the ideal case. The input
bearings therefore carry only the coupling's restoring force and the shaft's weight, generously taken as 200 N per bearing:

## D-017 · Input bearings and coupling

Two 6201-2Z deep-groove ball bearings, chosen by shaft size, since load does not size them. Shields rather

than contact seals keep friction low at 6000 rpm; a separate lip seal closes the gearbox, at a surface speed

well within the usual limit for elastomer seals. The motor connects through a metal bellows coupling,

torsionally stiff and free of backlash, rated at | N·m, with hub bores Ø19 (motor,

confirmed) and Ø12 (gearbox).

The coupling also protects the motor: the force it puts on the motor shaft must stay below the motor's
allowable radial load. With the 200 N design assumption the margin is | , and a bellows
coupling's lateral stiffness keeps the real force far lower for the misalignment a machined adapter flange allows.

# 13 Fits (ISO 286)

Rule: the ring that rotates relative to the load gets interference, so it cannot creep. The ring under a stationary load gets a transition fit, so the floating bearing can slide axially. Bearing ring tolerances follow ISO 492,

Joint | Nominal Fit | Range [µm]

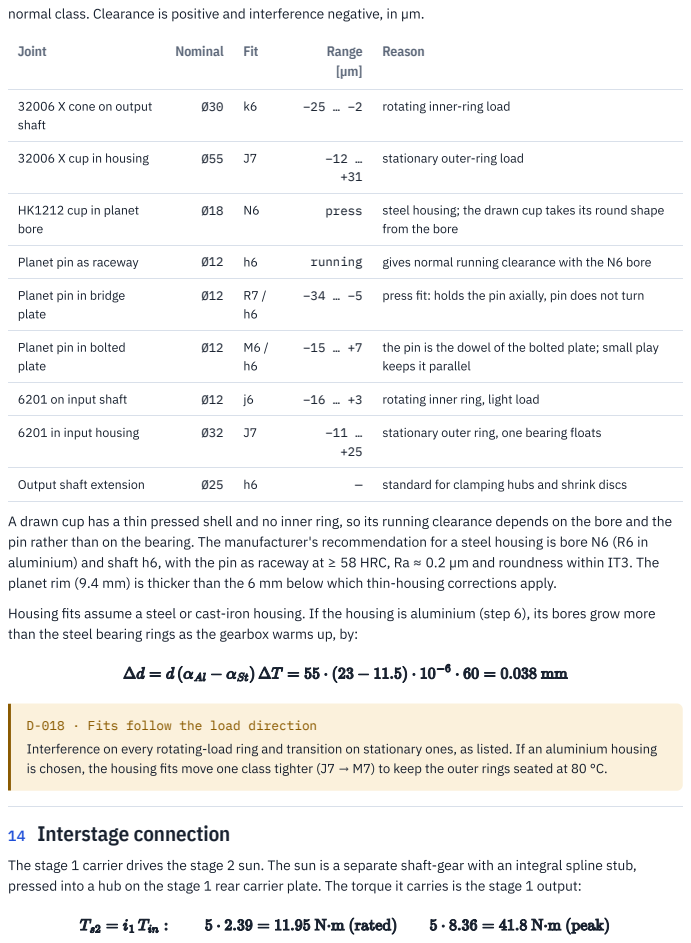
[picture p48: page 10]
Reason; rotating inner-ring load; 32006 X cup in housing; press; steel housing; the drawn cup takes its round shape; Planet pin as raceway; running; gives normal running clearance with the N6 bore; press fit: holds the pin axially, pin does not turn; the pin is the dowel of the bolted plate; small play; 6201 on input shaft; rotating inner ring, light load; 6201 in input housing; Output shaft extension; standard for clamping hubs and shrink discs; 14 Interstage connection

normal class. Clearance is positive and interference negative, in µm.

32006 X cone on output
shaft

stationary outer-ring load

HK1212 cup in planet
bore

from the bore

Planet pin in bridge
plate

Planet pin in bolted

keeps it parallel

stationary outer ring, one bearing floats

A drawn cup has a thin pressed shell and no inner ring, so its running clearance depends on the bore and the
pin rather than on the bearing. The manufacturer's recommendation for a steel housing is bore N6 (R6 in
aluminium) and shaft h6, with the pin as raceway at ≥ 58 HRC, Ra ≈ 0.2 µm and roundness within IT3. The

planet rim (9.4 mm) is thicker than the 6 mm below which thin-housing corrections apply.

Housing fits assume a steel or cast-iron housing. If the housing is aluminium (step 6), its bores grow more
than the steel bearing rings as the gearbox warms up, by:

D-018 · Fits follow the load direction

Interference on every rotating-load ring and transition on stationary ones, as listed. If an aluminium housing
is chosen, the housing fits move one class tighter (J7 → M7) to keep the outer rings seated at 80 °C.

The stage 1 carrier drives the stage 2 sun. The sun is a separate shaft-gear with an integral spline stub,
pressed into a hub on the stage 1 rear carrier plate. The torque it carries is the stage 1 output:

Flank pressure of an involute spline (DIN 5480 W 16 × 1 × 14, engaged length | mm, load-sharing factor
, bearing depth | ):

## D-020 · Splined interstage, not one integral part

A single part (carrier plate plus sun) would save one joint. But its sun teeth would sit next to a Ø96 flange that

blocks the grinding wheel, and the whole carrier would have to be carburised with the sun. As two parts, the

sun is ground as a plain shaft-gear and case-hardened on its own, the carrier stays in 42CrMo4 +QT, and each

stage can be assembled and run separately. An interference spline fit removes the spline's backlash. A Ø20

shoulder, below the sun root diameter of 23.25 mm, gives the axial stop and the grinding run-out. The

intermediate member floats radially on six planets, which also helps load sharing.

# 15 Carrier cages

Each carrier is a cage: one plate carries three bridges between the planets, and the opposite plate is screwed to them (3 × M5). The far plate passes half of every pin force back to the output plate through the bridges. They are modelled as guided beams between the plates, with a 16 mm gap and a 10 × 18 mm section:

The bridges must clear the spinning planets. A bridge centred mid-way between two planets, at the planet-
centre radius, has its nearest planet centre at | radially and
tangentially:

Radially the bridge spans 24.75 to 42.75 mm, outside the sun tip (15 mm) and inside the ring tip (52.5 mm).

## D-021 · Bolted cages, low-head screws on stage 2

The stage 2 rear plate sits 1 mm from the stage 1 carrier, which turns five times faster. Its screws are low-

head DIN 7984 M5 in Ø10 × 3.5 counterbores inside the 6 mm plate, so nothing protrudes. The plate bore

grows from Ø16 to Ø30 to pass the Ø26 spline hub with 2 mm radial clearance.

## D-022 · Output shaft integral with the stage 2 carrier

The output plate and the output shaft are one 42CrMo4 +QT part. This removes a torque joint at the highest

torque in the gearbox (209 N·m peak), along with its run-out. It also lets the bearing seats be ground in the

same set-up as the pin bores.

# 16 Planet thrust washers, pin retention and face-load factor

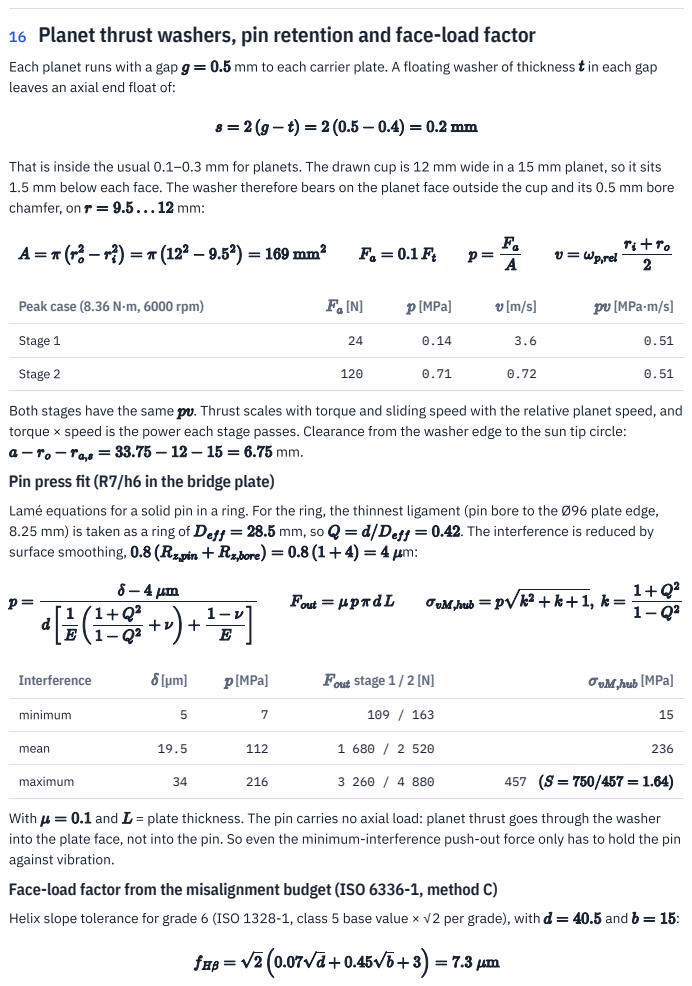
[picture p49: page 12]
Each planet runs with a gap; mm to each carrier plate. A floating washer of thickness in each gap; chamfer, on; Peak case (8.36 N·m, 6000 rpm); [MPa]; [MPa·m/s]; Stage 1; Stage 2; Both stages have the same; . Thrust scales with torque and sliding speed with the relative planet speed, and; 8.25 mm) is taken as a ring of; . The interference is reduced by; surface smoothing,; Interference; stage 1 / 2 [N]; minimum; mean; maximum; With; and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

leaves an axial end float of:

That is inside the usual 0.1–0.3 mm for planets. The drawn cup is 12 mm wide in a 15 mm planet, so it sits
1.5 mm below each face. The washer therefore bears on the planet face outside the cup and its 0.5 mm bore

torque × speed is the power each stage passes. Clearance from the washer edge to the sun tip circle:

Pin press fit (R7/h6 in the bridge plate)

Lamé equations for a solid pin in a ring. For the ring, the thinnest ligament (pin bore to the Ø96 plate edge,

into the plate face, not into the pin. So even the minimum-interference push-out force only has to hold the pin
against vibration.
Face-load factor from the misalignment budget (ISO 6336-1, method C)

The pin is clamped in the bridge plate. At the bolted plate it can shift by half the maximum fit play , which tilts it across the face width over the span :

The shaft-bending term | is taken as zero: the planet sits at mid-span and the sun floats. | applies
without flank modification and | with helix crowning (ISO 6336-1, table 8). Stage 2 at the rated case,
N/mm:
Bolted-plate fit | [µm] | [µm] Flanks
M6 / h6 | 7 | 2.4 | not crowned | 2.77 | 1.41 | ≥ 1.2
M6 / h6 | 7 | 2.4 | helix crowning | 1.96 | 1.67 | selected
K7 / h6 | 17 | 5.8 | not crowned | 3.05 | 1.34 | rejected
K7 / h6 | 17 | 5.8 | helix crowning | 2.16 | 1.59
At these light loads the line load is small next to the mesh stiffness times the misalignment, so | lands on
its upper branch. There | instead of | : the factor is large, but the contact stress grows slowly.
Stage 1 ( | N/mm) gives | and still has | . The lowest root safety in stage 2 is

## D-023 · Floating hardened-steel thrust washers, 0.4 mm

Two washers per planet, Ø12.2 × Ø24 × 0.4 mm, in 1.8159 (51CrV4) hardened and tempered to 45–50 HRC.

Without them the case-hardened planet face (about 60 HRC) would wear the 42CrMo4 +QT plate (about 30

HRC). The 0.4 mm thickness fits the existing 0.5 mm gaps with 0.2 mm end float, so no plate, bridge or shaft

moves. A polymer washer could not be made that thin and still last, and with | MPa·m/s, greased

steel is enough. The Ø24 outside diameter bears on the planet face outside the needle cup and stays 6.75

mm clear of the sun.

## D-024 · Pins pressed into the bridge plate, M6 in the bolted plate

Assembly order:

1. Bolt the cage together.
2. Finish both pin bores in one set-up, so they are coaxial.
3. Slide the planets and washers in radially between the bridges.
4. Press each pin through the bolted plate and the needle bearing into the bridge plate.

R7 in the bridge plate holds the pin axially and stops it turning. M6 in the bolted plate makes the three pins

the dowels of that plate, and its 7 µm maximum play keeps the pin tilt at 2.4 µm across the face. The cage

can still be taken apart by pressing the pins out. K7 would assemble more easily, but its 17 µm play costs

about 0.07 in .

µ

## D-025 · Helix crowning on the planets

# 17 Housing, ring retention and mounting

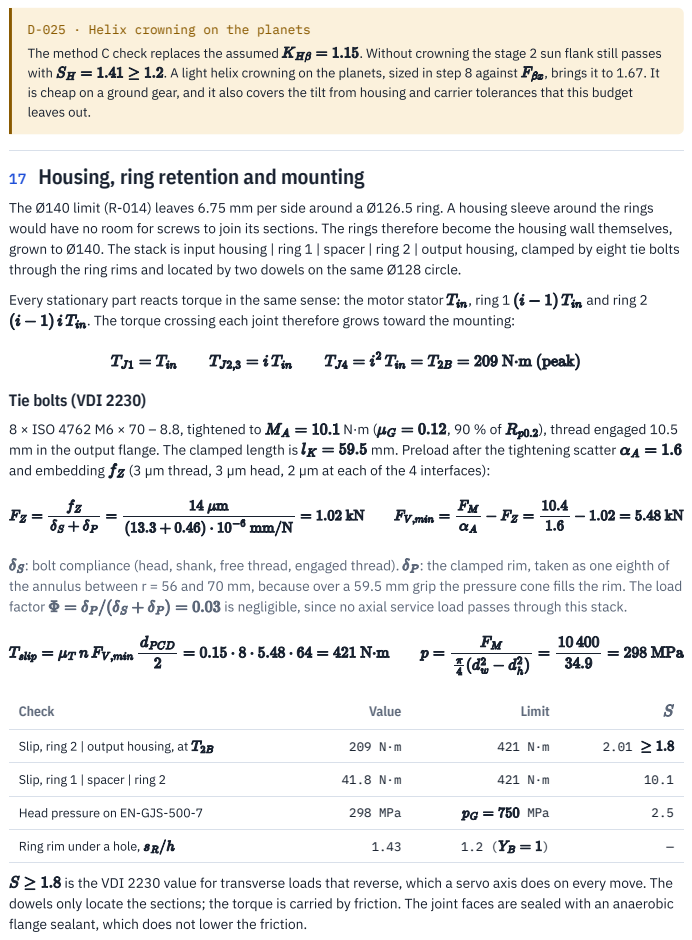
[picture p50: page 14]
The method C check replaces the assumed; . Without crowning the stage 2 sun flank still passes; with; . A light helix crowning on the planets, sized in step 8 against; , brings it to 1.67. It; Every stationary part reacts torque in the same sense: the motor stator; , ring 1; and ring 2; 8 × ISO 4762 M6 × 70 – 8.8, tightened to; ), thread engaged 10.5; mm in the output flange. The clamped length is; mm. Preload after the tightening scatter; and embedding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

is cheap on a ground gear, and it also covers the tilt from housing and carrier tolerances that this budget
leaves out.

The Ø140 limit (R-014) leaves 6.75 mm per side around a Ø126.5 ring. A housing sleeve around the rings
would have no room for screws to join its sections. The rings therefore become the housing wall themselves,
grown to Ø140. The stack is input housing | ring 1 | spacer | ring 2 | output housing, clamped by eight tie bolts
through the ring rims and located by two dowels on the same Ø128 circle.

. The torque crossing each joint therefore grows toward the mounting:

Tie bolts (VDI 2230)

the annulus between r = 56 and 70 mm, because over a 59.5 mm grip the pressure cone fills the rim. The load

is the VDI 2230 value for transverse loads that reverse, which a servo axis does on every move. The

dowels only locate the sections; the torque is carried by friction. The joint faces are sealed with an anaerobic
flange sealant, which does not lower the friction.

## Bearing arrangement in the housings

Output: the two 32006 X cups sit on either side of a 10 mm housing collar (bore Ø48, inside the cup abutment range). The cones are clamped by the KM6 nut against the Ø36 shaft shoulder through a 10 mm inner spacer. The bearing setting, light preload or zero clearance, is the difference between the ground spacer and the collar widths, so tightening the nut fixes it rather than adjusts it. Input: the two 6201 are cross-located against a central housing collar (Ø27), and each takes one axial direction. This replaces the "one bearing floats" of D-017; with 20 mm between the bearings and the same material for shaft and housing, thermal expansion is negligible.

Output stack along the shaft, from the carrier:

Ø36 shoulder.
32006 X rear, z −44 … −61.
Cone spacer Ø30/Ø35 × 10.
32006 X front, z −71 … −88.
MB 6 lock washer, DIN 5406, 1 mm. Its inner tab runs in a 6 mm shaft groove. KM 6 nut, Ø45 × 7, ending at z −96.
A 1 mm running gap.
The 28 × 42 × 7 seal on the Ø28 land, at z −97 … −104.

The seal cover is 9 mm thick, so the turning nut cannot touch it. The nut, washer and cone spacer turn with the output shaft, so they are mated to the carrier. The cups and the seal are stationary.

Input stack, from the sun:

Ø15 shoulder.
6201-2Z, z 15 … 25.
Ø27 housing collar.
6201-2Z, z 35 … 45.
DIN 471 circlip, 12 × 1.
The 12 × 32 × 7 seal at z 47 … 54.
The bellows coupling, Ø50 envelope, z 55 … 123. Its gearbox hub covers z 55 … 75; its motor hub covers z 85 … 123 and takes the full 40 mm of the Ø19 shaft.

The two clamp screws line up with the Ø12 access holes at z 65 and 103. With all purchased parts modelled, the gearbox weighs 10.1 kg without the motor.

Fasteners in the model:

Tie bolts: 8 × ISO 4762 M6 × 70 – 8.8, heads on the input flange at z = 25, engaging 10.5 mm in the output flange.
Dowels: 2 × ISO 8734 Ø6 m6 × 60, through the whole stack from z 16 to −44. The holes are line-reamed with the stack clamped, so one pin locates all five sections.
Seal cover: 4 × ISO 4762 M4 × 16, engaging 7 mm.
Carrier cages: 3 × M5 per stage.

An interference check of all 67 non-gear parts finds only the threads engaged in their tap-drill holes, with the expected volumes, and nothing else.

## Carrier cage screws

One M5 – 8.8 per bridge clamps the bolted plate to the bridge: ISO 4762 M5 × 12 in stage 1, and DIN 7984 M5 × 10 sunk in the Ø10 counterbores in stage 2 (D-021), each engaging 7.5–8 mm in 42CrMo4. The bridge
shear | from section 15 has to cross that joint:
Bridge shear | rated × | [N] | friction | peak [N] | friction
Stage 1 | | 74 | 7.9 | 206 | 2.8
Stage 2 | | 369 | 1.58 | 1 032 | 0.56

## D-029 · Cage screws clamp, the planet pins locate

Friction alone holds the stage 2 cage in continuous operation ( | ) but not at peak acceleration torque.

There the bolted plate can shift by at most the 7 µm play of the M6 pin fit, and then the three pins carry the

shear as dowels: 9 MPa in one pin even if it took the whole bridge force. This is the role D-024 already gave

the M6 fit, so no extra dowels are needed. The screws are tightened to 5.9 N·m and secured with medium-

strength thread locker. They see no service tension, because the planet loads close through the pins and

bridges.

## Mounting

The gearbox mounts by the flange face at z = −46 mm, with 4 × M8 – 10.9 tapped through the flange. The Ø80 h7 bearing neck is the centring spigot, and it carries the radial load by form fit, so the bolts carry only torque and tilting moment:

The rated external loads (D-014) are combined with the peak torque, which is conservative. allows 10 % embedding in the customer's plate. The thread engages 1.44 d in the cast iron.

## Overall length (R-015)

Mounting face to motor face, z −46 to +125, gives | mm. The input chain sets it: input shaft to z = 75,
a bellows coupling from z 55 to 123, and an SGM7J-08 shaft 40 mm long that has to sit fully in the motor hub. The output shaft extension and the motor are excluded.

## Heat balance at the rated point

is the outer surface of the housing, rings and motor adapter. | W/(m²·K) is natural convection plus
radiation from a painted surface, and the 10 W covers the input seal, the bearings and grease churning. At 25

°C ambient the housing stays at 53–76 °C, inside the 80 °C behind D-018 and the usual grease limit. Conduction into the machine is ignored, and so is heat from the motor flange; the two partly cancel.

## D-026 · Ring gears as housing sections

The rings grow from Ø126.5 to Ø140 and take 8 × Ø6.6 tie-bolt holes and 2 × Ø6 dowel holes on Ø128. This

gives the most material inside R-014, and the 42CrMo4 +QT rings become the stiffest part of the wall. The

alternative, a sleeve around Ø126.5 rings, was rejected. With only a 6.75 mm wall, the input housing could

not be screwed to it. Holding the rings by press fit alone would need an s6-class interference, and that

shrinks the ring teeth by up to about 0.05 mm on diameter, which eats into backlash. The exposed ring OD

gets black oxide.

## D-027 · Housings in EN-GJS-500-7

Input and output housings in ductile iron. Its expansion (11.5 µm/(m·K)) matches the steel rings and

bearings, so the dowels and the J7 bearing fits of D-018 stay valid hot. It damps gear noise better than steel

and casts close to shape. Aluminium was rejected. It would save about 2 kg, but between the Ø128 dowels it

would move 0.044 mm radially against the steel rings for a 60 K rise, and every housing fit would have to

move to M7. The spacer and the seal cover are turned from C45. Masses from CAD: input housing 2.58 kg,

output housing 1.74 kg, the two rings 0.69 kg each, spacer 0.49 kg and cover 0.24 kg. That is 6.4 kg of

structure in a 9.2 kg gearbox as modelled, before the purchased parts.

## D-028 · Flange at the ring stack; R-015 revised to 175 mm

The mounting flange sits on the output housing next to ring 2, where the wall is thickest, and the bearing neck

forms the spigot. Moving the flange to the output end would add 50 mm. The 160 mm in R-015 was

provisional and dated from before the coupling and motor shaft were known; it is revised to 175 mm,

mounting face to motor face. The way to shorten the gearbox would be a hollow input shaft that clamps the

motor shaft directly, the usual catalogue design. It is not adopted, because D-017 keeps the bellows coupling

to protect the motor bearings.

# 18 Backlash, gear inspection and tolerancing
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
