alanarzamendi/planetary-gearbox-25-1/Drawings/PG25-000.pdf

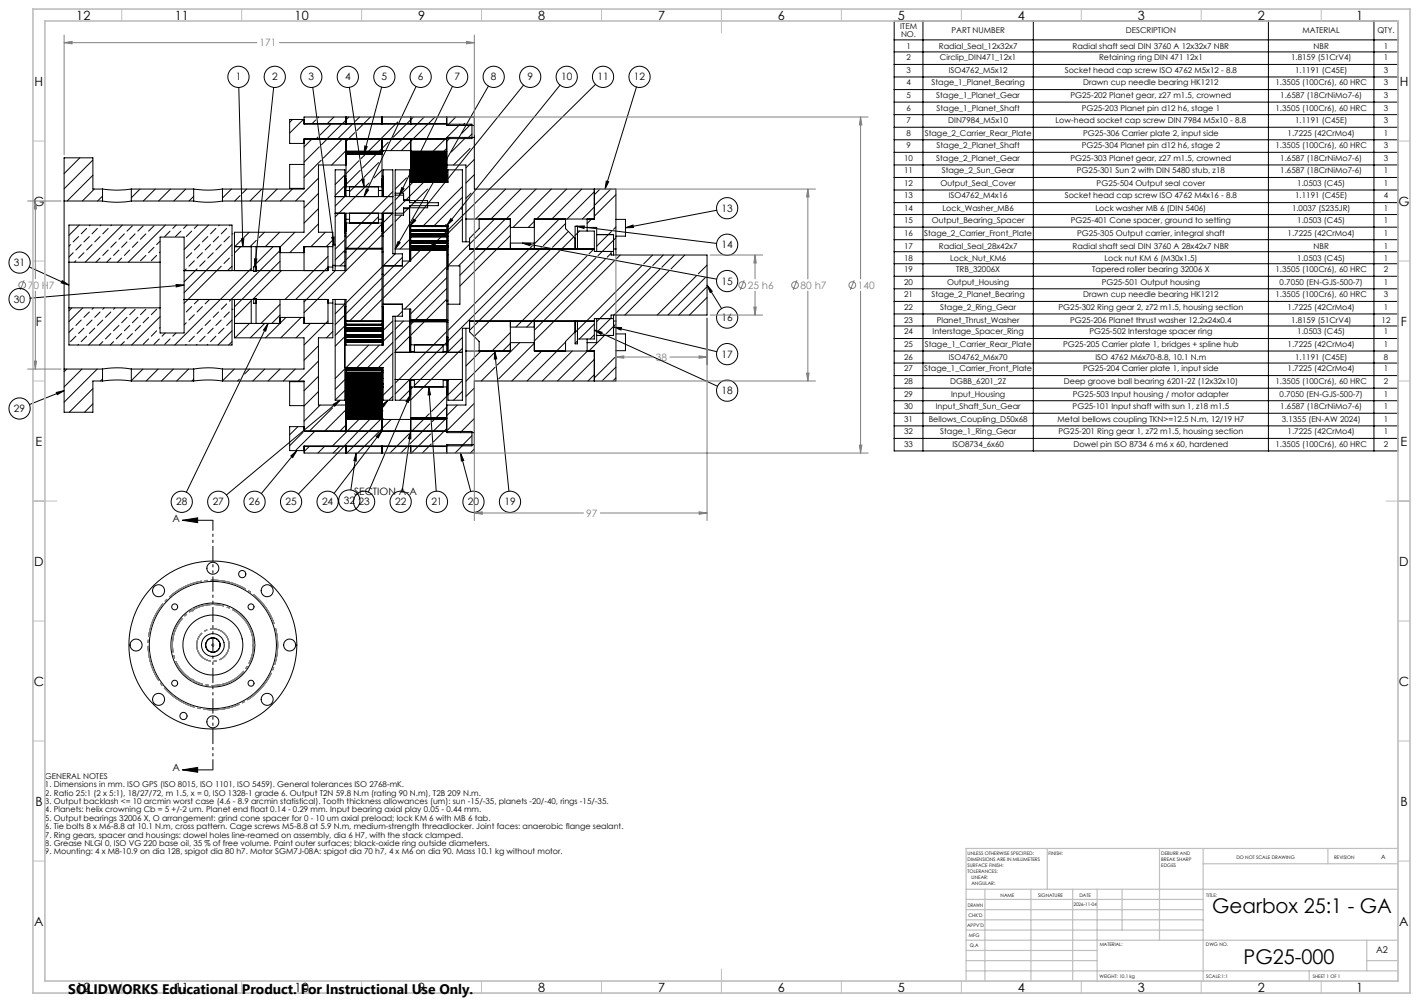
[picture p51: page 1]
SECTION A-A; PART NUMBER; DESCRIPTION; MATERIAL; QTY.; Radial_Seal_12x32x7; Radial shaft seal DIN 3760 A 12x32x7 NBR; NBR; Circlip_DIN471_12x1; Retaining ring DIN 471 12x1; 1.8159 (51CrV4); ISO4762_M5x12; Socket head cap screw ISO 4762 M5x12 - 8.8; Stage_1_Planet_Bearing; Drawn cup needle bearing HK1212; 1.3505 (100Cr6), 60 HRC; Stage_1_Planet_Gear; PG25-202 Planet gear, z27 m1.5, crowned; 1.6587 (18CrNiMo7-6); Stage_1_Planet_Shaft; PG25-203 Planet pin d12 h6, stage 1; DIN7984_M5x10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

GENERAL NOTES
1. Dimensions in mm. ISO GPS (ISO 8015, ISO 1101, ISO 5459). General tolerances ISO 2768-mK.
2. Ratio 25:1 (2 x 5:1), 18/27/72, m 1.5, x = 0, ISO 1328-1 grade 6. Output T2N 59.8 N.m (rating 90 N.m), T2B 209 N.m.
3. Output backlash <= 10 arcmin worst case (4.6 - 8.9 arcmin statistical). Tooth thickness allowances (um): sun -15/-35, planets -20/-40, rings -15/-35.
4. Planets: helix crowning Cb = 5 +/-2 um. Planet end float 0.14 - 0.29 mm. Input bearing axial play 0.05 - 0.44 mm.
5. Output bearings 32006 X, O arrangement: grind cone spacer for 0 - 10 um axial preload; lock KM 6 with MB 6 tab.
6. Tie bolts 8 x M6-8.8 at 10.1 N.m, cross pattern. Cage screws M5-8.8 at 5.9 N.m, medium-strength threadlocker. Joint faces: anaerobic flange sealant.
7. Ring gears, spacer and housings: dowel holes line-reamed on assembly, dia 6 H7, with the stack clamped.
8. Grease NLGI 0, ISO VG 220 base oil, 35 % of free volume. Paint outer surfaces; black-oxide ring outside diameters.
9. Mounting: 4 x M8-10.9 on dia 128, spigot dia 80 h7. Motor SGM7J-08A: spigot dia 70 h7, 4 x M6 on dia 90. Mass 10.1 kg without motor.

UNLESS OTHERWISE SPECIFIED: DIMENSIONS ARE IN MILLIMETERS SURFACE FINISH: TOLERANCES: LINEAR: ANGULAR: | FINISH: | DEBURR AND BREAK SHARP EDGES | DO NOT SCALE DRAWING | REVISION A

NAME | SIGNATURE | DATE | | | | TITLE: Gearbox 25:1 - GA

DRAWN | | | 2026-11-04
CHK'D
APPV'D
MFG
Q.A | | | | MATERIAL: | DWG NO. PG25-000 | A2

SOLIDWORKS Educational Product. For Instructional Use Only.
