alanarzamendi/planetary-gearbox-25-1/Drawings/PG25-101.pdf

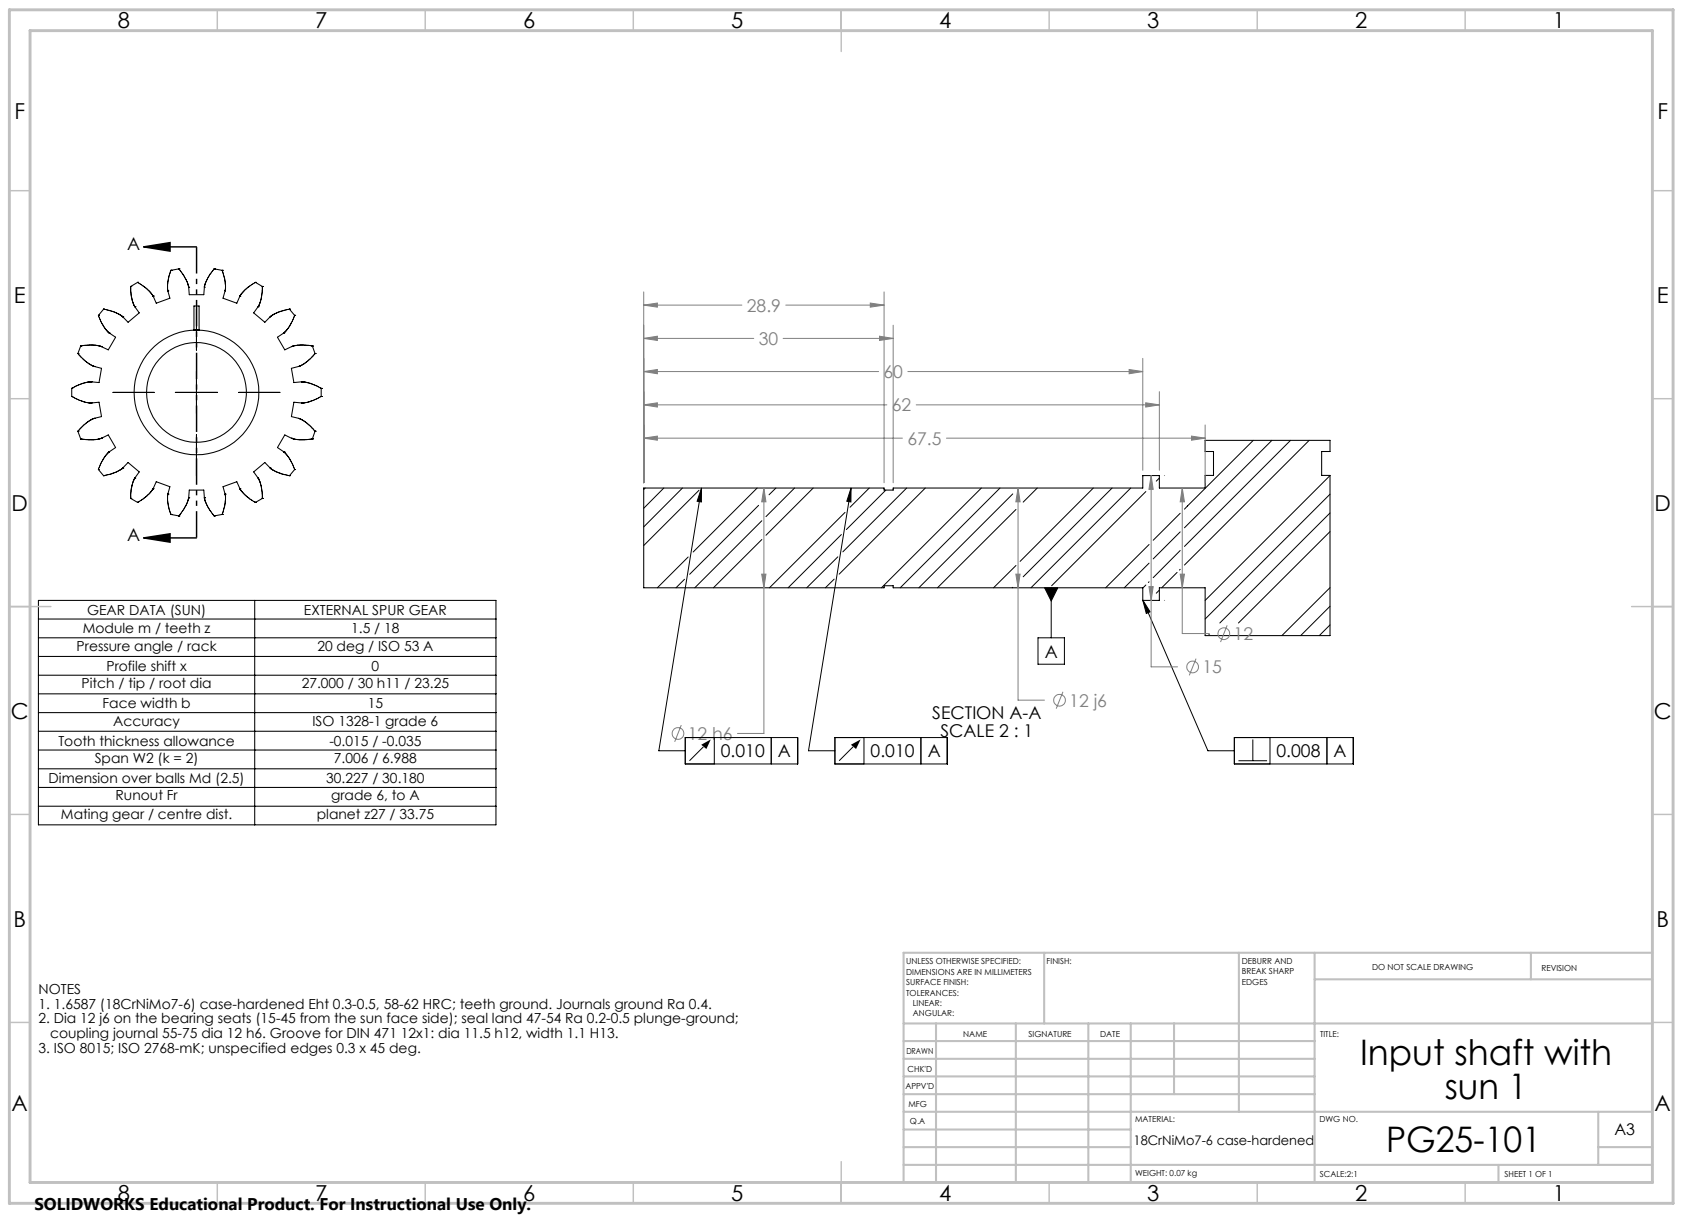
[picture p52: page 1]
SECTION A-A SCALE 2 : 1; FINISH:; DEBURR AND; BREAK SHARP; DO NOT SCALE DRAWING; REVISION; SCALE:2:1; SHEET 1 OF 1; WEIGHT: 0.07 kg

GEAR DATA (SUN) | EXTERNAL SPUR GEAR
Module m / teeth z | 1.5 / 18
Pressure angle / rack | 20 deg / ISO 53 A
Profile shift x | 0
Pitch / tip / root dia | 27.000 / 30 h11 / 23.25
Face width b | 15
Accuracy | ISO 1328-1 grade 6
Tooth thickness allowance | -0.015 / -0.035
Span W2 (k = 2) | 7.006 / 6.988
Dimension over balls Md (2.5) | 30.227 / 30.180
Mating gear / centre dist. | planet z27 / 33.75

Runout Fr | grade 6, to A

UNLESS OTHERWISE SPECIFIED:
DIMENSIONS ARE IN MILLIMETERS
SURFACE FINISH:
TOLERANCES:
LINEAR:
ANGULAR:

NOTES
1. 1.6587 (18CrNiMo7-6) case-hardened Eht 0.3-0.5, 58-62 HRC; teeth ground. Journals ground Ra 0.4.
2. Dia 12 j6 on the bearing seats (15-45 from the sun face side); seal land 47-54 Ra 0.2-0.5 plunge-ground;
coupling journal 55-75 dia 12 h6. Groove for DIN 471 12x1: dia 11.5 h12, width 1.1 H13.
3. ISO 8015; ISO 2768-mK; unspecified edges 0.3 x 45 deg.

NAME | SIGNATURE | DATE | | | | TITLE: Input shaft with sun 1

DRAWN
CHK'D
APPV'D
MFG
Q.A | | | | MATERIAL: | DWG NO. PG25-101 | A3 18CrNiMo7-6 case-hardened

SOLIDWORKS Educational Product. For Instructional Use Only.
