alanarzamendi/planetary-gearbox-25-1/Drawings/PG25-201_302.pdf

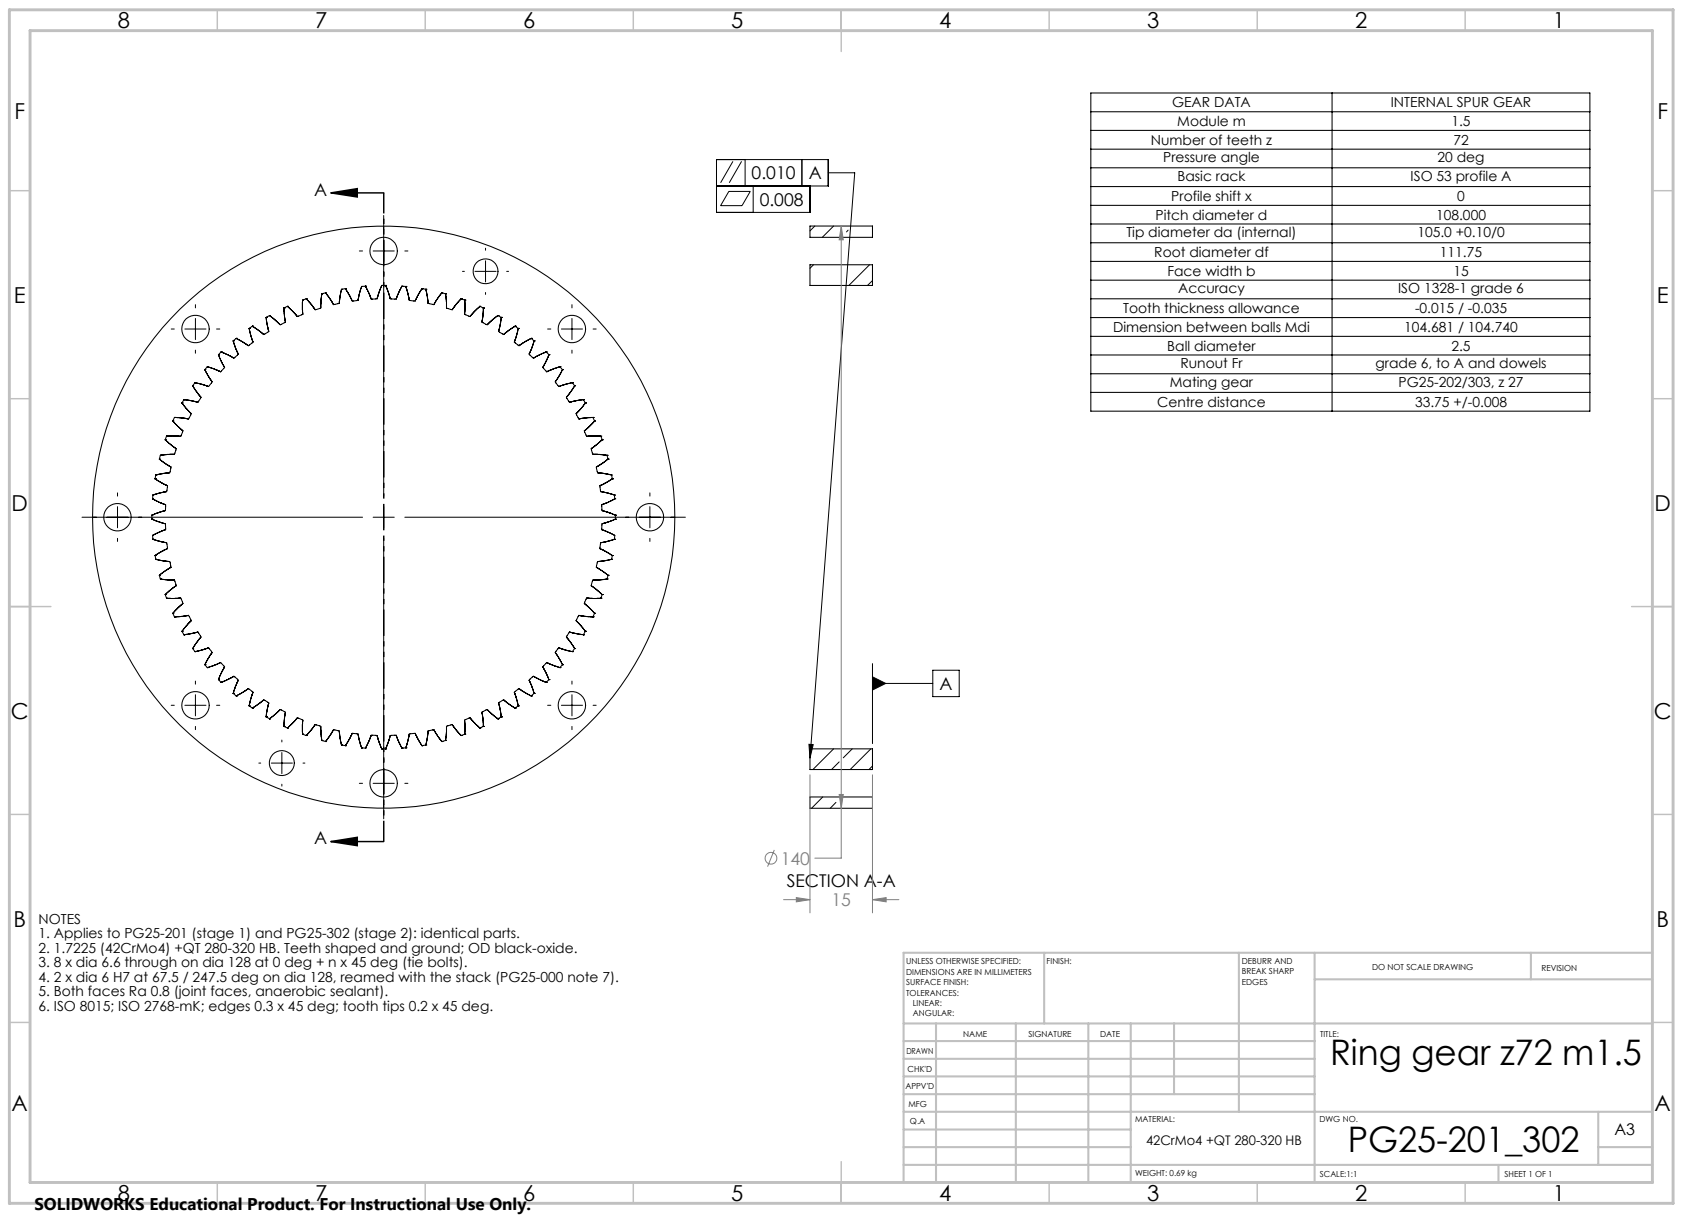
[picture p53: page 1]
SECTION A-A; Profile shift x; FINISH:; DEBURR AND; BREAK SHARP; DO NOT SCALE DRAWING; REVISION; SCALE:1:1; SHEET 1 OF 1; WEIGHT: 0.69 kg

GEAR DATA | INTERNAL SPUR GEAR
Module m | 1.5
Number of teeth z | 72
Pressure angle | 20 deg
Basic rack | ISO 53 profile A

Pitch diameter d | 108.000
Tip diameter da (internal) | 105.0 +0.10/0
Root diameter df | 111.75
Face width b | 15
Accuracy | ISO 1328-1 grade 6
Tooth thickness allowance | -0.015 / -0.035
Dimension between balls Mdi | 104.681 / 104.740
Ball diameter | 2.5
Runout Fr | grade 6, to A and dowels
Mating gear | PG25-202/303, z 27
Centre distance | 33.75 +/-0.008

NOTES
1. Applies to PG25-201 (stage 1) and PG25-302 (stage 2): identical parts.
2. 1.7225 (42CrMo4) +QT 280-320 HB. Teeth shaped and ground; OD black-oxide.
3. 8 x dia 6.6 through on dia 128 at 0 deg + n x 45 deg (tie bolts).
4. 2 x dia 6 H7 at 67.5 / 247.5 deg on dia 128, reamed with the stack (PG25-000 note 7).
5. Both faces Ra 0.8 (joint faces, anaerobic sealant).
6. ISO 8015; ISO 2768-mK; edges 0.3 x 45 deg; tooth tips 0.2 x 45 deg.

UNLESS OTHERWISE SPECIFIED:
DIMENSIONS ARE IN MILLIMETERS
SURFACE FINISH:
TOLERANCES:
LINEAR:
ANGULAR:

NAME | SIGNATURE | DATE | | | | TITLE: Ring gear z72 m1.5

DRAWN
CHK'D
APPV'D
MFG
Q.A | | | | MATERIAL: | DWG NO. PG25-201_302 | A3 42CrMo4 +QT 280-320 HB

SOLIDWORKS Educational Product. For Instructional Use Only.
