alanarzamendi/planetary-gearbox-25-1/Drawings/PG25-202_303.pdf

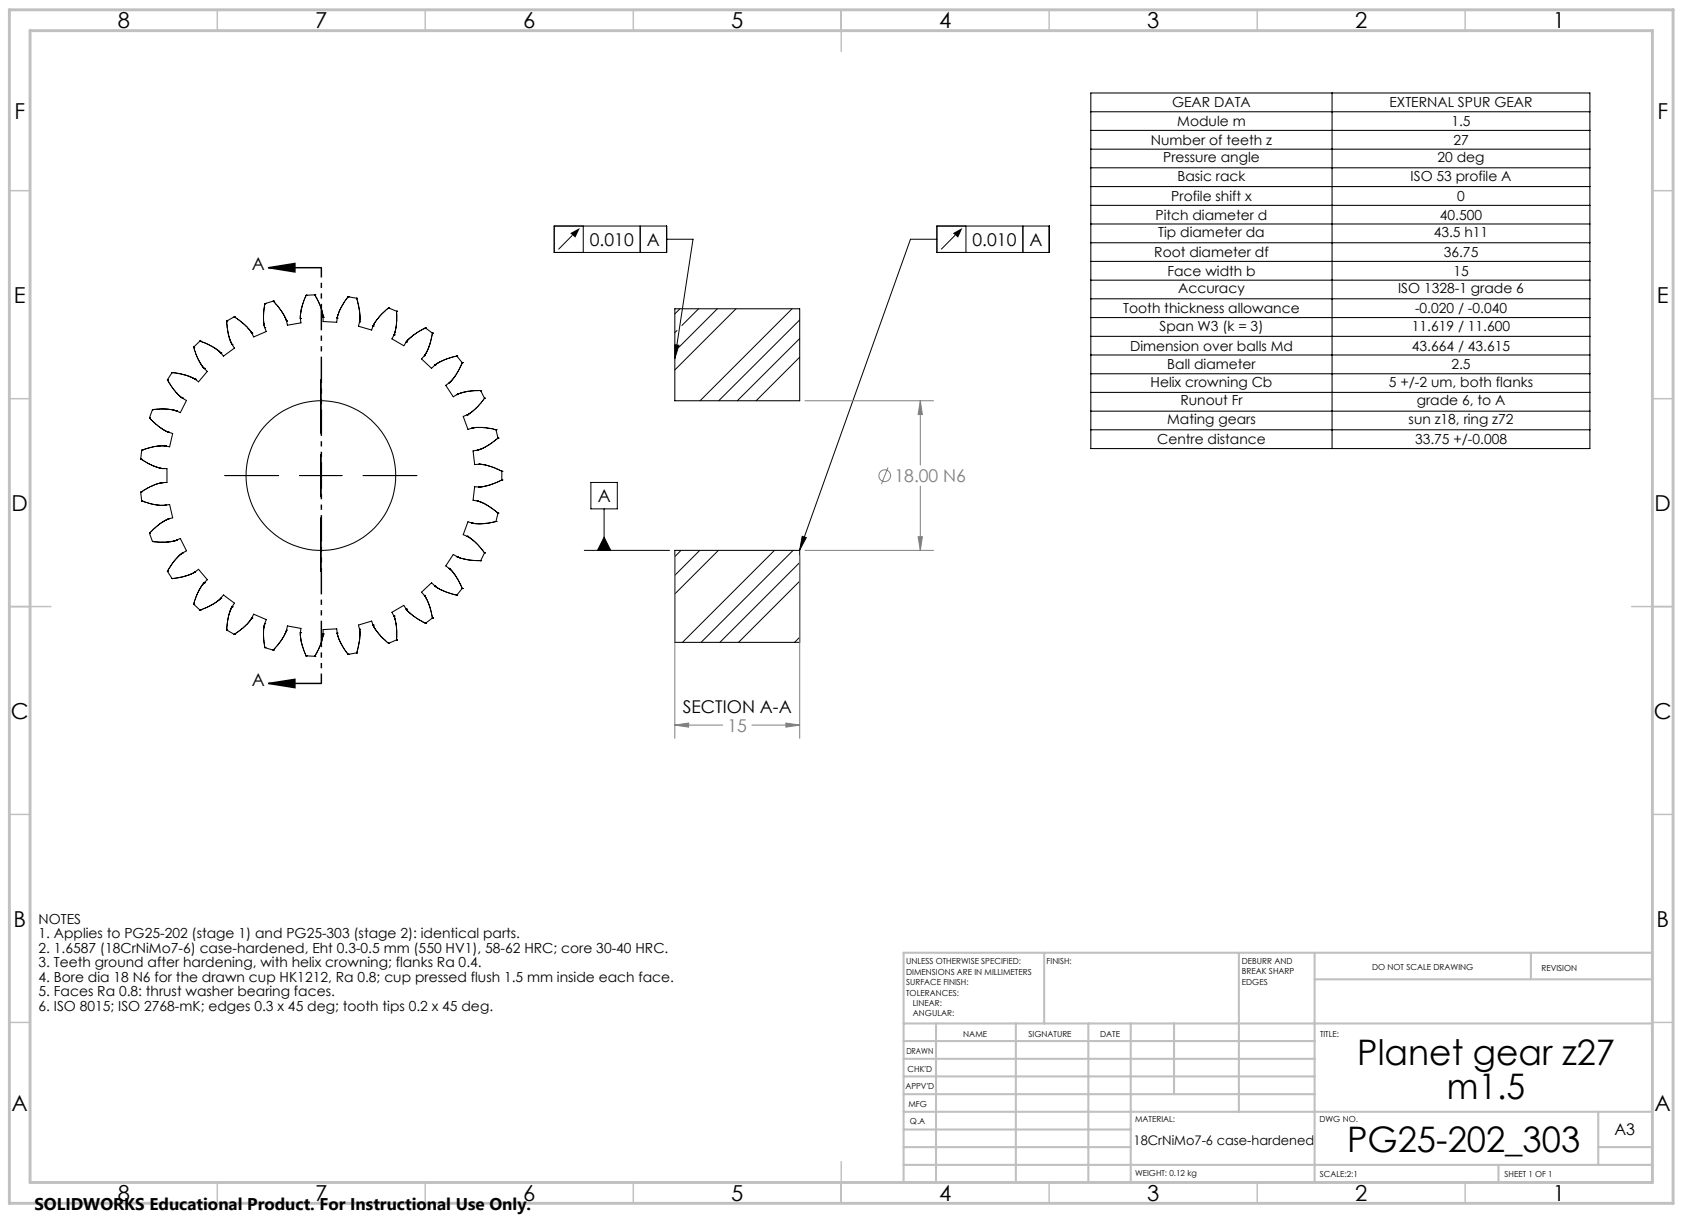
[picture p54: page 1]
SECTION A-A; Profile shift x; FINISH:; DEBURR AND; BREAK SHARP; DO NOT SCALE DRAWING; REVISION; SCALE:2:1; SHEET 1 OF 1; WEIGHT: 0.12 kg

GEAR DATA | EXTERNAL SPUR GEAR
Module m | 1.5
Number of teeth z | 27
Pressure angle | 20 deg
Basic rack | ISO 53 profile A

Pitch diameter d | 40.500
Tip diameter da | 43.5 h11
Root diameter df | 36.75
Face width b | 15
Accuracy | ISO 1328-1 grade 6
Tooth thickness allowance | -0.020 / -0.040
Span W3 (k = 3) | 11.619 / 11.600
Dimension over balls Md | 43.664 / 43.615
Ball diameter | 2.5
Helix crowning Cb | 5 +/-2 um, both flanks
Runout Fr | grade 6, to A
Mating gears | sun z18, ring z72
Centre distance | 33.75 +/-0.008

NOTES
1. Applies to PG25-202 (stage 1) and PG25-303 (stage 2): identical parts.
2. 1.6587 (18CrNiMo7-6) case-hardened, Eht 0.3-0.5 mm (550 HV1), 58-62 HRC; core 30-40 HRC.
3. Teeth ground after hardening, with helix crowning; flanks Ra 0.4.
4. Bore dia 18 N6 for the drawn cup HK1212, Ra 0.8; cup pressed flush 1.5 mm inside each face.
5. Faces Ra 0.8: thrust washer bearing faces.
6. ISO 8015; ISO 2768-mK; edges 0.3 x 45 deg; tooth tips 0.2 x 45 deg.

UNLESS OTHERWISE SPECIFIED:
DIMENSIONS ARE IN MILLIMETERS
SURFACE FINISH:
TOLERANCES:
LINEAR:
ANGULAR:

NAME | SIGNATURE | DATE | | | | TITLE: Planet gear z27 m1.5

DRAWN
CHK'D
APPV'D
MFG
Q.A | | | | MATERIAL: | DWG NO. PG25-202_303 | A3 18CrNiMo7-6 case-hardened

SOLIDWORKS Educational Product. For Instructional Use Only.
