alanarzamendi/planetary-gearbox-25-1/Drawings/PG25-203.pdf

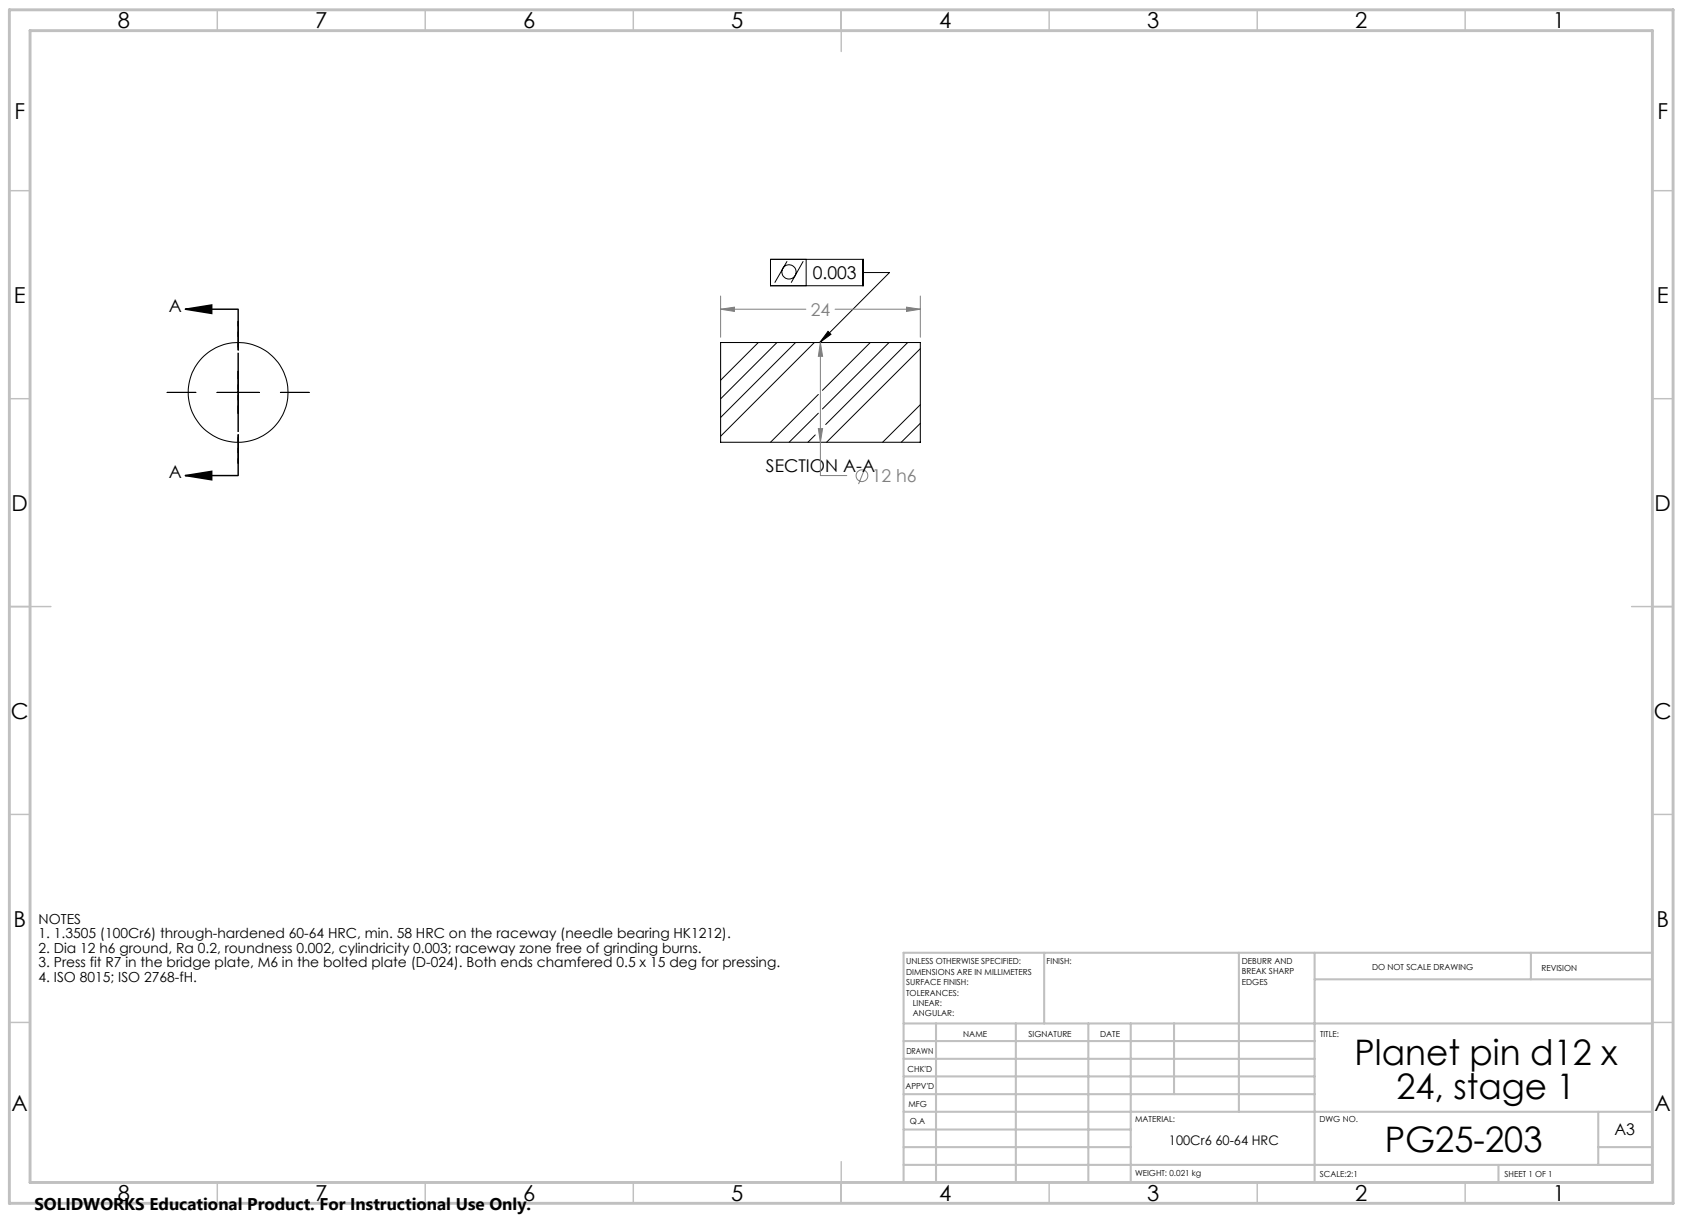
[picture p55: page 1]
SECTION A-A; FINISH:; DEBURR AND; BREAK SHARP; DO NOT SCALE DRAWING; REVISION; SCALE:2:1; SHEET 1 OF 1; WEIGHT: 0.021 kg

NOTES
1. 1.3505 (100Cr6) through-hardened 60-64 HRC, min. 58 HRC on the raceway (needle bearing HK1212).
2. Dia 12 h6 ground, Ra 0.2, roundness 0.002, cylindricity 0.003; raceway zone free of grinding burns.
3. Press fit R7 in the bridge plate, M6 in the bolted plate (D-024). Both ends chamfered 0.5 x 15 deg for pressing.
4. ISO 8015; ISO 2768-fH.

UNLESS OTHERWISE SPECIFIED:
DIMENSIONS ARE IN MILLIMETERS
SURFACE FINISH:
TOLERANCES:
LINEAR:
ANGULAR:

NAME | SIGNATURE | DATE | | | | TITLE: Planet pin d12 x 24, stage 1

DRAWN
CHK'D
APPV'D
MFG
Q.A | | | | MATERIAL: | DWG NO. PG25-203 | A3 100Cr6 60-64 HRC

SOLIDWORKS Educational Product. For Instructional Use Only.
