alanarzamendi/planetary-gearbox-25-1/Drawings/PG25-204.pdf

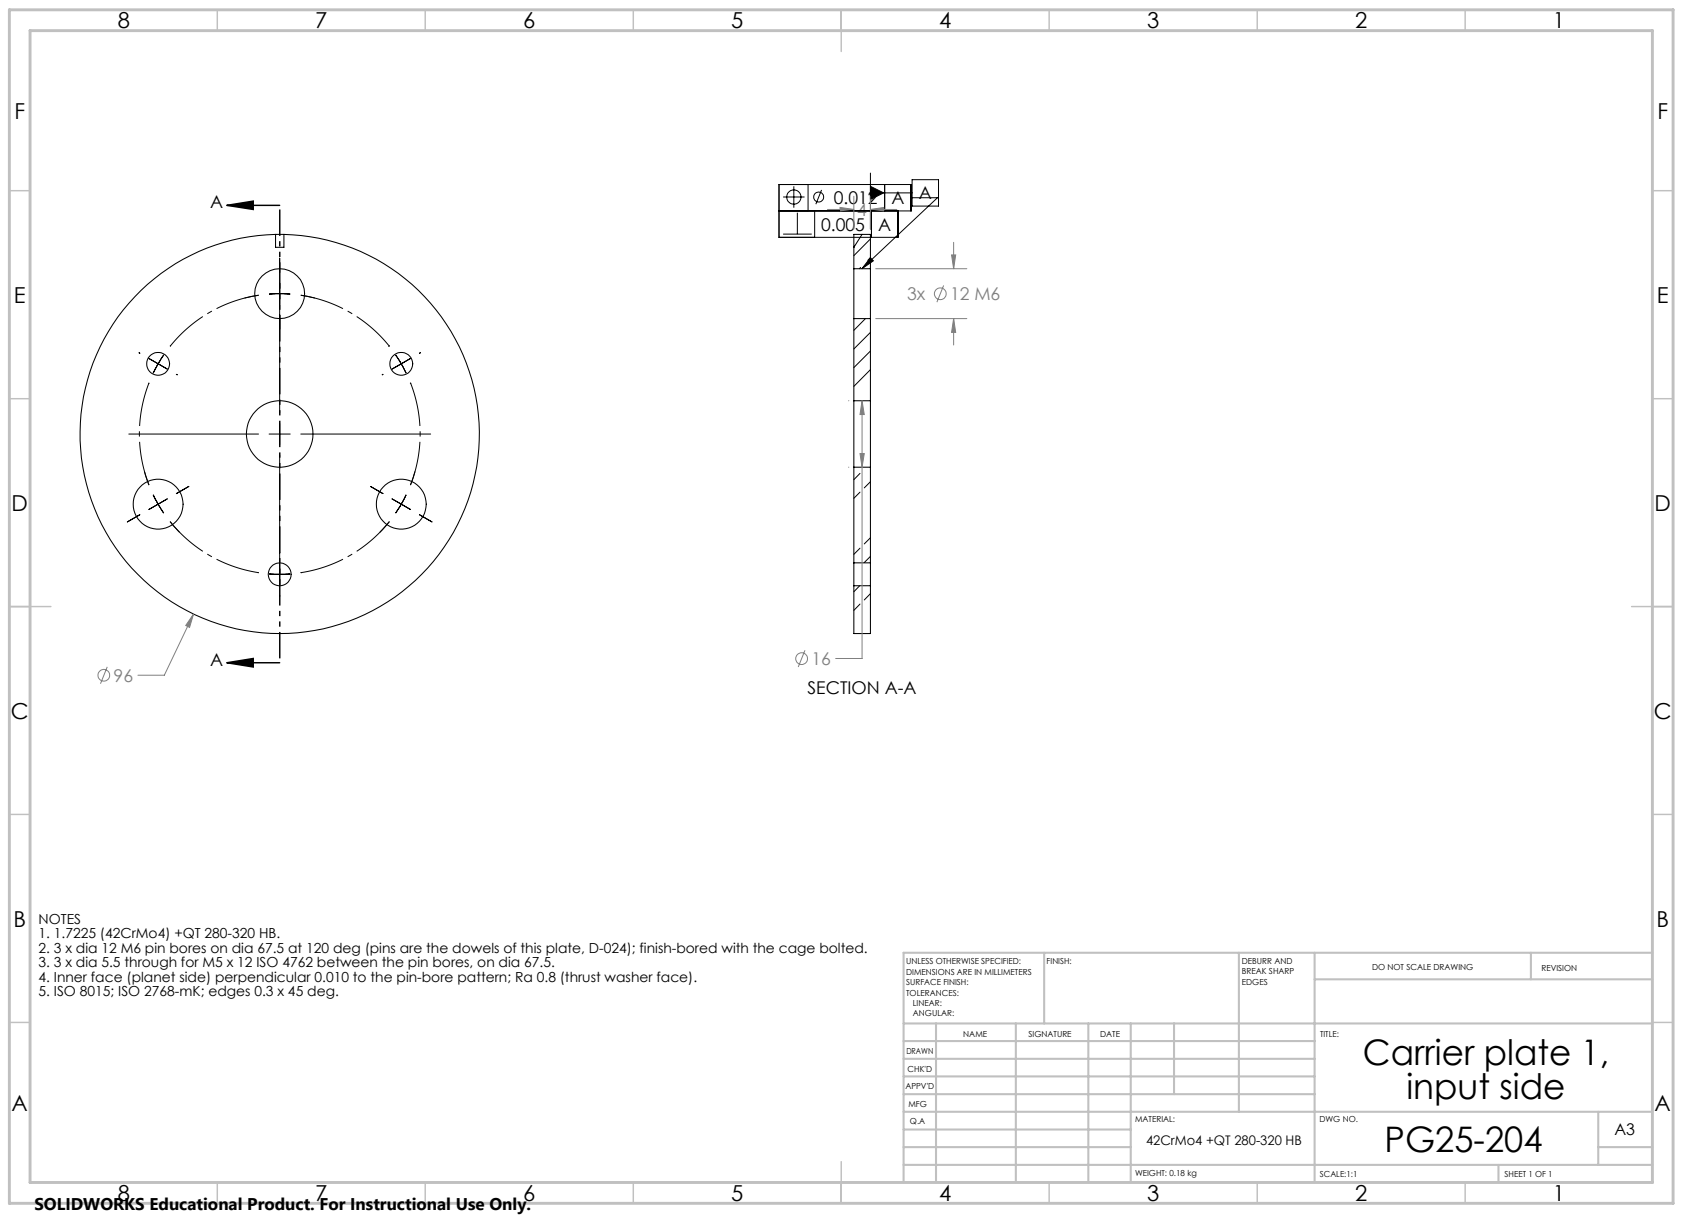
[picture p56: page 1]
SECTION A-A; FINISH:; DEBURR AND; BREAK SHARP; DO NOT SCALE DRAWING; REVISION; SCALE:1:1; SHEET 1 OF 1; WEIGHT: 0.18 kg

NOTES
1. 1.7225 (42CrMo4) +QT 280-320 HB.
2. 3 x dia 12 M6 pin bores on dia 67.5 at 120 deg (pins are the dowels of this plate, D-024); finish-bored with the cage bolted.
3. 3 x dia 5.5 through for M5 x 12 ISO 4762 between the pin bores, on dia 67.5.
4. Inner face (planet side) perpendicular 0.010 to the pin-bore pattern; Ra 0.8 (thrust washer face).
5. ISO 8015; ISO 2768-mK; edges 0.3 x 45 deg.

UNLESS OTHERWISE SPECIFIED:
DIMENSIONS ARE IN MILLIMETERS
SURFACE FINISH:
TOLERANCES:
LINEAR:
ANGULAR:

NAME | SIGNATURE | DATE | | | | TITLE: Carrier plate 1, input side

DRAWN
CHK'D
APPV'D
MFG
Q.A | | | | MATERIAL: | DWG NO. PG25-204 | A3 42CrMo4 +QT 280-320 HB

SOLIDWORKS Educational Product. For Instructional Use Only.
