alanarzamendi/planetary-gearbox-25-1/Drawings/PG25-205.pdf

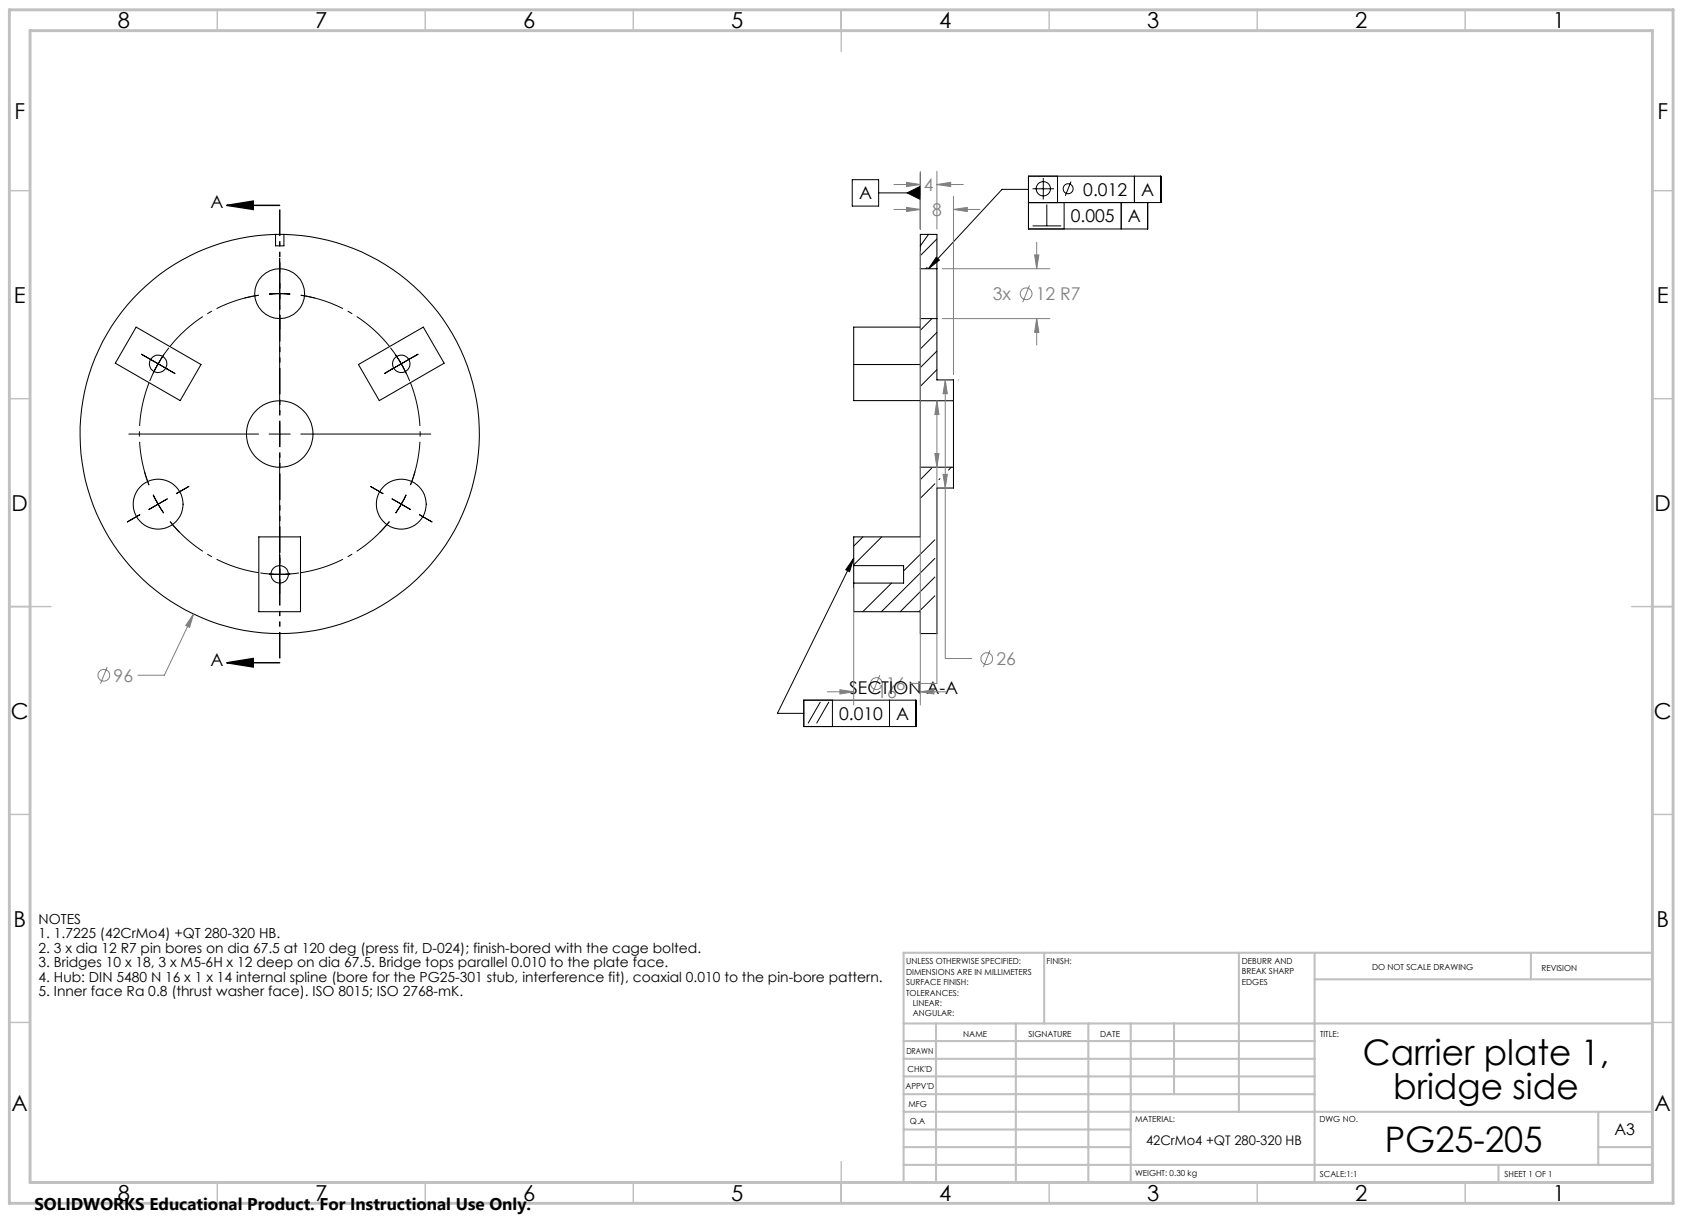
[picture p57: page 1]
16 SECTION A-A; FINISH:; DEBURR AND; BREAK SHARP; DO NOT SCALE DRAWING; REVISION; SCALE:1:1; SHEET 1 OF 1; WEIGHT: 0.30 kg

NOTES
1. 1.7225 (42CrMo4) +QT 280-320 HB.
2. 3 x dia 12 R7 pin bores on dia 67.5 at 120 deg (press fit, D-024); finish-bored with the cage bolted.
3. Bridges 10 x 18, 3 x M5-6H x 12 deep on dia 67.5. Bridge tops parallel 0.010 to the plate face.
4. Hub: DIN 5480 N 16 x 1 x 14 internal spline (bore for the PG25-301 stub, interference fit), coaxial 0.010 to the pin-bore pattern.
5. Inner face Ra 0.8 (thrust washer face). ISO 8015; ISO 2768-mK.

UNLESS OTHERWISE SPECIFIED:
DIMENSIONS ARE IN MILLIMETERS
SURFACE FINISH:
TOLERANCES:
LINEAR:
ANGULAR:

NAME | SIGNATURE | DATE | | | | TITLE: Carrier plate 1, bridge side

DRAWN
CHK'D
APPV'D
MFG
Q.A | | | | MATERIAL: | DWG NO. PG25-205 | A3 42CrMo4 +QT 280-320 HB

SOLIDWORKS Educational Product. For Instructional Use Only.
