alanarzamendi/planetary-gearbox-25-1/Drawings/PG25-206.pdf

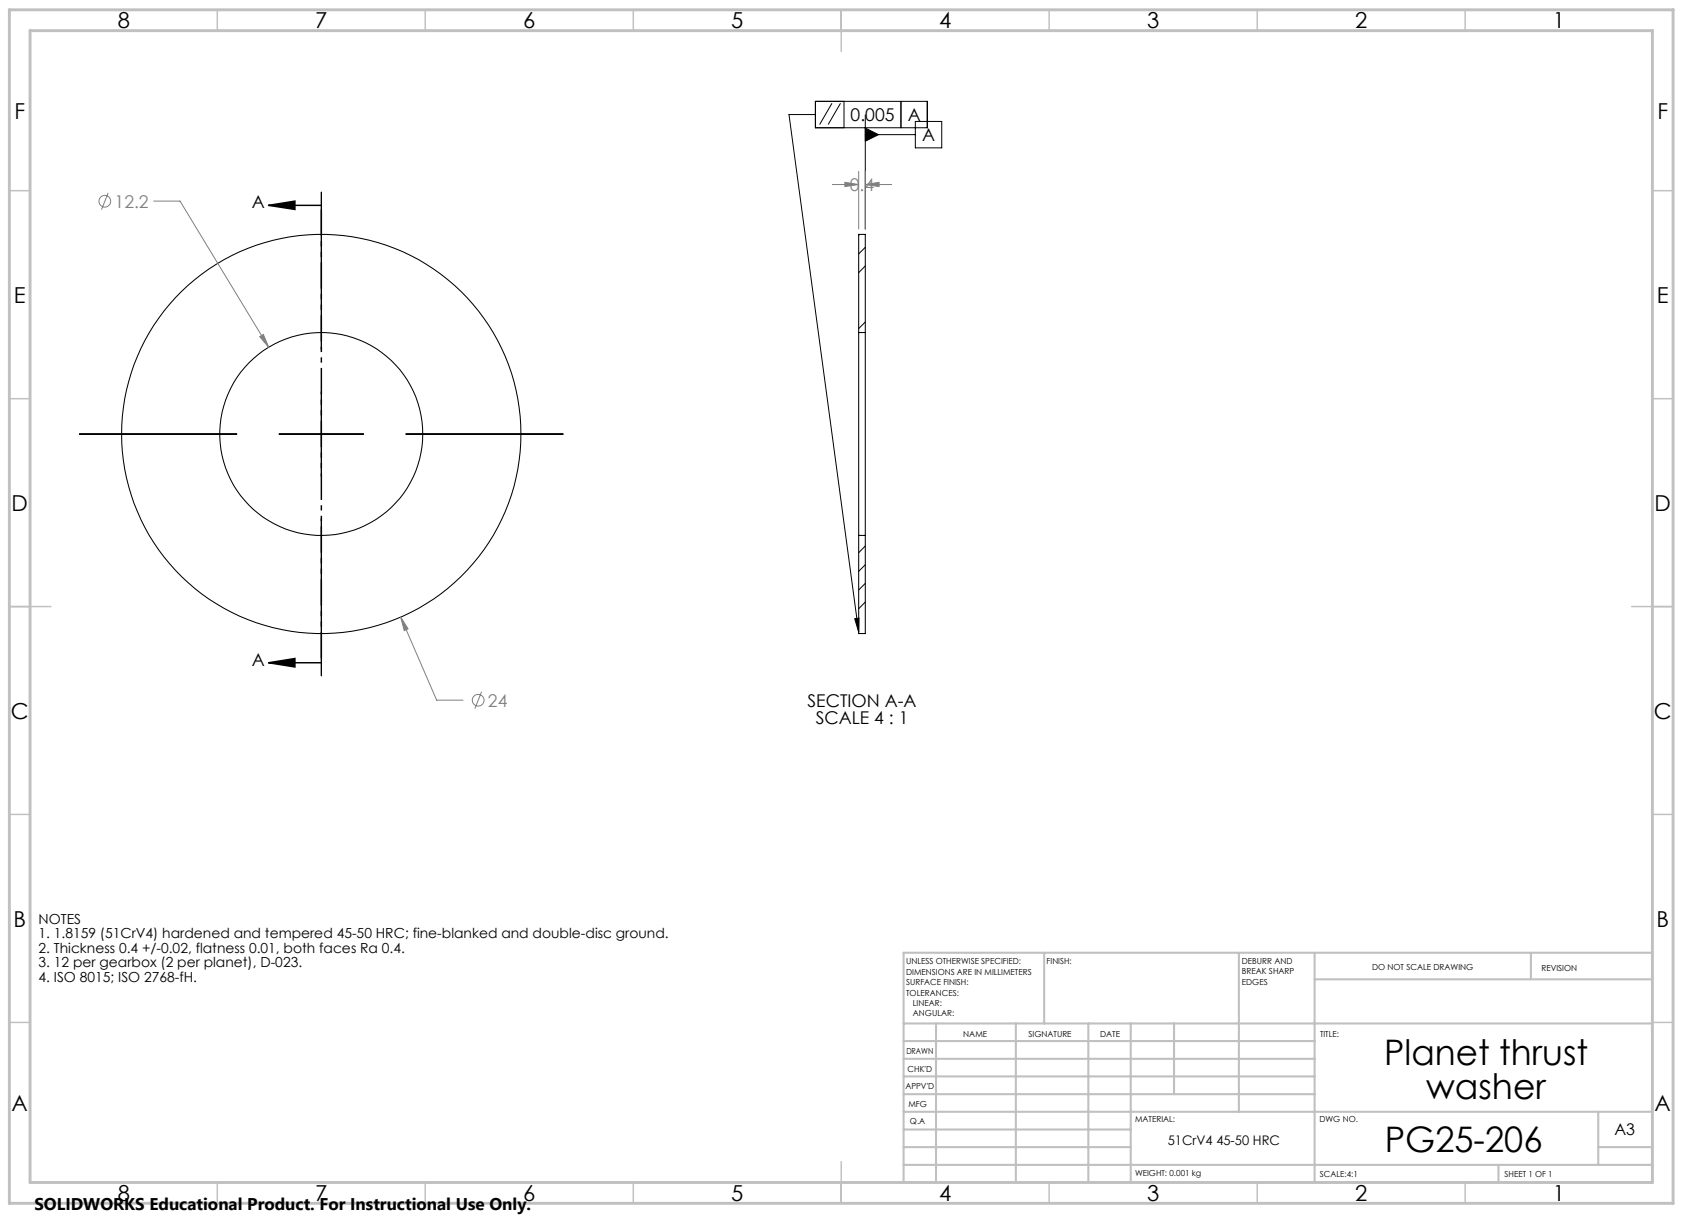
[picture p58: page 1]
SECTION A-A SCALE 4 : 1; FINISH:; DEBURR AND; BREAK SHARP; DO NOT SCALE DRAWING; REVISION; SCALE:4:1; SHEET 1 OF 1; WEIGHT: 0.001 kg

NOTES
1. 1.8159 (51CrV4) hardened and tempered 45-50 HRC; fine-blanked and double-disc ground.
2. Thickness 0.4 +/-0.02, flatness 0.01, both faces Ra 0.4.
3. 12 per gearbox (2 per planet), D-023.
4. ISO 8015; ISO 2768-fH.

UNLESS OTHERWISE SPECIFIED:
DIMENSIONS ARE IN MILLIMETERS
SURFACE FINISH:
TOLERANCES:
LINEAR:
ANGULAR:

NAME | SIGNATURE | DATE | | | | TITLE: Planet thrust washer

DRAWN
CHK'D
APPV'D
MFG
Q.A | | | | MATERIAL: | DWG NO. PG25-206 | A3 51CrV4 45-50 HRC

SOLIDWORKS Educational Product. For Instructional Use Only.
