alanarzamendi/planetary-gearbox-25-1/Drawings/PG25-301.pdf

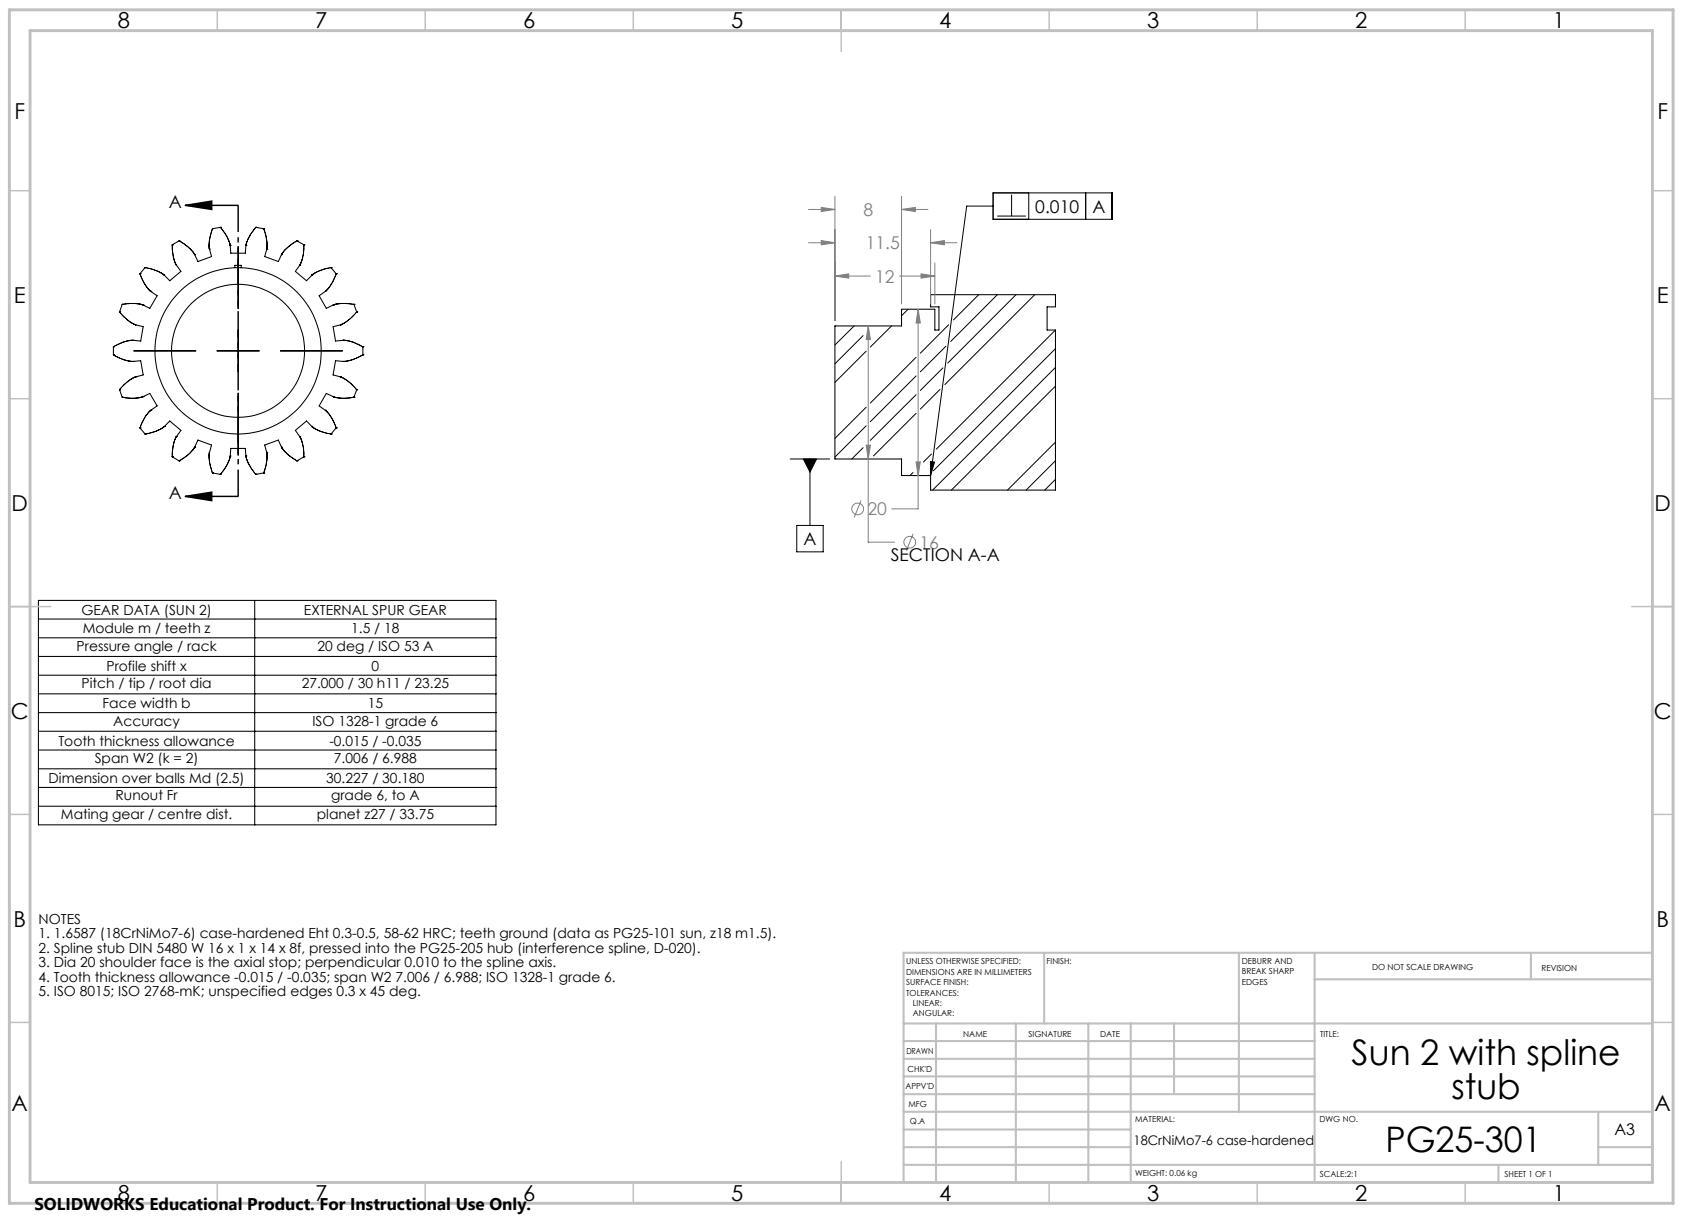
[picture p59: page 1]
SECTION A-A; FINISH:; DEBURR AND; BREAK SHARP; DO NOT SCALE DRAWING; REVISION; SCALE:2:1; SHEET 1 OF 1; WEIGHT: 0.06 kg

GEAR DATA (SUN 2) | EXTERNAL SPUR GEAR
Module m / teeth z | 1.5 / 18
Pressure angle / rack | 20 deg / ISO 53 A
Profile shift x | 0
Pitch / tip / root dia | 27.000 / 30 h11 / 23.25
Face width b | 15
Accuracy | ISO 1328-1 grade 6
Tooth thickness allowance | -0.015 / -0.035
Span W2 (k = 2) | 7.006 / 6.988
Dimension over balls Md (2.5) | 30.227 / 30.180
Mating gear / centre dist. | planet z27 / 33.75

Runout Fr | grade 6, to A

NOTES
1. 1.6587 (18CrNiMo7-6) case-hardened Eht 0.3-0.5, 58-62 HRC; teeth ground (data as PG25-101 sun, z18 m1.5).
2. Spline stub DIN 5480 W 16 x 1 x 14 x 8f, pressed into the PG25-205 hub (interference spline, D-020).
3. Dia 20 shoulder face is the axial stop; perpendicular 0.010 to the spline axis.
4. Tooth thickness allowance -0.015 / -0.035; span W2 7.006 / 6.988; ISO 1328-1 grade 6.
5. ISO 8015; ISO 2768-mK; unspecified edges 0.3 x 45 deg.

UNLESS OTHERWISE SPECIFIED:
DIMENSIONS ARE IN MILLIMETERS
SURFACE FINISH:
TOLERANCES:
LINEAR:
ANGULAR:

NAME | SIGNATURE | DATE | | | | TITLE: Sun 2 with spline stub

DRAWN
CHK'D
APPV'D
MFG
Q.A | | | | MATERIAL: | DWG NO. PG25-301 | A3 18CrNiMo7-6 case-hardened

SOLIDWORKS Educational Product. For Instructional Use Only.
