alanarzamendi/planetary-gearbox-25-1/Drawings/PG25-305.pdf

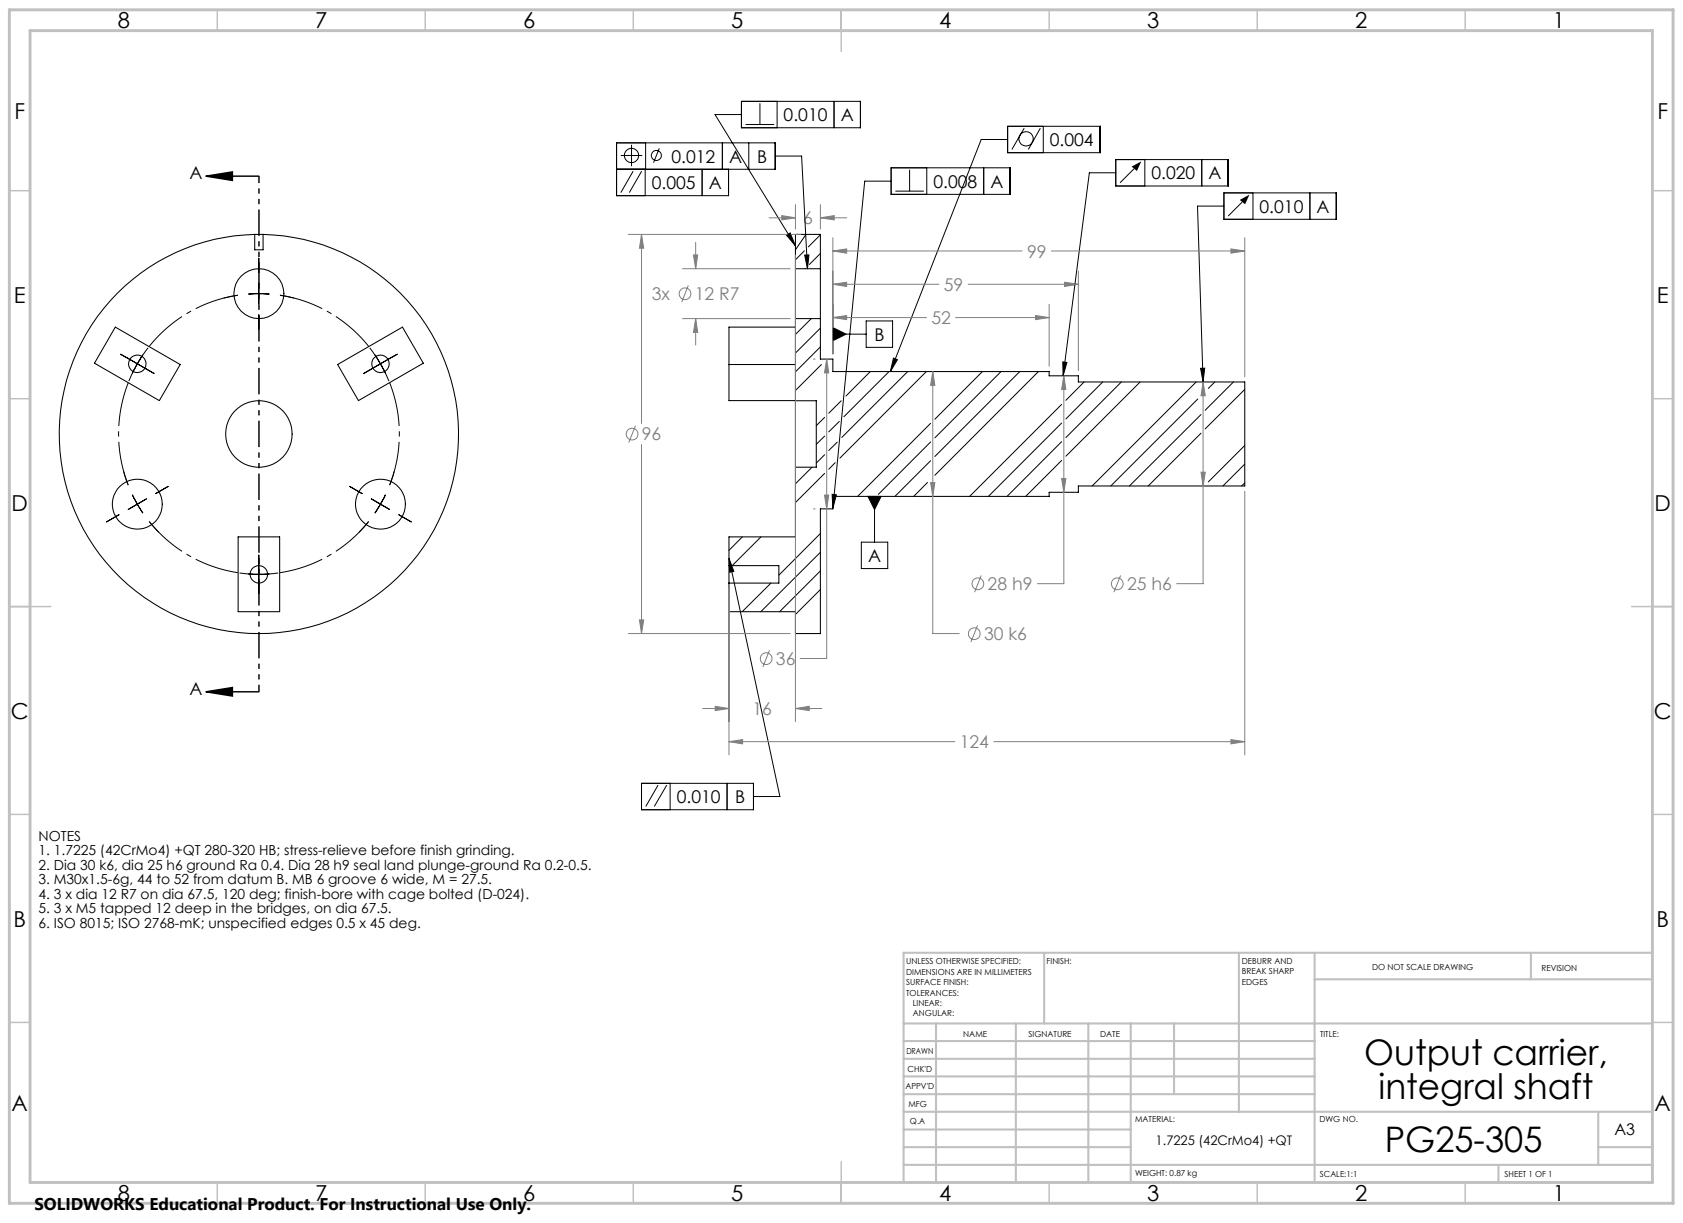
[picture p60: page 1]
FINISH:; DEBURR AND; BREAK SHARP; DO NOT SCALE DRAWING; REVISION; SCALE:1:1; SHEET 1 OF 1; WEIGHT: 0.87 kg

NOTES
1. 1.7225 (42CrMo4) +QT 280-320 HB; stress-relieve before finish grinding.
2. Dia 30 k6, dia 25 h6 ground Ra 0.4. Dia 28 h9 seal land plunge-ground Ra 0.2-0.5.
3. M30x1.5-6g, 44 to 52 from datum B. MB 6 groove 6 wide, M = 27.5.
4. 3 x dia 12 R7 on dia 67.5, 120 deg; finish-bore with cage bolted (D-024).
5. 3 x M5 tapped 12 deep in the bridges, on dia 67.5.
6. ISO 8015; ISO 2768-mK; unspecified edges 0.5 x 45 deg.

UNLESS OTHERWISE SPECIFIED:
DIMENSIONS ARE IN MILLIMETERS
SURFACE FINISH:
TOLERANCES:
LINEAR:
ANGULAR:

NAME | SIGNATURE | DATE | | | | TITLE: Output carrier, integral shaft

DRAWN
CHK'D
APPV'D
MFG
Q.A | | | | MATERIAL: | DWG NO. PG25-305 | A3 1.7225 (42CrMo4) +QT

SOLIDWORKS Educational Product. For Instructional Use Only.
