alanarzamendi/planetary-gearbox-25-1/Drawings/PG25-306.pdf

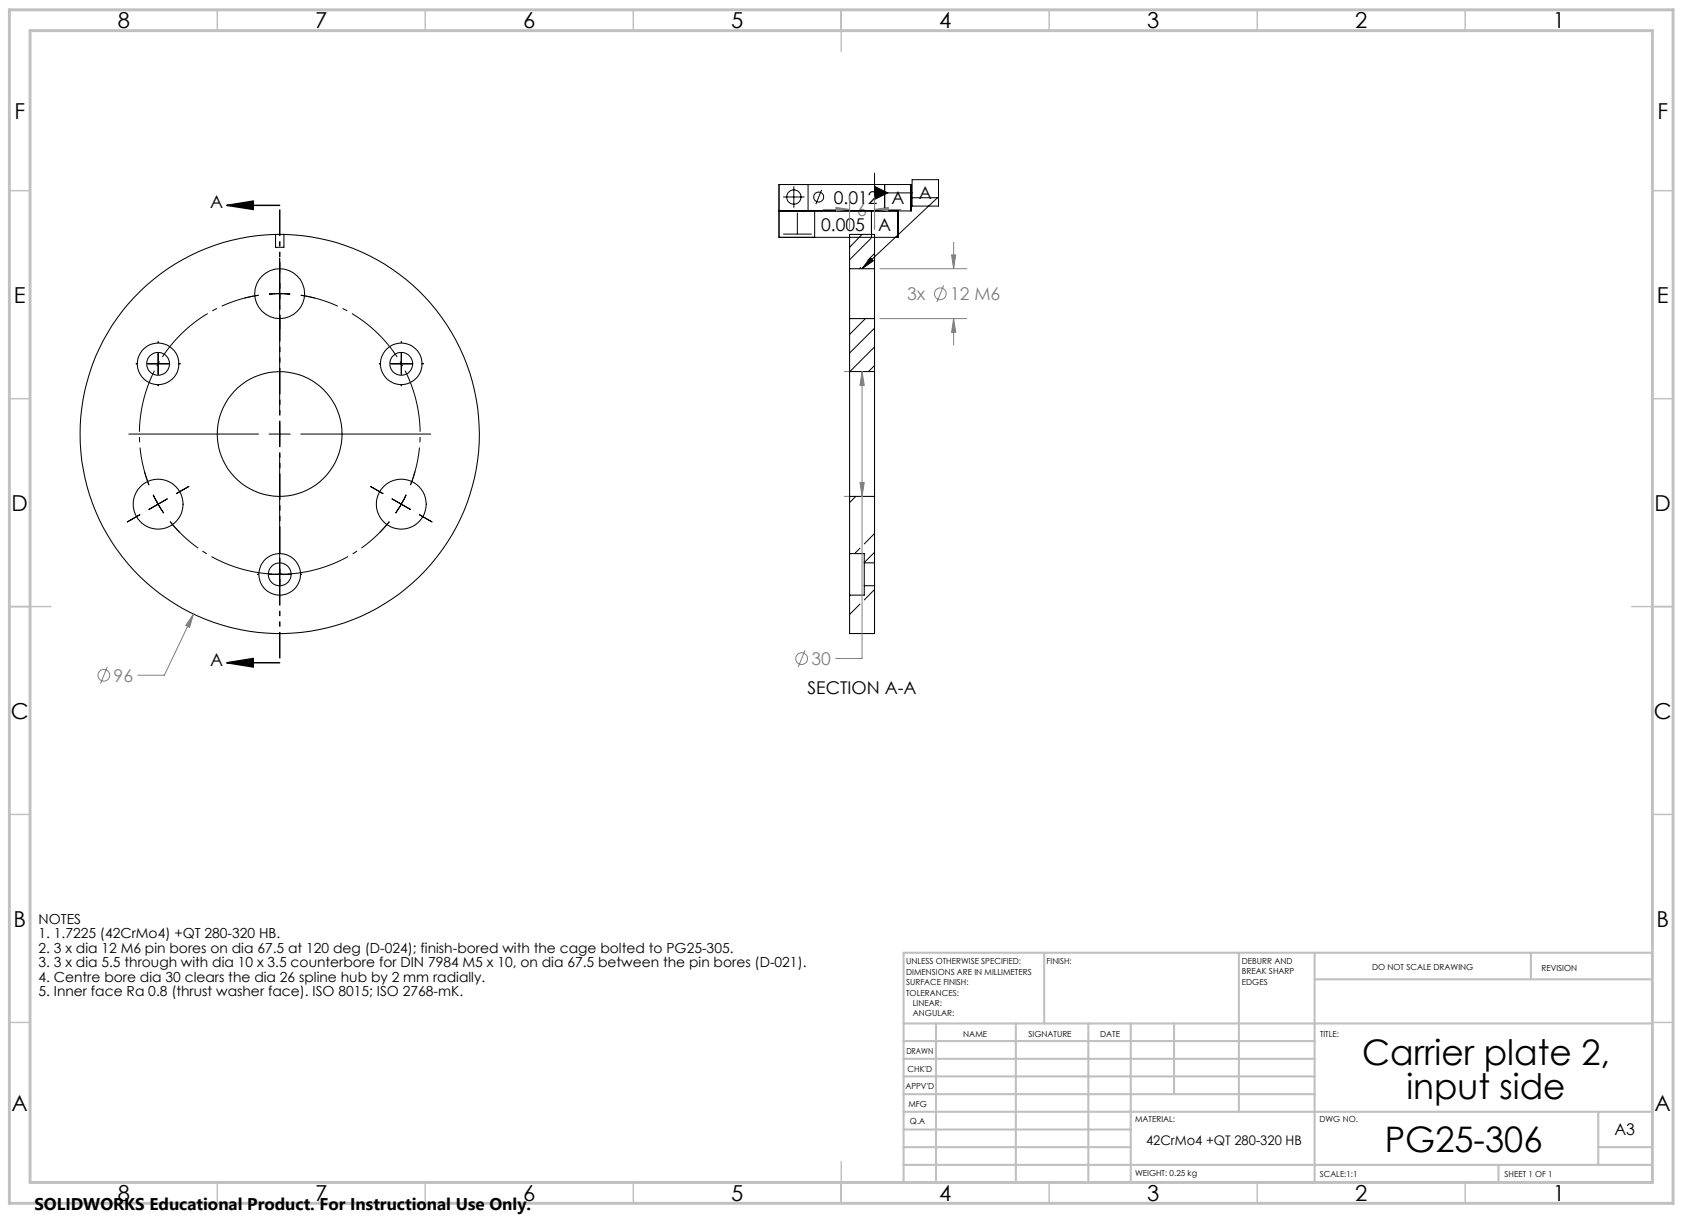
[picture p61: page 1]
SECTION A-A; FINISH:; DEBURR AND; BREAK SHARP; DO NOT SCALE DRAWING; REVISION; SCALE:1:1; SHEET 1 OF 1; WEIGHT: 0.25 kg

NOTES
1. 1.7225 (42CrMo4) +QT 280-320 HB.
2. 3 x dia 12 M6 pin bores on dia 67.5 at 120 deg (D-024); finish-bored with the cage bolted to PG25-305.
3. 3 x dia 5.5 through with dia 10 x 3.5 counterbore for DIN 7984 M5 x 10, on dia 67.5 between the pin bores (D-021).
4. Centre bore dia 30 clears the dia 26 spline hub by 2 mm radially.
5. Inner face Ra 0.8 (thrust washer face). ISO 8015; ISO 2768-mK.

UNLESS OTHERWISE SPECIFIED:
DIMENSIONS ARE IN MILLIMETERS
SURFACE FINISH:
TOLERANCES:
LINEAR:
ANGULAR:

NAME | SIGNATURE | DATE | | | | TITLE: Carrier plate 2, input side

DRAWN
CHK'D
APPV'D
MFG
Q.A | | | | MATERIAL: | DWG NO. PG25-306 | A3 42CrMo4 +QT 280-320 HB

SOLIDWORKS Educational Product. For Instructional Use Only.
