alanarzamendi/planetary-gearbox-25-1/Drawings/PG25-401.pdf

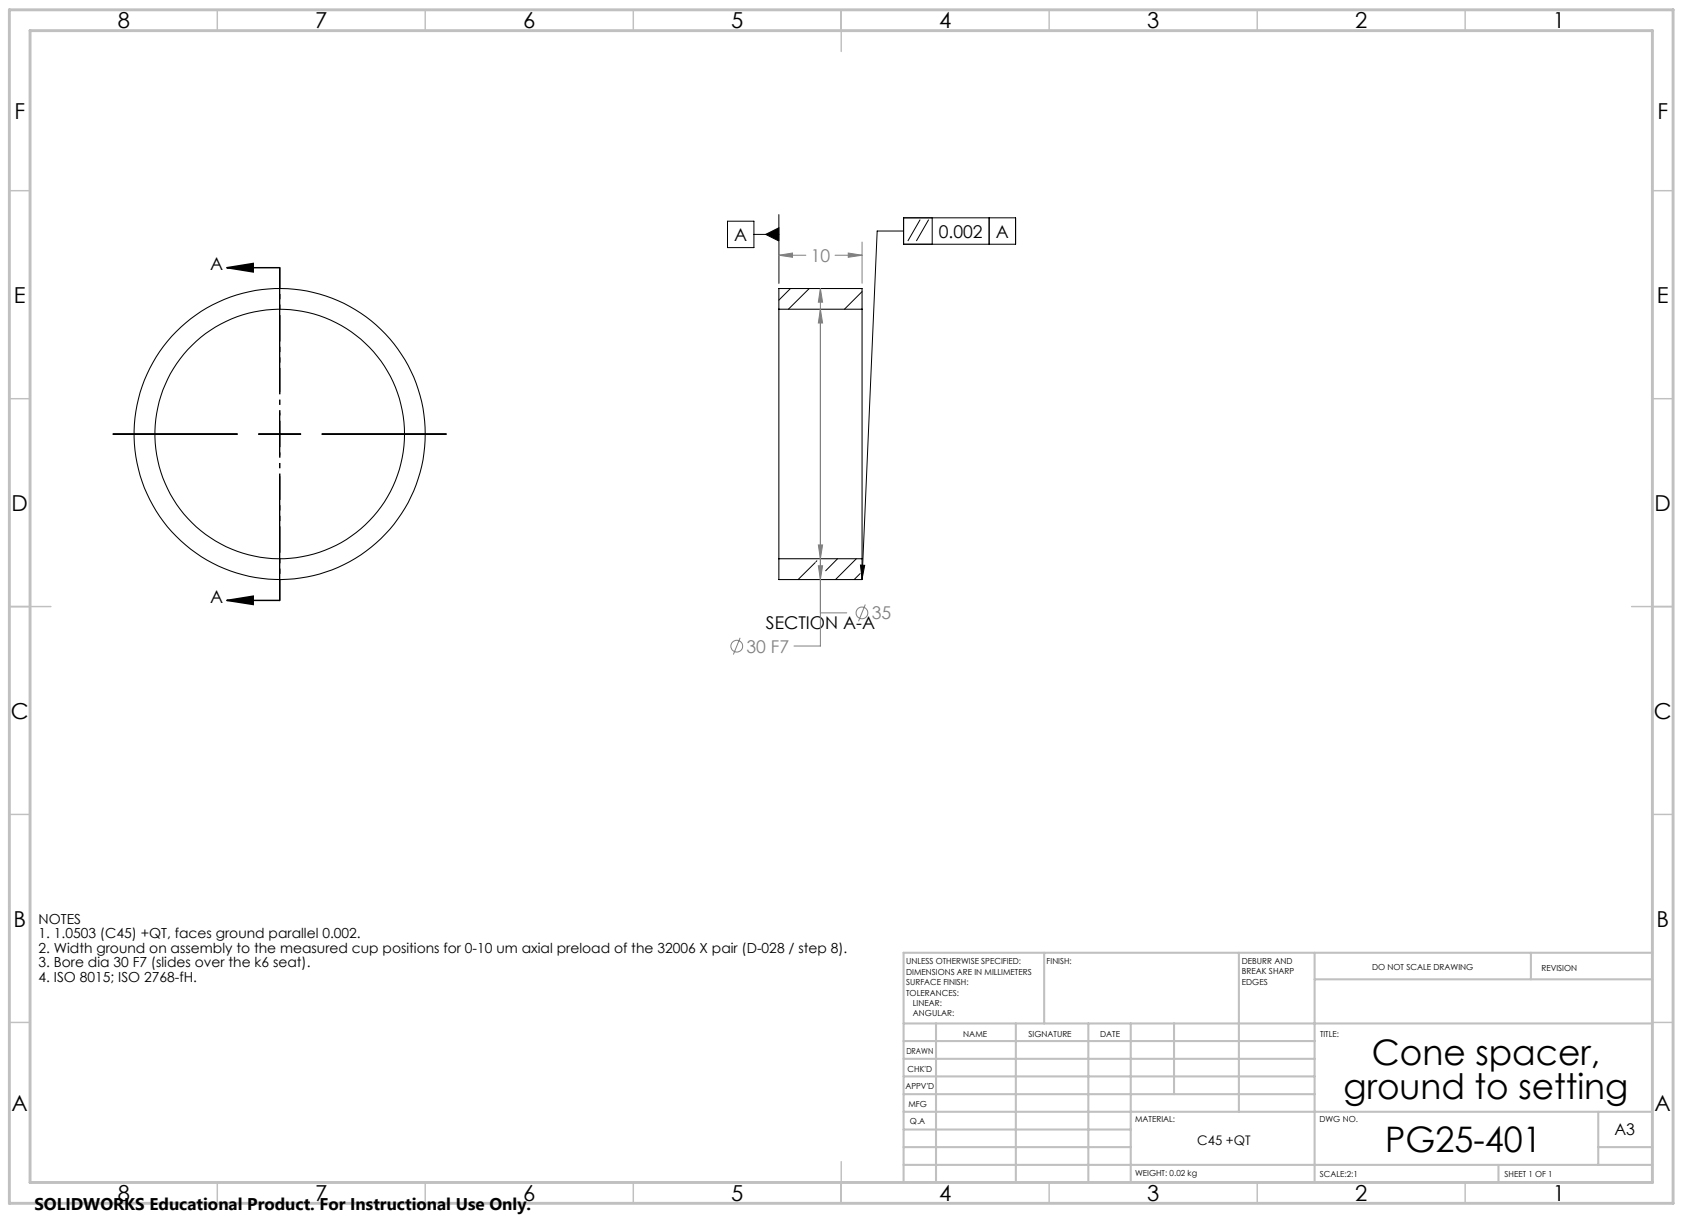
[picture p62: page 1]
SECTION A-A; FINISH:; DEBURR AND; BREAK SHARP; DO NOT SCALE DRAWING; REVISION; SCALE:2:1; SHEET 1 OF 1; WEIGHT: 0.02 kg

NOTES
1. 1.0503 (C45) +QT, faces ground parallel 0.002.
2. Width ground on assembly to the measured cup positions for 0-10 um axial preload of the 32006 X pair (D-028 / step 8).
3. Bore dia 30 F7 (slides over the k6 seat).
4. ISO 8015; ISO 2768-fH.

UNLESS OTHERWISE SPECIFIED:
DIMENSIONS ARE IN MILLIMETERS
SURFACE FINISH:
TOLERANCES:
LINEAR:
ANGULAR:

NAME | SIGNATURE | DATE | | | | TITLE: Cone spacer, ground to setting

DRAWN
CHK'D
APPV'D
MFG
Q.A | | | | MATERIAL: | DWG NO. PG25-401 | A3 C45 +QT

SOLIDWORKS Educational Product. For Instructional Use Only.
