alanarzamendi/planetary-gearbox-25-1/Drawings/PG25-501.pdf

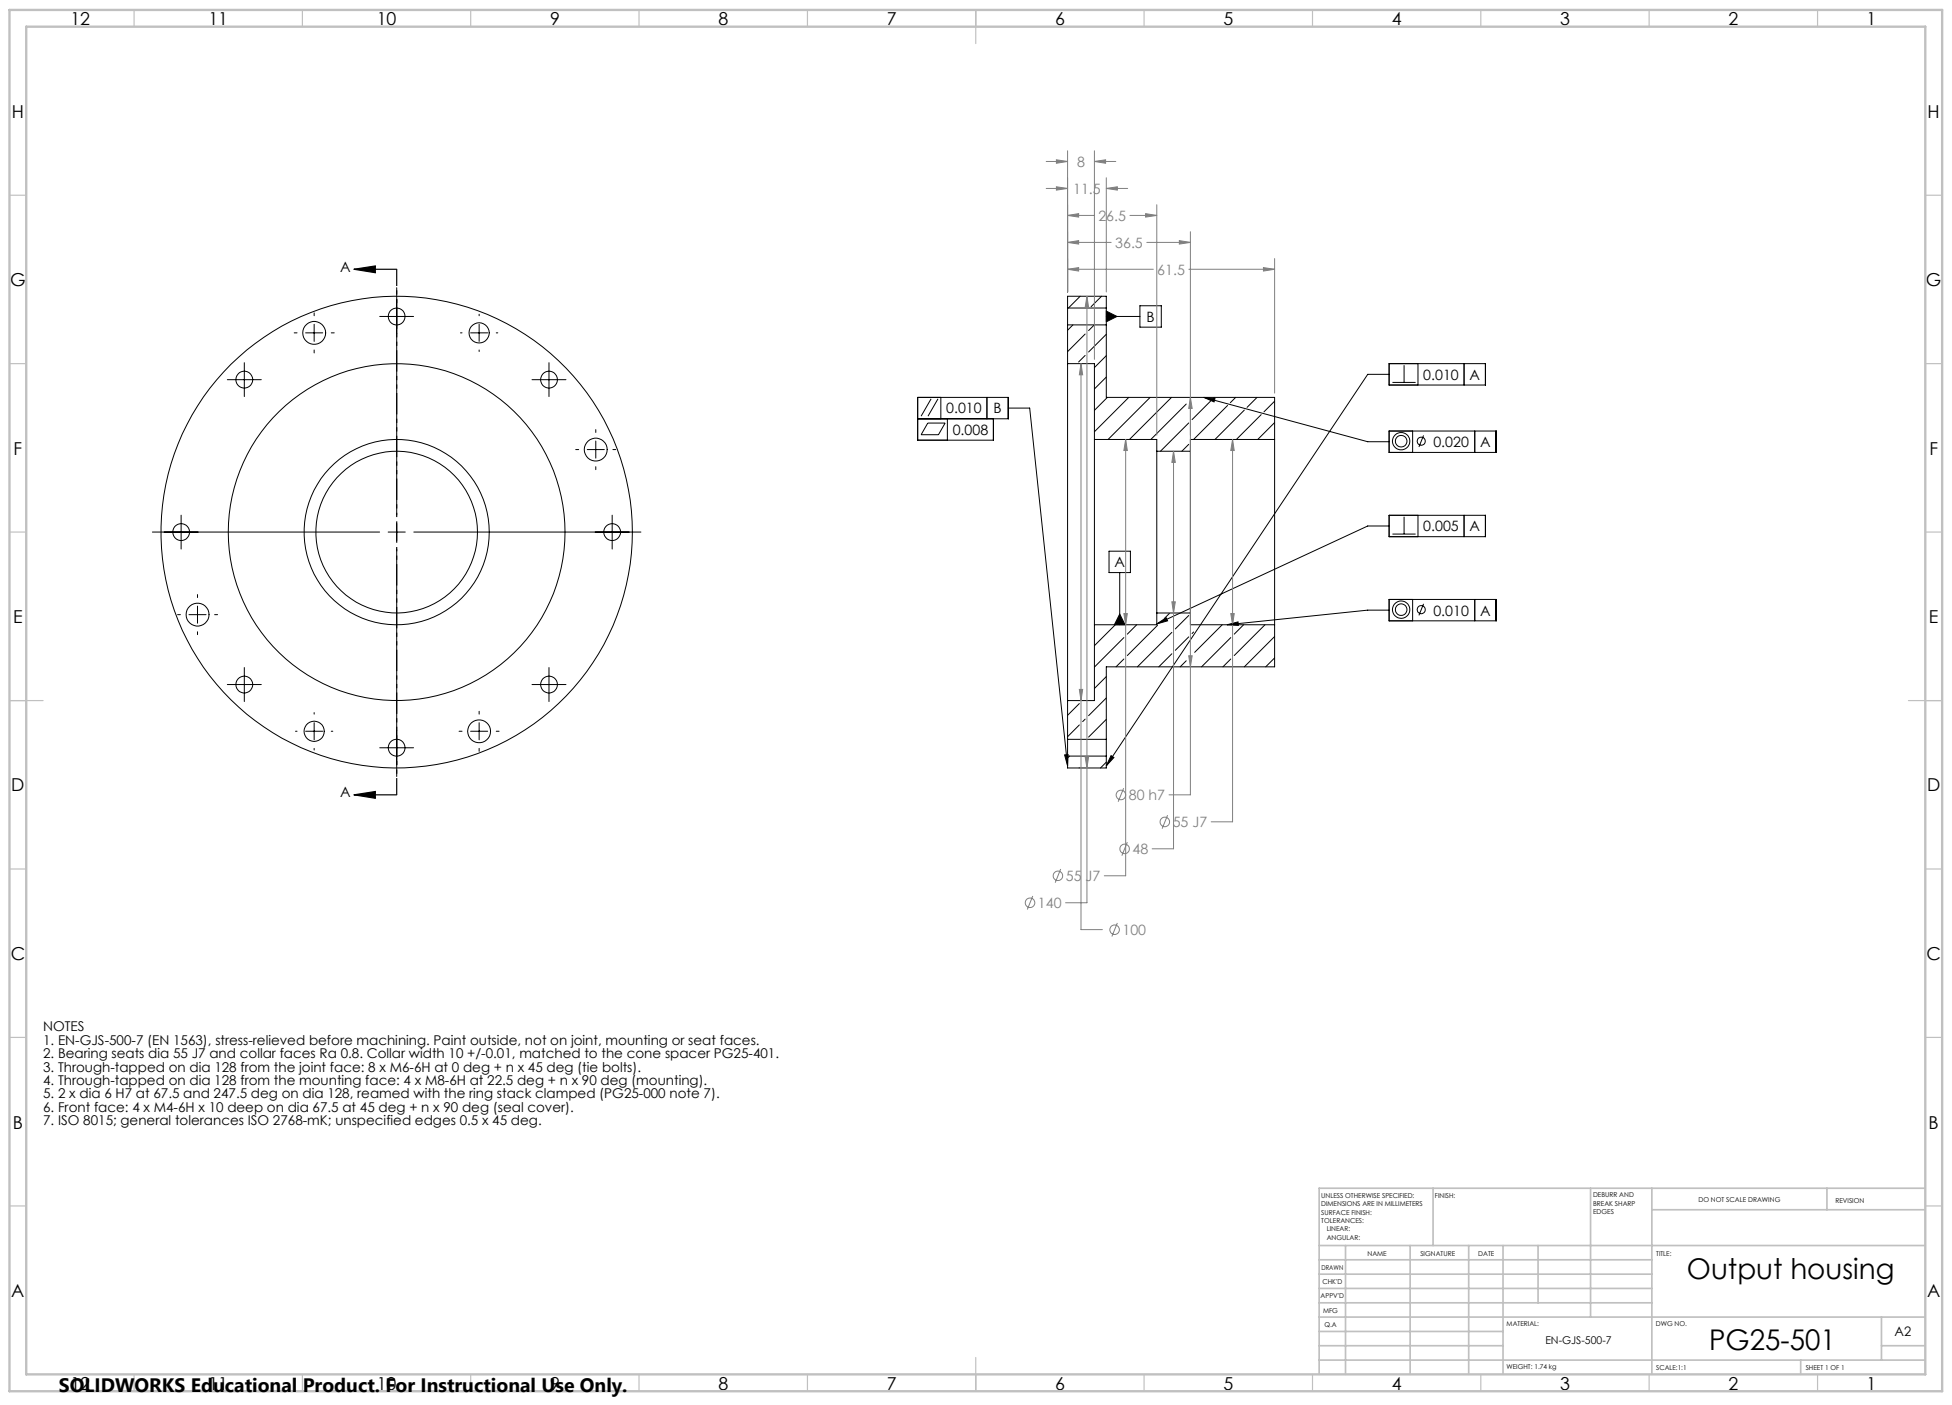
[picture p63: page 1]
SCALE:1:1; SHEET 1 OF 1; WEIGHT: 1.74 kg

NOTES
1. EN-GJS-500-7 (EN 1563), stress-relieved before machining. Paint outside, not on joint, mounting or seat faces.
2. Bearing seats dia 55 J7 and collar faces Ra 0.8. Collar width 10 +/-0.01, matched to the cone spacer PG25-401.
3. Through-tapped on dia 128 from the joint face: 8 x M6-6H at 0 deg + n x 45 deg (tie bolts).
4. Through-tapped on dia 128 from the mounting face: 4 x M8-6H at 22.5 deg + n x 90 deg (mounting).
5. 2 x dia 6 H7 at 67.5 and 247.5 deg on dia 128, reamed with the ring stack clamped (PG25-000 note 7).
6. Front face: 4 x M4-6H x 10 deep on dia 67.5 at 45 deg + n x 90 deg (seal cover).
7. ISO 8015; general tolerances ISO 2768-mK; unspecified edges 0.5 x 45 deg.

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

NAME | SIGNATURE | DATE | | | | TITLE: Output housing

DRAWN
CHK'D
APPV'D
MFG
Q.A | | | | MATERIAL: EN-GJS-500-7 | DWG NO. PG25-501 | A2

SOLIDWORKS Educational Product. For Instructional Use Only.
