alanarzamendi/planetary-gearbox-25-1/Drawings/PG25-502.pdf

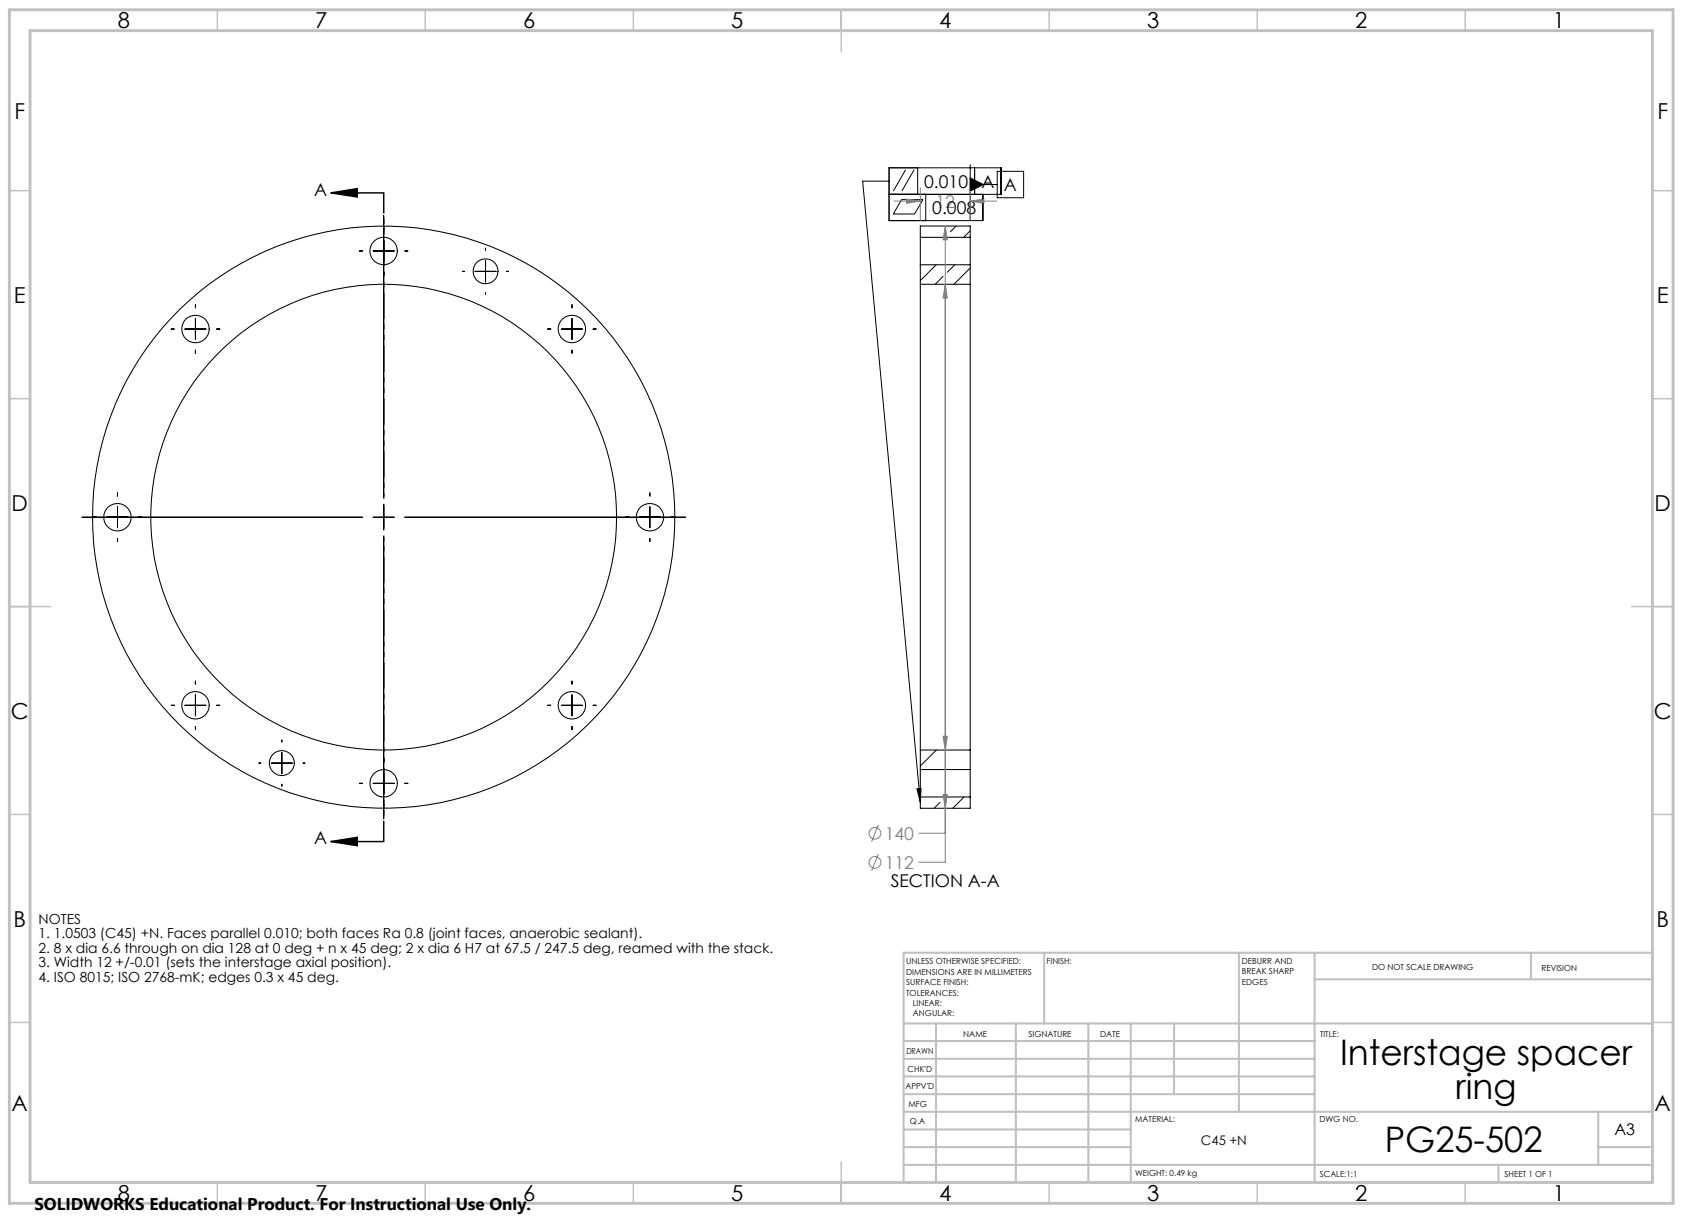
[picture p64: page 1]
SECTION A-A; FINISH:; DEBURR AND; BREAK SHARP; DO NOT SCALE DRAWING; REVISION; SCALE:1:1; SHEET 1 OF 1; WEIGHT: 0.49 kg

NOTES
1. 1.0503 (C45) +N. Faces parallel 0.010; both faces Ra 0.8 (joint faces, anaerobic sealant).
2. 8 x dia 6.6 through on dia 128 at 0 deg + n x 45 deg; 2 x dia 6 H7 at 67.5 / 247.5 deg, reamed with the stack.
3. Width 12 +/-0.01 (sets the interstage axial position).
4. ISO 8015; ISO 2768-mK; edges 0.3 x 45 deg.

UNLESS OTHERWISE SPECIFIED:
DIMENSIONS ARE IN MILLIMETERS
SURFACE FINISH:
TOLERANCES:
LINEAR:
ANGULAR:

NAME | SIGNATURE | DATE | | | | TITLE: Interstage spacer ring

DRAWN
CHK'D
APPV'D
MFG
Q.A | | | | MATERIAL: | DWG NO. PG25-502 | A3 C45 +N

SOLIDWORKS Educational Product. For Instructional Use Only.
