alanarzamendi/planetary-gearbox-25-1/Drawings/PG25-503.pdf

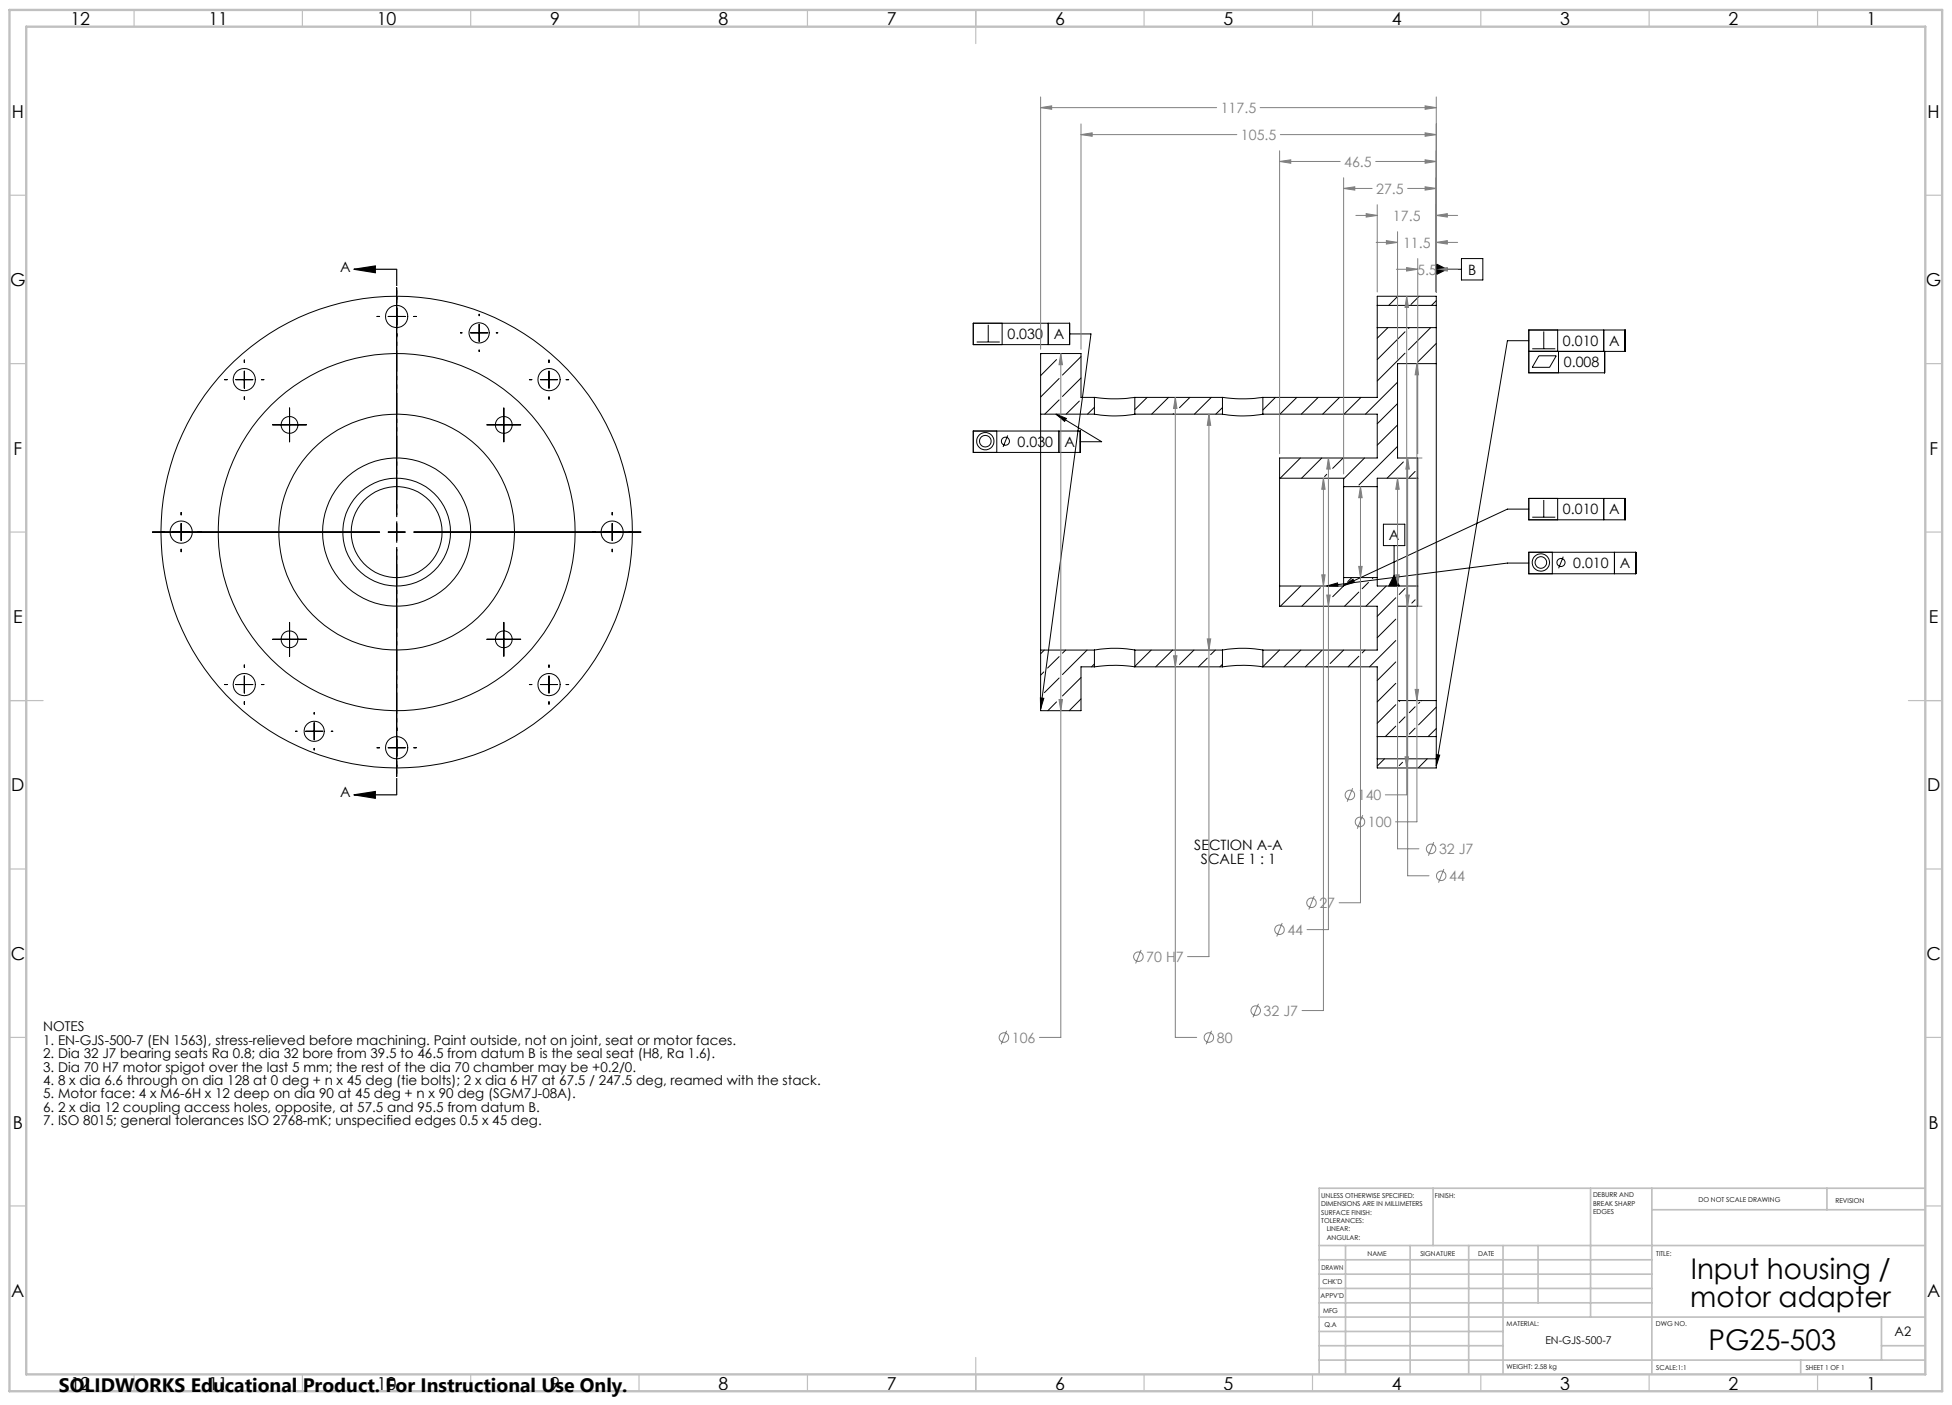
[picture p65: page 1]
SECTION A-A SCALE 1 : 1; SCALE:1:1; SHEET 1 OF 1; WEIGHT: 2.58 kg

NOTES
1. EN-GJS-500-7 (EN 1563), stress-relieved before machining. Paint outside, not on joint, seat or motor faces.
2. Dia 32 J7 bearing seats Ra 0.8; dia 32 bore from 39.5 to 46.5 from datum B is the seal seat (H8, Ra 1.6).
3. Dia 70 H7 motor spigot over the last 5 mm; the rest of the dia 70 chamber may be +0.2/0.
4. 8 x dia 6.6 through on dia 128 at 0 deg + n x 45 deg (tie bolts); 2 x dia 6 H7 at 67.5 / 247.5 deg, reamed with the stack.
5. Motor face: 4 x M6-6H x 12 deep on dia 90 at 45 deg + n x 90 deg (SGM7J-08A).
6. 2 x dia 12 coupling access holes, opposite, at 57.5 and 95.5 from datum B.
7. ISO 8015; general tolerances ISO 2768-mK; unspecified edges 0.5 x 45 deg.

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

NAME | SIGNATURE | DATE | | | | TITLE: Input housing / motor adapter

DRAWN
CHK'D
APPV'D
MFG
Q.A | | | | MATERIAL: EN-GJS-500-7 | DWG NO. PG25-503 | A2

SOLIDWORKS Educational Product. For Instructional Use Only.
