alanarzamendi/planetary-gearbox-25-1/Drawings/PG25-504.pdf

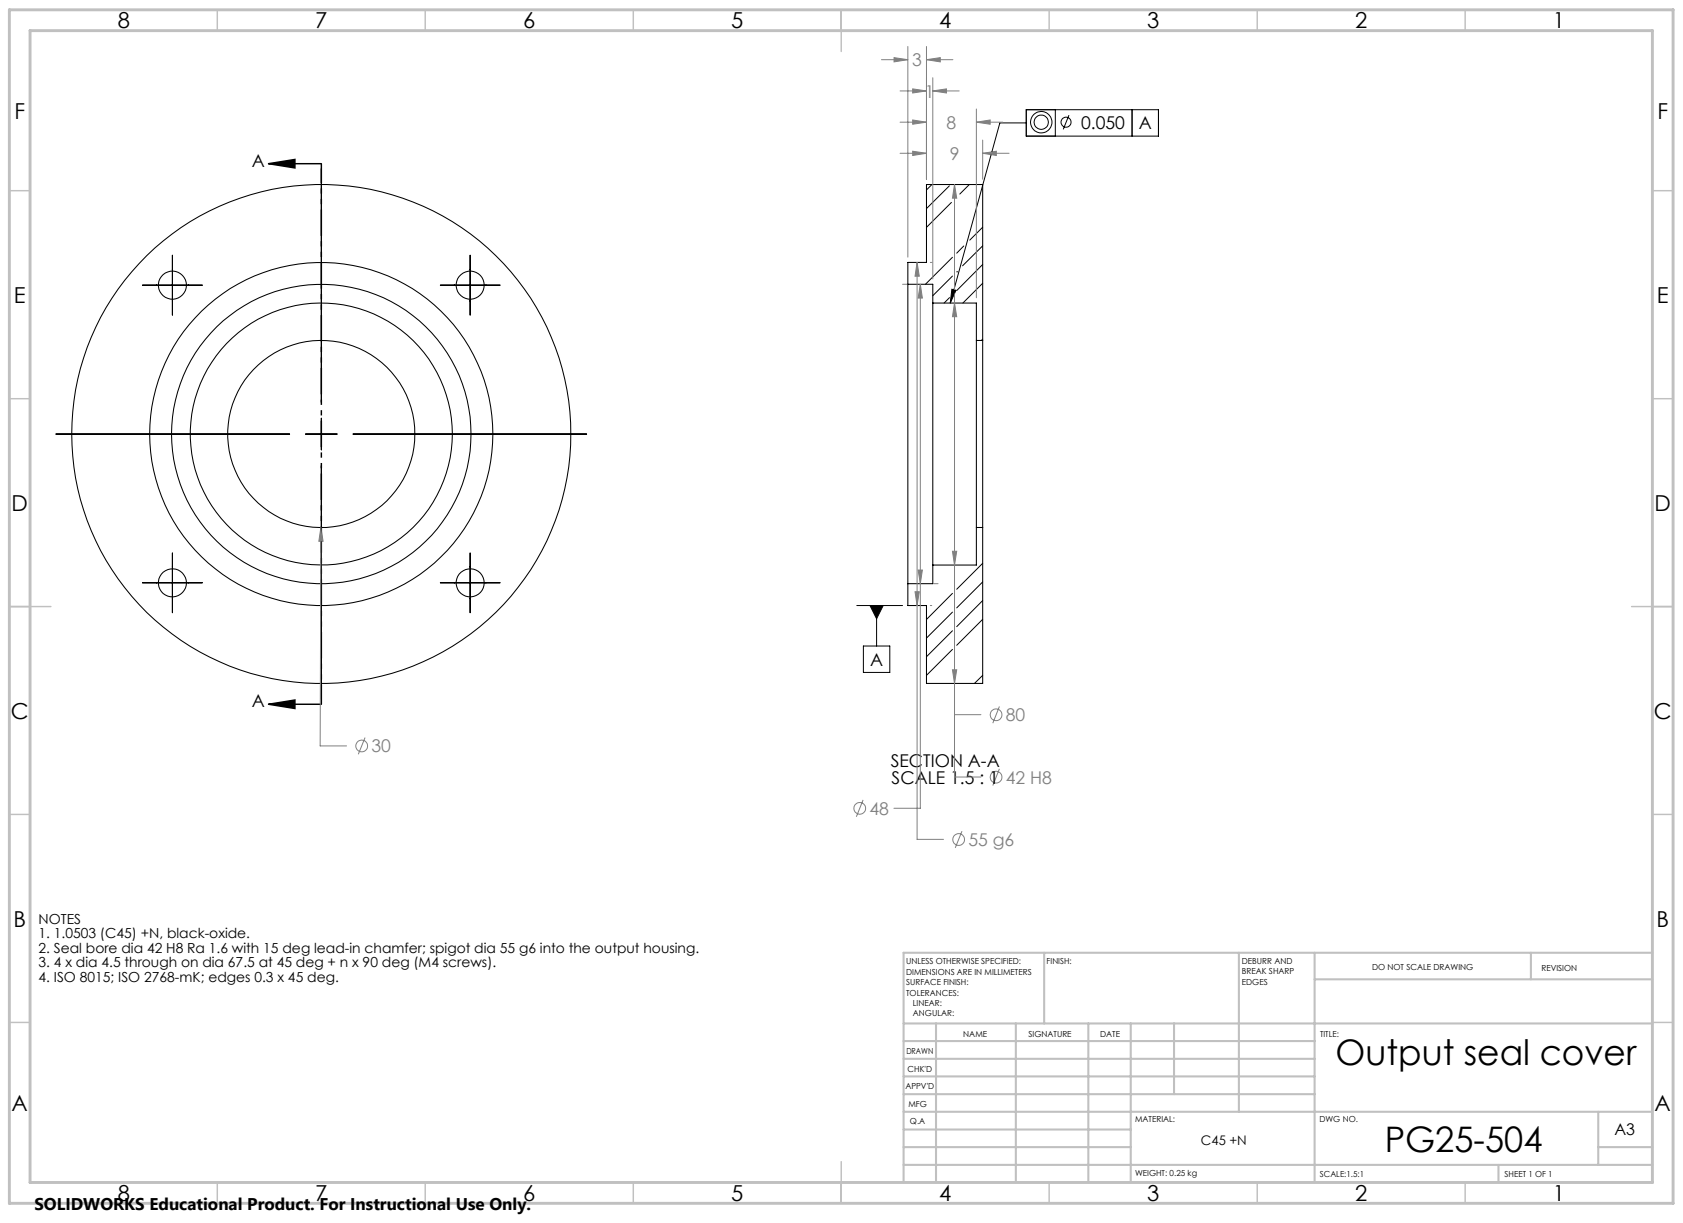
[picture p66: page 1]
SECTION A-A SCALE 1.5 : 1; FINISH:; DEBURR AND; BREAK SHARP; DO NOT SCALE DRAWING; REVISION; SCALE:1.5:1; SHEET 1 OF 1; WEIGHT: 0.25 kg

NOTES
1. 1.0503 (C45) +N, black-oxide.
2. Seal bore dia 42 H8 Ra 1.6 with 15 deg lead-in chamfer; spigot dia 55 g6 into the output housing.
3. 4 x dia 4.5 through on dia 67.5 at 45 deg + n x 90 deg (M4 screws).
4. ISO 8015; ISO 2768-mK; edges 0.3 x 45 deg.

UNLESS OTHERWISE SPECIFIED:
DIMENSIONS ARE IN MILLIMETERS
SURFACE FINISH:
TOLERANCES:
LINEAR:
ANGULAR:

NAME | SIGNATURE | DATE | | | | TITLE: Output seal cover

DRAWN
CHK'D
APPV'D
MFG
Q.A | | | | MATERIAL: | DWG NO. PG25-504 | A3 C45 +N

SOLIDWORKS Educational Product. For Instructional Use Only.
