alanarzamendi/planetary-gearbox-25-1/Calculations/03_dfma_materials.py

"""
Step 9 - DFMA analysis and materials & processes matrix for the PG25 25:1 planetary gearbox.

Writes Report/PG25_DFMA_Materials_Processes.xlsx (live formulas; Excel or LibreOffice computes them on open).
Method: Boothroyd-Dewhurst manual assembly analysis (design efficiency = 3 * N_min / total time).
Masses and quantities come from the SOLIDWORKS top assembly (read through the API, 2026-11-05).
"""
from pathlib import Path
from openpyxl import Workbook
from openpyxl.styles import Font, Alignment, PatternFill, Border, Side
from openpyxl.comments import Comment
from openpyxl.utils import get_column_letter

ROOT = Path(__file__).resolve().parents[1]
OUT = ROOT / "Report" / "PG25_DFMA_Materials_Processes.xlsx"

F = "Arial"
BLUE, BLACK, GREEN = "0000FF", "000000", "008000"
HDR_FILL = PatternFill("solid", fgColor="1F3864")
SUB_FILL = PatternFill("solid", fgColor="D9E1F2")
TOT_FILL = PatternFill("solid", fgColor="F2F2F2")
KEY_FILL = PatternFill("solid", fgColor="FFFF00")
thin = Side(style="thin", color="BFBFBF")
BOX = Border(left=thin, right=thin, top=thin, bottom=thin)


def font(color=BLACK, bold=False, size=10, italic=False):
    return Font(name=F, color=color, bold=bold, size=size, italic=italic)


def header(ws, row, titles, widths=None):
    for j, t in enumerate(titles, 1):
        c = ws.cell(row=row, column=j, value=t)
        c.font = Font(name=F, bold=True, color="FFFFFF", size=10)
        c.fill = HDR_FILL
        c.alignment = Alignment(wrap_text=True, vertical="center")
        c.border = BOX
    if widths:
        for j, w in enumerate(widths, 1):
            ws.column_dimensions[get_column_letter(j)].width = w
    ws.row_dimensions[row].height = 32


def put(ws, row, col, value, color=BLACK, bold=False, fmt=None, wrap=True, fill=None):
    c = ws.cell(row=row, column=col, value=value)
    c.font = font(color, bold)
    c.alignment = Alignment(wrap_text=wrap, vertical="top")
    c.border = BOX
    if fmt:
        c.number_format = fmt
    if fill:
        c.fill = fill
    return c


wb = Workbook()

# ---------------------------------------------------------------- Read me
ws = wb.active
ws.title = "Read me"
ws.column_dimensions["A"].width = 120
lines = [
    ("PG25 - 25:1 two-stage planetary gearbox: DFMA analysis and materials & processes matrix", True),
    ("Step 9 of COMPLETION_PLAN.md. Generated by Calculations/03_dfma_materials.py (re-run the script to rebuild).", False),
    ("", False),
    ("Sheets", True),
    ("Materials & Processes - every made part (material, heat treatment, semi-finished form, process route, critical features, why, alternative) and every purchased part, with masses.", False),
    ("B-D times - Boothroyd-Dewhurst manual handling and insertion times used by the DFMA sheets (looked up by code).", False),
    ("DFMA Current - manual assembly analysis of the design as modelled and drawn (73 parts).", False),
    ("DFMA Variant - the same sequence with the accepted DFMA changes for series production.", False),
    ("Comparison - part count, assembly time, theoretical minimum part count and design efficiency of both, plus every candidate change with its verdict.", False),
    ("", False),
    ("Legend", True),
    ("Blue text = input (quantity, code, criteria answer, CAD mass). Black text = formula. Green text = link to another sheet. Yellow fill = key result.", False),
    ("Edit only blue cells. The DFMA sheets look up handling and insertion times from the codes in 'B-D times'.", False),
    ("", False),
    ("Method", True),
    ("Boothroyd-Dewhurst DFA: for each part, three questions decide whether it must exist as a separate part:", False),
    ("  (1) does it move relative to the parts already assembled?  (2) must it be of a different material, or isolated?  (3) must it be separate for assembly or service?", False),
    ("  A part that answers 'no' to all three is a candidate for elimination or combination. N_min = sum of the parts that must exist.", False),
    ("Design efficiency E = 3 s x N_min / total manual assembly time (3 s = ideal time per part).", False),
    ("", False),
    ("Sources and assumptions", True),
    ("Handling and insertion times: Boothroyd, Dewhurst & Knight, Product Design for Manufacture and Assembly, 3rd ed., CRC Press 2011, manual handling and insertion charts (rounded values).", False),
    ("Times marked 'assumed' in 'B-D times' (heavy part, press fits, torque-wrench screws, bearing setting, sealant) are estimates for this product; they are not from the charts.", False),
    ("Quantities and masses: SOLIDWORKS top assembly Planetary_Gearbox_2_stage.SLDASM, read through the API on 2026-11-05 (master layout excluded).", False),
    ("Materials, heat treatments and decisions D-xxx: Report/Design_Rationale.html.", False),
]
for i, (t, b) in enumerate(lines, 1):
    c = ws.cell(row=i, column=1, value=t)
    c.font = font(bold=b, size=12 if i == 1 else 10)
    c.alignment = Alignment(wrap_text=True)

# ---------------------------------------------------------------- B-D times
bd = wb.create_sheet("B-D times")
header(bd, 1, ["Code", "Time [s]", "Description", "Source"], [8, 10, 70, 22])
HANDLING = [
    ("00", 1.13, "Handling: alpha+beta < 360 deg, size > 15 mm, thickness > 2 mm", "B-D chart"),
    ("01", 1.43, "Handling: alpha+beta < 360 deg, size 6-15 mm", "B-D chart"),
    ("02", 1.88, "Handling: alpha+beta < 360 deg, size < 6 mm", "B-D chart"),
    ("03", 1.69, "Handling: alpha+beta < 360 deg, thickness <= 2 mm, size > 6 mm (thin washer)", "B-D chart"),
    ("10", 1.50, "Handling: 360 <= alpha+beta < 540 deg, size > 15 mm", "B-D chart"),
    ("11", 1.80, "Handling: 360 <= alpha+beta < 540 deg, size 6-15 mm", "B-D chart"),
    ("30", 1.95, "Handling: alpha+beta = 720 deg, size > 15 mm", "B-D chart"),
    ("H2", 2.50, "Handling: heavy part (> 2 kg), two hands", "assumed"),
    ("--", 0.00, "No handling (separate operation)", "-"),
]
INSERTION = [
    ("i00", 1.5, "Insertion: added, not secured, easy to align", "B-D chart"),
    ("i01", 2.5, "Insertion: not secured, alignment needed", "B-D chart"),
    ("i03", 3.5, "Insertion: not secured, alignment and resistance", "B-D chart"),
    ("iP", 6.5, "Insertion: press fit with arbor press, aligned", "assumed"),
    ("iP2", 9.0, "Insertion: tapered bearing, cone pressed on shaft and cup pressed into housing", "assumed"),
    ("iS", 6.0, "Insertion: screw, tightened immediately", "B-D chart (38)"),
    ("iST", 8.0, "Insertion: screw or nut tightened to a specified torque (torque wrench / hook spanner)", "assumed"),
    ("iC", 6.0, "Insertion: retaining ring with pliers", "assumed"),
    ("iM", 5.0, "Insertion: ring gear fitted over three planets, teeth phased by turning the input", "assumed"),
    ("sTab", 4.0, "Separate operation: bend a lock-washer tab into the nut slot", "assumed"),
    ("sSeal", 8.0, "Separate operation: apply anaerobic sealant to one joint face", "assumed"),
    ("sSet", 90.0, "Separate operation: measure bearing stand-off, grind the cone spacer, re-assemble (selective fit)", "assumed"),
]
r = 2
for code, t, d, s in HANDLING + INSERTION:
    put(bd, r, 1, code, BLUE)
    put(bd, r, 2, t, BLUE, fmt="0.00")
    put(bd, r, 3, d)
    put(bd, r, 4, s)
    r += 1
BD_LAST = r - 1
bd.freeze_panes = "A2"

# ---------------------------------------------------------------- DFMA rows
# (group, item, part no, qty, handling code, insertion code, kind, Q1 moves, Q2 material, Q3 separate, N_min, note)
P, O = "Part", "Operation"
CURRENT = [
    ("Input subassembly", "Input shaft with sun 1 (base part)", "PG25-101", 1, "10", "i00", P, "Y", "", "", 1, "Rotates."),
    ("Input subassembly", "Deep-groove ball bearing 6201-2Z", "6201-2Z", 2, "00", "iP", P, "Y", "", "", 2, "Rolling elements move."),
    ("Input subassembly", "Retaining ring DIN 471 12x1", "DIN 471", 1, "02", "iC", P, "N", "N", "N", 0, "Fastener."),
    ("Input subassembly", "Input housing / motor adapter", "PG25-503", 1, "H2", "iP", P, "N", "Y", "Y", 1, "Motor interface; varies with the motor frame."),
    ("Input subassembly", "Radial shaft seal 12x32x7", "DIN 3760", 1, "01", "iP", P, "N", "Y", "", 1, "NBR."),
    ("Input subassembly", "Bellows coupling, clamped", "TKN 12.5", 1, "10", "iST", P, "Y", "Y", "", 1, "Accommodates motor misalignment."),
    ("Stage 1 cage", "Carrier plate 1, bridges + spline hub (base)", "PG25-205", 1, "10", "i00", P, "Y", "", "", 1, "Rotates."),
    ("Stage 1 cage", "Planet thrust washer", "PG25-206", 6, "03", "i01", P, "N", "Y", "N", 0, "Candidate: hard thrust faces on the cage instead (C2)."),
    ("Stage 1 cage", "Drawn-cup needle bearing HK1212 into planet", "HK1212", 3, "00", "iP", P, "Y", "", "", 3, "Rolling elements move."),
    ("Stage 1 cage", "Planet gear z27", "PG25-202", 3, "00", "i01", P, "Y", "", "", 3, "Rotates."),
    ("Stage 1 cage", "Planet pin d12", "PG25-203", 3, "01", "iP", P, "N", "Y", "", 3, "100Cr6 60 HRC raceway (D-009)."),
    ("Stage 1 cage", "Carrier plate 1, input side", "PG25-204", 1, "10", "i03", P, "N", "N", "Y", 1, "Closes the cage after the planets; candidate one-piece cage (C1)."),
    ("Stage 1 cage", "Cage screw ISO 4762 M5x12", "ISO 4762", 3, "11", "iS", P, "N", "N", "N", 0, "Fastener."),
    ("Stage 1 cage", "Sun 2 into the spline hub", "PG25-301", 1, "01", "i01", P, "Y", "", "", 1, "Rotates relative to stage 2 carrier."),
    ("Stage 2 cage", "Output carrier, plate + bridges + shaft (base)", "PG25-305", 1, "10", "i00", P, "Y", "", "", 1, "Rotates."),
    ("Stage 2 cage", "Planet thrust washer", "PG25-206", 6, "03", "i01", P, "N", "Y", "N", 0, "Candidate (C2)."),
    ("Stage 2 cage", "Drawn-cup needle bearing HK1212 into planet", "HK1212", 3, "00", "iP", P, "Y", "", "", 3, ""),
    ("Stage 2 cage", "Planet gear z27", "PG25-303", 3, "00", "i01", P, "Y", "", "", 3, ""),
    ("Stage 2 cage", "Planet pin d12", "PG25-304", 3, "01", "iP", P, "N", "Y", "", 3, ""),
    ("Stage 2 cage", "Carrier plate 2, input side", "PG25-306", 1, "10", "i03", P, "N", "N", "Y", 1, "Candidate one-piece cage (C1)."),
    ("Stage 2 cage", "Low-head screw DIN 7984 M5x10", "DIN 7984", 3, "11", "iS", P, "N", "N", "N", 0, "Fastener."),
    ("Output", "Tapered roller bearing 32006 X (cone + cup)", "32006 X", 2, "00", "iP2", P, "Y", "", "", 2, ""),
    ("Output", "Output housing", "PG25-501", 1, "30", "i03", P, "N", "N", "N", 0, "Theoretical candidate: merge with ring 2 (C5, rejected)."),
    ("Output", "Cone spacer, ground to setting", "PG25-401", 1, "01", "i00", P, "N", "N", "N", 0, "Sets preload; no part-count alternative without a spring preload."),
    ("Output", "Lock washer MB 6", "DIN 5406", 1, "03", "i01", P, "N", "N", "N", 0, "Candidate: self-locking nut (C7)."),
    ("Output", "Lock nut KM 6, tightened", "KM 6", 1, "01", "iST", P, "N", "N", "N", 0, "Fastener."),
    ("Output", "Bend lock-washer tab", "-", 1, "--", "sTab", O, "", "", "", 0, "Separate operation."),
    ("Output", "Bearing setting: measure, grind spacer, re-assemble", "-", 1, "--", "sSet", O, "", "", "", 0, "Separate operation (selective fit, sec. 18)."),
    ("Output", "Radial shaft seal 28x42x7", "DIN 3760", 1, "01", "iP", P, "N", "Y", "", 1, "NBR."),
    ("Output", "Output seal cover", "PG25-504", 1, "10", "i01", P, "N", "N", "Y", 0, "Needed for KM 6 access (C4 rejected); theoretical 0."),
    ("Output", "Screw ISO 4762 M4x16", "ISO 4762", 4, "11", "iS", P, "N", "N", "N", 0, "Fastener."),
    ("Housing stack", "Ring gear 1 over stage 1 planets", "PG25-201", 1, "10", "iM", P, "N", "Y", "Y", 1, "Toothed housing section (D-026)."),
    ("Housing stack", "Interstage spacer ring", "PG25-502", 1, "10", "i01", P, "N", "N", "N", 0, "Candidate: merge with ring 1 (C3)."),
    ("Housing stack", "Ring gear 2 over stage 2 planets", "PG25-302", 1, "10", "iM", P, "N", "Y", "Y", 1, ""),
    ("Housing stack", "Anaerobic sealant on joint faces", "-", 4, "--", "sSeal", O, "", "", "", 0, "Separate operation, one per joint."),
    ("Housing stack", "Dowel pin ISO 8734 6x60", "ISO 8734", 2, "01", "iP", P, "N", "N", "N", 0, "Locator."),
    ("Housing stack", "Tie bolt ISO 4762 M6x70, 10.1 N.m", "ISO 4762", 8, "11", "iST", P, "N", "N", "N", 0, "Fastener (C6: 6 bolts rejected)."),
]


def variant(rows):
    out = []
    for g, item, pn, q, hc, ic, k, q1, q2, q3, n, note in rows:
        if pn == "PG25-206":
            q, n, note = 0, 0, "Eliminated (C2): gas-nitrided cage thrust faces."
        elif pn in ("PG25-204", "PG25-306"):
            q, n, note = 0, 0, "Eliminated (C1): one-piece cage, planets inserted radially between the bridges."
        elif item.startswith("Cage screw") or item.startswith("Low-head screw"):
            q, note = 0, "Eliminated with the bolted plate (C1)."
        elif pn == "PG25-205":
            item, note = "One-piece cage 1, windows milled, spline hub (base)", "C1: pin bores line-bored through both walls in one set-up."
        elif pn == "PG25-305":
            item, note = "One-piece output cage with integral shaft (base)", "C1."
        elif pn == "PG25-502":
            q, n, note = 0, 0, "Eliminated (C3): ring 1 lengthened by 12 mm."
        elif pn == "PG25-201":
            item = "Ring gear 1 with integral spacer, over stage 1 planets"
        elif pn == "DIN 5406":
            q, note = 0, "Eliminated (C7): self-locking nut."
        elif item.startswith("Lock nut"):
            item, pn, note = "Self-locking nut KMK 6, tightened", "KMK 6", "C7: integral locking screw."
        elif item.startswith("Bend lock"):
            q, note = 0, "Eliminated with the lock washer (C7)."
        elif item.startswith("Anaerobic"):
            q, note = 3, "One joint fewer (C3)."
        out.append((g, item, pn, q, hc, ic, k, q1, q2, q3, n, note))
    return out


def dfma_sheet(name, rows, title):
    s = wb.create_sheet(name)
    s.cell(row=1, column=1, value=title).font = font(bold=True, size=12)
    cols = ["#", "Group", "Item / operation", "Part no. / standard", "Qty N", "Row type", "Handling code", "t_h per item [s]",
            "Insertion code", "t_i per item [s]", "Operation time [s]", "Q1 moves?", "Q2 different material?",
            "Q3 separate for assembly / service?", "N_min", "Note"]
    header(s, 3, cols, [5, 16, 42, 15, 7, 11, 9, 9, 9, 9, 11, 8, 10, 12, 7, 52])
    r0 = 4
    for i, (g, item, pn, q, hc, ic, k, q1, q2, q3, n, note) in enumerate(rows):
        r = r0 + i
        put(s, r, 1, i + 1)
        put(s, r, 2, g)
        put(s, r, 3, item)
        put(s, r, 4, pn)
        put(s, r, 5, q, BLUE, fmt="0")
        put(s, r, 6, k, BLUE)
        put(s, r, 7, hc, BLUE)
        put(s, r, 8, f"=INDEX('B-D times'!$B$2:$B${BD_LAST},MATCH(G{r},'B-D times'!$A$2:$A${BD_LAST},0))", GREEN, fmt="0.00")
        put(s, r, 9, ic, BLUE)
        put(s, r, 10, f"=INDEX('B-D times'!$B$2:$B${BD_LAST},MATCH(I{r},'B-D times'!$A$2:$A${BD_LAST},0))", GREEN, fmt="0.00")
        put(s, r, 11, f"=E{r}*(H{r}+J{r})", fmt="0.0")
        put(s, r, 12, q1, BLUE)
        put(s, r, 13, q2, BLUE)
        put(s, r, 14, q3, BLUE)
        put(s, r, 15, n, BLUE, fmt="0")
        put(s, r, 16, note)
    rl = r0 + len(rows) - 1
    t = rl + 2
    # summary: labels in column C, values in column E (rows t .. t+6)
    summary = [
        ("Total parts", f'=SUMIF(F{r0}:F{rl},"Part",E{r0}:E{rl})', "0"),
        ("Part line items (rows with qty > 0)", f'=COUNTIFS(F{r0}:F{rl},"Part",E{r0}:E{rl},">0")', "0"),
        ("Separate operations (count)", f'=SUMIF(F{r0}:F{rl},"Operation",E{r0}:E{rl})', "0"),
        ("Total manual assembly time [s]", f"=SUM(K{r0}:K{rl})", "0.0"),
        ("Theoretical minimum part count N_min", f"=SUM(O{r0}:O{rl})", "0"),
        ("Design efficiency E = 3 N_min / time", f"=3*E{t + 4}/E{t + 3}", "0.0%"),
        ("Candidates for elimination (parts - N_min)", f"=E{t}-E{t + 4}", "0"),
    ]
    for j, (lab, fml, fmt) in enumerate(summary):
        put(s, t + j, 3, lab, bold=True, fill=TOT_FILL)
        put(s, t + j, 5, fml, bold=True, fmt=fmt, fill=KEY_FILL if j in (0, 3, 5) else TOT_FILL)
    s.freeze_panes = "D4"
    return s, t


cur, tc = dfma_sheet("DFMA Current", CURRENT, "DFMA - current design (prototype, as modelled and drawn)")
var, tv = dfma_sheet("DFMA Variant", variant(CURRENT), "DFMA - variant with the accepted changes C1, C2, C3, C7 (series production)")

# ---------------------------------------------------------------- Comparison
cp = wb.create_sheet("Comparison")
cp.cell(row=1, column=1, value="Current design vs DFMA variant").font = font(bold=True, size=12)
header(cp, 3, ["Metric", "Current", "Variant", "Change", "Change [%]"], [44, 12, 12, 12, 12])
metrics = [("Total parts", 0, "0"), ("Part line items", 1, "0"), ("Separate operations", 2, "0"),
           ("Manual assembly time [s]", 3, "0.0"), ("Theoretical minimum N_min", 4, "0"), ("Design efficiency", 5, "0.0%")]
for i, (lab, off, fmt) in enumerate(metrics):
    r = 4 + i
    put(cp, r, 1, lab, bold=True)
    put(cp, r, 2, f"='DFMA Current'!E{tc + off}", GREEN, fmt=fmt)
    put(cp, r, 3, f"='DFMA Variant'!E{tv + off}", GREEN, fmt=fmt)
    put(cp, r, 4, f"=C{r}-B{r}", fmt=("0.0%" if fmt == "0.0%" else fmt))
    put(cp, r, 5, f"=IF(B{r}=0,0,(C{r}-B{r})/B{r})", fmt="0.0%")

r = 12
cp.cell(row=r - 1, column=1, value="Candidate changes evaluated").font = font(bold=True, size=11)
header(cp, r, ["Id", "Change", "Parts saved", "Verdict", "Reason / consequence"], None)
cp.column_dimensions["B"].width = 44
cp.column_dimensions["E"].width = 90
cands = [
    ("C1", "One-piece carrier cages, both stages (merge PG25-204/205 and PG25-305/306)", 8, "Accepted for series",
     "Removes 2 plates and 6 screws. Planets go in radially between the bridges (gap 16 mm > 15 mm face; ~48 mm opening > 43.5 mm tip "
     "diameter). The pin bores are line-bored through both walls in one set-up, which helps the Ø0.012 position tolerance. The prototype "
     "keeps bolted cages (D-021) because they are quicker to machine and inspect as single parts."),
    ("C2", "Delete the 12 thrust washers; gas-nitride the cage thrust faces (~600 HV, 0.3 mm)", 12, "Accepted for series, test first",
     "Planet thrust is small (10 % of F_t, sec. 16) but the 42CrMo4 QT faces need nitriding to resist wear. End float then comes from the "
     "16 ± 0.02 cage gap and the 15 h8 planet. Validate by a wear test before release."),
    ("C3", "Merge the interstage spacer ring into ring 1 (ring 1 + 12 mm)", 1, "Accepted",
     "One part and one sealed joint fewer. The tie-bolt embedding f_Z drops from 14 to 12 µm (sec. 17). Ring 1 needs a run-out groove "
     "for the shaping cutter."),
    ("C4", "Merge the output seal cover into the output housing", 5, "Rejected",
     "The KM 6 nut (45 mm) must be tightened through the cover opening, and the seal bore (42 mm) is too small to pass a hook spanner."),
    ("C5", "Merge ring 2 with the output housing (steel housing with internal teeth)", 1, "Rejected",
     "Conflicts with D-026/D-027: a heavier steel housing, internal teeth shaped next to the bearing bore, and the GJS damping lost."),
    ("C6", "Reduce the tie bolts from 8 to 6", 2, "Rejected",
     "Slip safety at the ring 2 | output housing joint falls from 2.01 to 1.51, below the 1.8 minimum (VDI 2230, sec. 17)."),
    ("C7", "Replace KM 6 + MB 6 with a self-locking KMK 6 nut", 1, "Accepted",
     "One part and the tab-bending operation fewer; the nut is re-usable for bearing re-setting."),
]
for i, (cid, ch, n, v, why) in enumerate(cands):
    rr = r + 1 + i
    put(cp, rr, 1, cid, bold=True)
    put(cp, rr, 2, ch)
    put(cp, rr, 3, n, BLUE, fmt="0")
    put(cp, rr, 4, v, bold=True)
    put(cp, rr, 5, why)
rr = r + 1 + len(cands)
put(cp, rr, 2, "Parts saved by the accepted changes", bold=True, fill=TOT_FILL)
put(cp, rr, 3, f'=SUMIF(D{r + 1}:D{rr - 1},"Accepted*",C{r + 1}:C{rr - 1})', bold=True, fmt="0", fill=KEY_FILL)
put(cp, rr + 1, 2, "Check: current parts - variant parts", bold=True, fill=TOT_FILL)
put(cp, rr + 1, 3, "=B4-C4", fmt="0", fill=TOT_FILL)

# ---------------------------------------------------------------- Materials & Processes
mp = wb.create_sheet("Materials & Processes", 1)
mp.cell(row=1, column=1, value="Materials and processes matrix - made parts").font = font(bold=True, size=12)
cols = ["Part no.", "Part", "Qty", "Material", "Condition / heat treatment", "Semi-finished form", "Process route",
        "Finish and critical features", "Why this material and process", "Alternative considered", "Mass each [kg]", "Mass total [kg]"]
header(mp, 3, cols, [11, 26, 5, 18, 26, 18, 46, 40, 44, 40, 9, 9])
MADE = [
    ("PG25-101", "Input shaft with sun 1, z18", 1, "18CrNiMo7-6 (1.6587)", "Case-carburised 58-62 HRC, CHD 0.3-0.5 mm, core ~1100 MPa",
     "Bar Ø32", "Turn → hob teeth → carburise, harden, temper → grind bearing seats and journal → profile-grind teeth",
     "Seats j6, coupling journal h6, radial run-out to the seats; teeth ISO 1328 grade 6", "D-007: through-hardened steel gives S_H 1.07; one material for all external gears",
     "20MnCr5 (cheaper, lower core strength); separate sun on a spline (rejected: extra joint at the input)", 0.1257),
    ("PG25-301", "Sun 2 with DIN 5480 stub, z18", 1, "18CrNiMo7-6 (1.6587)", "Case-carburised 58-62 HRC",
     "Bar Ø28", "Turn → hob teeth, hob or shape the W16x1x14 spline → carburise → grind teeth and shoulder face",
     "Shoulder face ⟂ to the axis; spline 8f; teeth grade 6", "D-007, D-020 (spline, not integral)", "Integral with the stage 1 carrier (rejected, D-020: heat treatment and assembly)", 0.0863),
    ("PG25-202 / 303", "Planet gear z27, crowned", 6, "18CrNiMo7-6 (1.6587)", "Case-carburised 58-62 HRC",
     "Bar Ø48 or forged blank", "Turn → hob → carburise → grind bore and faces → profile-grind with Cβ = 5 µm crowning",
     "Bore Ø18 N6 for HK1212; faces ⟂ 0.010; crowning 5 ± 2 µm (D-025)", "D-007; crowning per D-025", "Shaving before heat treatment (cheaper, grade 7-8: rejected for D-013 grade 6)", 0.1188),
    ("PG25-201 / 302", "Ring gear z72, housing section", 2, "42CrMo4 (1.7225)", "+QT 280-320 HB, teeth cut after tempering",
     "Ring forging or thick tube", "Turn → shape internal teeth → finish-shape/grind → drill 8 x Ø6.6 → ream dowels with the stack → black oxide",
     "Joint faces ∥ 0.010, Ra 0.8; tooth run-out to datum A and the dowels; Mdi 104.681/104.740", "D-008: S_H 2.42 without nitriding; D-026: ring is a housing section",
     "Nitrided 31CrMoV9 (rejected, D-008: cost, no gain); GJS housing with an inserted ring (rejected, D-026)", 0.6905),
    ("PG25-203 / 304", "Planet pin d12", 6, "100Cr6 (1.3505)", "Through-hardened 60 HRC (min 58)",
     "Ground bar Ø12.5", "Saw → turn chamfers → harden and temper → centreless grind → superfinish",
     "Ø12 h6, cylindricity 0.003, Ra 0.2 (needle raceway)", "D-009: the pin is the needle raceway", "Standard hardened shaft from a bearing maker (cost option; fit must stay h6)", 0.0212),
    ("PG25-204", "Carrier plate 1, input side", 1, "42CrMo4 (1.7225)", "+QT", "Plate / bar Ø100",
     "Turn → drill and jig-bore pin bores → counterbore screw holes", "Pin bores ⌖ Ø0.012 to A B", "D-019 family; D-021 bolted cage", "One-piece cage (DFMA C1)", 0.2067),
    ("PG25-205", "Carrier plate 1, bridges + spline hub", 1, "42CrMo4 (1.7225)", "+QT", "Bar Ø100",
     "Turn → mill bridges → broach or shape the internal spline → drill/tap M5 → jig-bore pin bores", "Pin bores R7 press fit (D-024); spline 9H",
     "D-021, D-024", "One-piece cage (DFMA C1)", 0.2827),
    ("PG25-305", "Output carrier with integral shaft", 1, "42CrMo4 (1.7225)", "+QT, Re >= 750 MPa (16 < d <= 40 mm)", "Bar Ø100",
     "Turn → mill bridges and MB6 slot → thread M30x1.5 → jig-bore pin bores → grind bearing seats and output journal in one set-up",
     "Ø30 k6 seats (datum A), Ø25 h6 run-out 0.010, shoulder ⟂ 0.008, pin bores ⌖ Ø0.012", "D-019, D-022: no torque joint at 209 N.m",
     "Bolted shaft + plate (rejected, D-022)", 0.8747),
    ("PG25-306", "Carrier plate 2, input side", 1, "42CrMo4 (1.7225)", "+QT", "Plate / bar Ø100",
     "Turn → jig-bore pin bores → counterbore for DIN 7984 heads", "Pin bores M6; counterbores Ø10 x 3.5", "D-021, D-024", "One-piece cage (DFMA C1)", 0.2819),
    ("PG25-206", "Planet thrust washer 12.2x24x0.4", 12, "51CrV4 (1.8159)", "Hardened and tempered 45-50 HRC", "Hardened strip 0.4 mm",
     "Fine-blank → deburr → lap", "Thickness 0.4 ± 0.02", "D-023: floating hard washer against soft carrier faces",
     "CuSn8 bronze or PTFE-faced (lower wear resistance); eliminate with nitrided cage (DFMA C2)", 0.0010),
    ("PG25-401", "Cone spacer", 1, "C45 (1.0503)", "Normalised", "Tube / bar Ø40",
     "Turn → grind faces to the measured setting (selective fit)", "Width ground to suit, faces ∥ 0.003", "Sets the TRB preload (sec. 18)",
     "Spring preload (rejected: lower stiffness)", 0.0199),
    ("PG25-501", "Output housing", 1, "EN-GJS-500-7 (0.7050)", "As cast, ferritic-pearlitic", "Sand casting",
     "Cast → rough-turn → finish-turn Ø55 J7 seats and Ø80 h7 spigot in one set-up → drill/tap M8, M6 → ream dowels with the stack → paint",
     "Seats J7 (datum A), mounting face ⟂ 0.010 A, spigot ◎ 0.020 A", "D-027: damping, castability, machinability, cost",
     "Steel weldment (no damping); 6082-T6 aluminium (rejected: expansion vs. bearing preload)", 1.7372),
    ("PG25-503", "Input housing / motor adapter", 1, "EN-GJS-500-7 (0.7050)", "As cast", "Sand casting",
     "Cast → turn Ø32 J7 seats and Ø70 H7 motor spigot → drill/tap → paint", "Motor spigot ◎ 0.030 A, motor face ⟂ 0.030 A",
     "D-027", "Aluminium 6082-T6 (lighter, acceptable: low loads on 6201 bearings); option for a lighter variant", 2.5812),
    ("PG25-502", "Interstage spacer ring", 1, "C45 (1.0503)", "Normalised", "Thick tube",
     "Turn → grind both faces → ream dowels with the stack", "Faces ∥ 0.010, Ra 0.8", "Spaces the two ring gears (D-026)",
     "Merge with ring 1 (DFMA C3)", 0.4878),
    ("PG25-504", "Output seal cover", 1, "C45 (1.0503)", "Normalised", "Bar Ø100",
     "Turn → drill 4 x M4 clearance", "Seal bore Ø42 H8", "Seal seat and nut access", "Integral with the housing (DFMA C4, rejected)", 0.2664),
]
r0 = 4
for i, row in enumerate(MADE):
    r = r0 + i
    for j, v in enumerate(row[:-1], 1):
        put(mp, r, j, v, BLUE if j == 3 else BLACK, fmt="0" if j == 3 else None)
    put(mp, r, 11, row[-1], BLUE, fmt="0.000")
    put(mp, r, 12, f"=C{r}*K{r}", fmt="0.000")
rl = r0 + len(MADE) - 1
rt = rl + 1
put(mp, rt, 2, "Made parts total", bold=True, fill=TOT_FILL)
put(mp, rt, 3, f"=SUM(C{r0}:C{rl})", bold=True, fmt="0", fill=TOT_FILL)
put(mp, rt, 12, f"=SUM(L{r0}:L{rl})", bold=True, fmt="0.000", fill=KEY_FILL)

rp = rt + 3
mp.cell(row=rp - 1, column=1, value="Purchased parts").font = font(bold=True, size=12)
header(mp, rp, ["Item", "Description", "Qty", "Material", "Standard / rating", "Supplier class", "", "", "", "", "Mass each [kg]", "Mass total [kg]"], None)
BOUGHT = [
    ("32006 X", "Tapered roller bearing", 2, "100Cr6", "ISO 355; C_r 35.8 kN (lowest catalogue)", "Bearing maker", 0.1929),
    ("HK1212", "Drawn-cup needle bearing", 6, "100Cr6", "ISO 3245; C_r 6.27 kN", "Bearing maker", 0.0132),
    ("6201-2Z", "Deep-groove ball bearing", 2, "100Cr6", "ISO 15; C_r 7.28 kN", "Bearing maker", 0.0540),
    ("KM 6 / MB 6", "Lock nut and lock washer", 2, "C45 / S235JR", "DIN 981 / DIN 5406", "Bearing maker", 0.0277),
    ("DIN 3760 A", "Radial shaft seals 12x32x7 and 28x42x7", 2, "NBR", "DIN 3760", "Seal maker", 0.0059),
    ("DIN 471", "Retaining ring 12x1", 1, "51CrV4", "DIN 471", "Standard parts", 0.0006),
    ("ISO 4762 M6x70", "Tie bolts 8.8", 8, "Steel 8.8", "ISO 4762, 10.1 N.m", "Standard parts", 0.0191),
    ("ISO 4762 M5x12", "Cage screws stage 1, 8.8", 3, "Steel 8.8", "ISO 4762", "Standard parts", 0.0041),
    ("DIN 7984 M5x10", "Low-head cage screws stage 2, 8.8", 3, "Steel 8.8", "DIN 7984", "Standard parts", 0.0031),
    ("ISO 4762 M4x16", "Seal-cover screws, 8.8", 4, "Steel 8.8", "ISO 4762", "Standard parts", 0.0028),
    ("ISO 8734 6x60", "Dowel pins, hardened", 2, "100Cr6", "ISO 8734 m6", "Standard parts", 0.0132),
    ("Bellows coupling", "Metal bellows coupling D50x68, 12/19 H7", 1, "EN-AW 2024 / stainless bellows", "T_KN >= 12.5 N.m", "Coupling maker", 0.3000),
]
for i, (it, d, q, m, std, sup, kg) in enumerate(BOUGHT):
    r = rp + 1 + i
    for j, v in enumerate((it, d, q, m, std, sup), 1):
        put(mp, r, j, v, BLUE if j == 3 else BLACK, fmt="0" if j == 3 else None)
    put(mp, r, 11, kg, BLUE, fmt="0.000")
    put(mp, r, 12, f"=C{r}*K{r}", fmt="0.000")
b0, bl = rp + 1, rp + len(BOUGHT)
bt = bl + 1
put(mp, bt, 2, "Purchased parts total", bold=True, fill=TOT_FILL)
put(mp, bt, 3, f"=SUM(C{b0}:C{bl})", bold=True, fmt="0", fill=TOT_FILL)
put(mp, bt, 12, f"=SUM(L{b0}:L{bl})", bold=True, fmt="0.000", fill=KEY_FILL)
put(mp, bt + 2, 2, "Gearbox total (coupling included)", bold=True, fill=TOT_FILL)
put(mp, bt + 2, 3, f"=C{rt}+C{bt}", bold=True, fmt="0", fill=TOT_FILL)
put(mp, bt + 2, 12, f"=L{rt}+L{bt}", bold=True, fmt="0.00", fill=KEY_FILL)
put(mp, bt + 3, 2, "of which EN-GJS castings", bold=True, fill=TOT_FILL)
cast_rows = [r0 + i for i, m in enumerate(MADE) if m[3].startswith("EN-GJS")]
put(mp, bt + 3, 12, "=" + "+".join(f"L{x}" for x in cast_rows), fmt="0.000")
mp.cell(row=bt + 5, column=1, value="Masses: SOLIDWORKS mass properties from the part material densities (bellows coupling: catalogue estimate).").font = font(italic=True)
mp.freeze_panes = "C4"

for s in wb.worksheets:
    s.sheet_view.zoomScale = 90

OUT.parent.mkdir(exist_ok=True)
wb.save(OUT)
print("written", OUT)
